npfs666/OPC_PCB/BOM + price.ods

Sheet: Carte acquisition
Reference | Qty | Value | Footprint | MF | MPN | px_x1 | px_x10 | ss tot
A1 | 1 | RaspberryPi_Pico | OPC:RaspberryPi_Pico_Common_THT_SIMPLE |  | SC1631 | 4,3 |  | 4,3
C1 | 1 | 220mF | Capacitor_THT:CP_Radial_D13,0mm_P5,00mm |  | 3-158-695 | 1,81 | 1,62 | 1,81
C2,C3,C4,C5,C6,C7,C8,C9,C11,C12 | 10 | 0,1µ 10V | Capacitor_SMD:C_0603_1608Metric_Pad1,08x0,95mm_HandSolder | Würth Elektronik | 885012206020 | 0,095 | 0,031 | 0,95
C10 | 1 | 0,1µ 10V | Capacitor_SMD:C_0603_1608Metric | Würth Elektronik | 885012206020 | 0,095 | 0,031 | 0,095
CCM1,CCM2,CCM3,CCM4 | 4 | 4,7n C0G | Capacitor_SMD:C_0805_2012Metric_Pad1,18x1,45mm_HandSolder | Murata | GCM1885C1H472JA16J | 0,129 | 0,051 | 0,516
CDi1,CDi2 | 2 | 47n C0G | Capacitor_SMD:C_1206_3216Metric_Pad1,33x1,80mm_HandSolder | Murata | GRM3195C1H473JA05D | 0,327 | 0,143 | 0,654
D1,D2 | 2 | D_Schottky | Diode_SMD:D_SMA | Vishay | B140-E3/61T | 0,318 | 0,195 | 0,636
J1,J2,J4 | 3 | 691382010004 | OPC:691382010004 | Würth Elektronik | 691382010004 | 4,6 | 0,98+3,07 | 13,8
R1,R4 | 2 | 1M | Resistor_SMD:R_0603_1608Metric_Pad0,98x0,95mm_HandSolder | Panasonic | ERJ-3EKF1004V | 0,086 | 0,021 | 0,172
R2 | 1 | 16k5 | Resistor_SMD:R_0603_1608Metric_Pad0,98x0,95mm_HandSolder | Panasonic | ERA-3ARB1652V | 0,619 | 0,446 | 0,619
R6,R7 | 2 | 3k3 | Resistor_SMD:R_0603_1608Metric_Pad0,98x0,95mm_HandSolder | Panasonic | ERA-3ARB332V | 0,344 | 0,25 | 0,688
R8,R10,R11,R12,R13 | 5 | 47 | Resistor_SMD:R_0603_1608Metric_Pad0,98x0,95mm_HandSolder | Panasonic | ERJ-3GEYJ470V | 0,086 | 0,02 | 0,43
R9 | 1 | 10k | Resistor_SMD:R_0603_1608Metric_Pad0,98x0,95mm_HandSolder | Panasonic | ERJ-3EKF1002V | 0,086 | 0,021 | 0,086
R14 | 1 | 220 | Resistor_SMD:R_0603_1608Metric_Pad0,98x0,95mm_HandSolder |  | ERJ-3GEYJ221V | 0,086 | 0,02 | 0,086
R15,R16 | 2 | 4k7 | Resistor_SMD:R_0603_1608Metric_Pad0,98x0,95mm_HandSolder | Panasonic | ERJ-3GEYJ472V | 0,086 | 0,02 | 0,172
RF1,RF2 | 2 | 6,04k | Resistor_SMD:R_0603_1608Metric_Pad0,98x0,95mm_HandSolder | Panasonic | ERA-3AED6041V | 0,086 | 0,052 | 0,172
RF3,RF4 | 2 | 5,23k | Resistor_SMD:R_0603_1608Metric_Pad0,98x0,95mm_HandSolder | Panasonic | ERA-3AEB5231V | 0,198 | 0,104 | 0,396
RN1,RN2,RN3 | 3 | 10k | Resistor_SMD:R_Array_Concave_4x0603 | Walsin | WA06X103JTL | 0,146 | 0,092 | 0,438
U1,U2,U4,U6,U9 | 5 | TS3A4751PWR | OPC:TSSOP-14_4,4x5mm_P0,65mm | Texas Instruments | TS3A4751PWR | 1,49 | 1,09 | 7,45
U3 | 1 | MCP23017x-x-ML | Package_DFN_QFN:QFN-28-1EP_6x6mm_P0,65mm_EP4,25x4,25mm | Microchip | MCP23017-E/ML | 1,58 | 1,57 | 1,58
U5 | 1 | ADS1120-PW | Package_SO:TSSOP-16_4,4x5mm_P0,65mm | Texas Instruments | ADS1120IPWR | 6,25 | 4,82 | 6,25
U7 | 1 | BMP581 | OPC:BMP581 | Bosch | BMP581 | 2,51 | 2,24 | 2,51
U8 | 1 | DS3231MZ | Package_SO:SOIC-8_3,9x4,9mm_P1,27mm |  | DS3231MZ+TRL | 10,9 | 8,57 | 10,9
 |  |  |  |  |  |  |  |  | sans options
 |  |  |  |  |  |  |  | 54,71 | 41,3

Sheet: ecran
Reference | Qty | Value | DNP | Exclude from BOM | Footprint | MF | MPN | px_1 | px_10 | ss tot
C1 | 1 | 1µ |  |  | Capacitor_SMD:C_0603_1608Metric_Pad1,08x0,95mm_HandSolder | Murata | GRM033R60G105MEA2D | 0,086 | 0,034 | 0,086
C2 | 1 | 4µ7 |  |  | Capacitor_SMD:C_0805_2012Metric_Pad1,18x1,45mm_HandSolder |  | GRM21BR71A475KE51K | 0,103 | 0,039 | 0,103
C3,C4,C5,C6 | 4 | 0,1µ |  |  | Capacitor_SMD:C_0603_1608Metric_Pad1,08x0,95mm_HandSolder | Würth Elektronik | 885012206020 | 0,095 | 0,031 | 0,38
J1,J2 | 2 | MEC1-110-02-F-D-A |  |  | OPC:SAMTEC_MEC1-110-02-F-D-A | Samtec | MEC1-110-02-F-D-A | 3,47 |  | 6,94
J3 | 1 | 1-2328724-5 |  |  | OPC:123287245 | TE Connectivity | 1-2328724-5 | 0,249 | 0,215 | 0,249
R1 | 1 | 10k |  |  | Resistor_SMD:R_0603_1608Metric_Pad0,98x0,95mm_HandSolder | Panasonic | ERJ-3EKF1002V | 0,086 | 0,021 | 0,086
R2 | 1 | 10 |  |  | PCM_Resistor_SMD_AKL:R_1206_3216Metric_Pad1,30x1,75mm | Panasonic | ERJ-U08J100V | 0,146 | 0,048 | 0,146
R3,R8,R9,R10,R11 | 5 | 6k8 |  |  | Resistor_SMD:R_0603_1608Metric_Pad0,98x0,95mm_HandSolder | Panasonic | ERJ-3EKF6801V | 0,086 | 0,021 | 0,43
R4,R5,R6,R7 | 4 | 47 |  |  | Resistor_SMD:R_0603_1608Metric_Pad0,98x0,95mm_HandSolder | Panasonic | ERJ-3GEYJ470V | 0,086 | 0,02 | 0,344
SW1 | 1 | PEC11L-4220K-S0015 |  |  | OPC:PEC11L4220KS0015 | Bourns | PEC11L-4220K-S0015 | 2,13 | 1,78 | 2,13
U1 | 1 | IPS 240*240 display |  |  |  | Mikroe | MIKROE-6588 | 12,04 | 12,04 | 12,04
 |  |  |  |  |  |  |  |  |  | 22,934

Sheet: puissance
Reference | Qty | Value | DNP | Footprint | MF | MPN | px_1 | px_10
C1,C2 | 2 | 4µ7 50V |  | Capacitor_SMD:C_1206_3216Metric |  | GRM319R61H475KA12D | 0,206 | 0,084 | 0,412
C3,C6 | 2 | 10n 100V |  | Capacitor_SMD:C_0603_1608Metric |  | GRM188R72A103MA01J | 0,086 | 0,02 | 0,172
C4 | 1 | 10µ 10V |  | Capacitor_SMD:C_0603_1608Metric_Pad1,08x0,95mm_HandSolder |  | GRM188R61A106ME69D | 0,103 | 0,04 | 0,103
C5 | 1 | 47µ 50V |  | PCM_Capacitor_SMD_AKL:CP_Elec_6,3x7,7 |  | 865080645012 | 0,292 | 0,287 | 0,292
C7,C9,C10 | 3 | 0,1µ 10V |  | Capacitor_SMD:C_0603_1608Metric_Pad1,08x0,95mm_HandSolder | Würth Elektronik | 885012206020 | 0,095 | 0,031 | 0,285
C8,C12 | 2 | 1µ 50V |  | Capacitor_SMD:C_0805_2012Metric_Pad1,18x1,45mm_HandSolder | Murata | GRM219R61H105MA73D | 0,129 | 0,052 | 0,258
C11 | 1 | 0,1µ 50V |  | Capacitor_SMD:C_0603_1608Metric_Pad1,08x0,95mm_HandSolder |  | GCM188L81H104MA57D | 0,095 | 0,035 | 0,095
C13 | 1 | 1n 2kV |  | Capacitor_SMD:C_1206_3216Metric |  | 885342208024 | 0,198 | 0,116 | 0,198
C14,C15 | 2 | 10n 100V |  | Capacitor_SMD:C_0603_1608Metric_Pad1,08x0,95mm_HandSolder |  | GRM188R72A103MA01J | 0,086 | 0,02 | 0,172
D1,D4,D5 | 3 | FR1G |  | Diode_SMD:D_SMA |  | FR1G | 0,095 | 0,066 | 0,285
D2,D3 | 2 | SMAJ33CA |  | PCM_Diode_SMD_AKL:D_SMA_TVS |  | 824501331 | 0,318 | 0,297 | 0,636
F1 | 1 | 100mA |  | Fuse:Fuse_1210_3225Metric |  | 0ZCH0010FF2E | 0,155 | 0,114 | 0,155
J4 | 1 | 1705566 |  | 1705566 | Phoenix | 1705566 | 3,2 | 3,2 | 3,2
J5,J6 | 2 | 1725672 |  | 1725672 | Phoenix | 1725672 | 2,47 | 2,47 | 4,94
K1,K2 | 2 | G6DN-1A-L DC24 |  | OPC:G6DN |  | G6DN-1A-L DC24 | 2,42 | 2,22 | 4,84
L1 | 1 | 1µ 2A |  | Inductor_SMD:L_1008_2520Metric | Taiyo yuden | MAMK2520T1R0M | 0,138 | 0,112 | 0,138
OC1 | 1 | MOCD217M |  | PCM_Package_SO_AKL:SO-8_3,9x6,2mm_P1,27mm |  | MOCD217M | 0,869 | 0,573 | 0,869
Q1,Q2 | 2 | 2N7002 |  | PCM_Package_TO_SOT_SMD_AKL:SOT-23 | Toshiba | T2N7002BK,LM |  |  | 0
R2,R5 | 2 | 560 |  | Resistor_SMD:R_0603_1608Metric |  | ERJ-3GEYJ560V | 0,086 | 0,02 | 0,172
R3,R6 | 2 | 2k4 |  | Resistor_SMD:R_0805_2012Metric_Pad1,20x1,40mm_HandSolder |  | ERJ-6GEYJ242V | 0,086 | 0,025 | 0,172
R7 | 1 | 33k |  | Resistor_SMD:R_0603_1608Metric_Pad0,98x0,95mm_HandSolder |  | ERJ-3GEYJ333V | 0,086 | 0,02 | 0,086
R8,R12 | 2 | 47k |  | Resistor_SMD:R_0603_1608Metric_Pad0,98x0,95mm_HandSolder |  | ERJ-3GEYJ473V | 0,086 | 0,02 | 0,172
R9,R13 | 2 | 470 |  | Resistor_SMD:R_0603_1608Metric_Pad0,98x0,95mm_HandSolder |  | ERJ-3GEYJ470V | 0,086 | 0,02 | 0,172
R10,R11 | 2 | 1k5 |  | Resistor_SMD:R_0603_1608Metric_Pad0,98x0,95mm_HandSolder |  | ERJ-3GEYJ152V | 0,086 | 0,02 | 0,172
RV1,RV2 | 2 | MOV-07D391KKTR |  | Varistor:RV_Disc_D9mm_W3,9mm_P5mm | Bourns | MOV-07D391KKTR | 0,129 | 0,078 | 0,258
TP1,TP2 | 2 | TestPoint |  | TestPoint:TestPoint_Pad_2,0x2,0mm |  |  |  |  | 0
U1 | 1 | SIP-4_1779205311 |  | PCM_MagIC_THT_Wurth:U_Wurth_WPME-FISM-SIP-4_1779405311 |  | 1779205311 | 2,73 | 2,51 | 2,73
U2 | 1 | ISO1212 |  | Package_SO:SSOP-16_3,9x4,9mm_P0,635mm |  | ISO1212DBQR | 1,14 | 0,828 | 1,14
U3 | 1 | DRV81545PWPR |  | OPC:U_TSSOP_PWP0020AC_TEX |  | DRV81545PWPR | 2,43 | 1,81 | 2,43
U4 | 1 | ISO6420FDR |  | Package_SO:SOIC-8_3,9x4,9mm_P1,27mm |  | ISO6420FDR | 1,26 | 0,92 | 1,26
U5 | 1 | TLV709A50DBVR |  | Package_TO_SOT_SMD:SOT-23-5 |  | TLV709A50DBVR | 0,499 | 0,352 | 0,499
 |  |  |  |  |  |  |  |  | 26,313
