npfs666/OPC_PCB/3D/Assemblage.FCStd

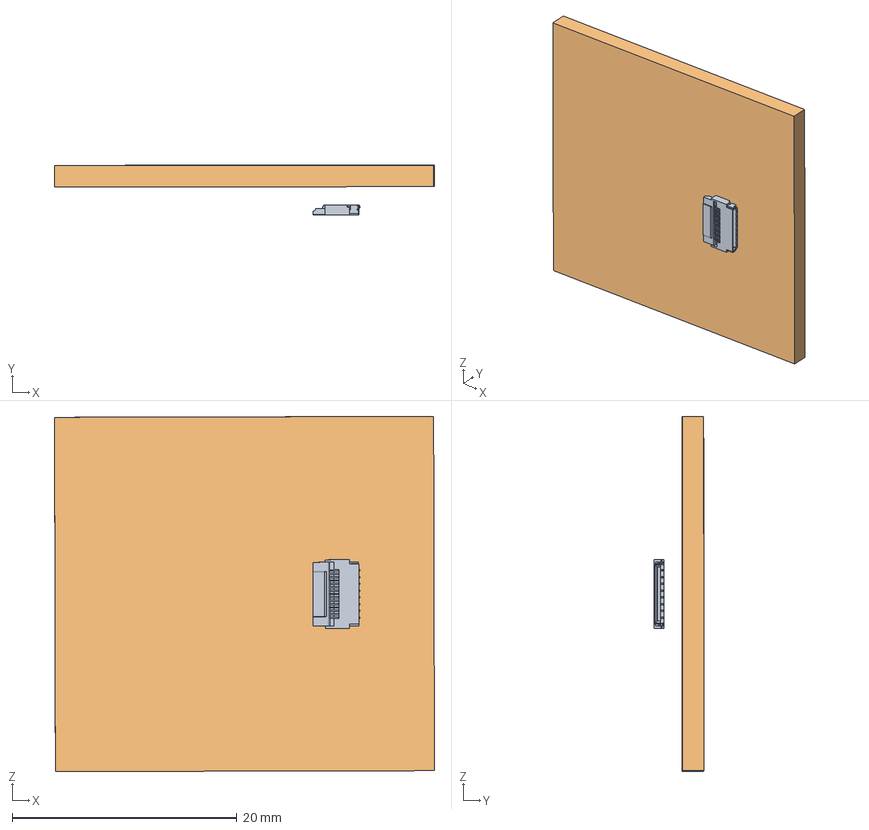
[picture p1: CAD file, 2026-10-04]
3D/Assemblage.FCStd
33.8 x 4.44 x 31.6 mm
FH35-15S-0.3SHW
Extruded
Extruded001
