npfs666/OPC_PCB/3D/6mm knob.FCStd

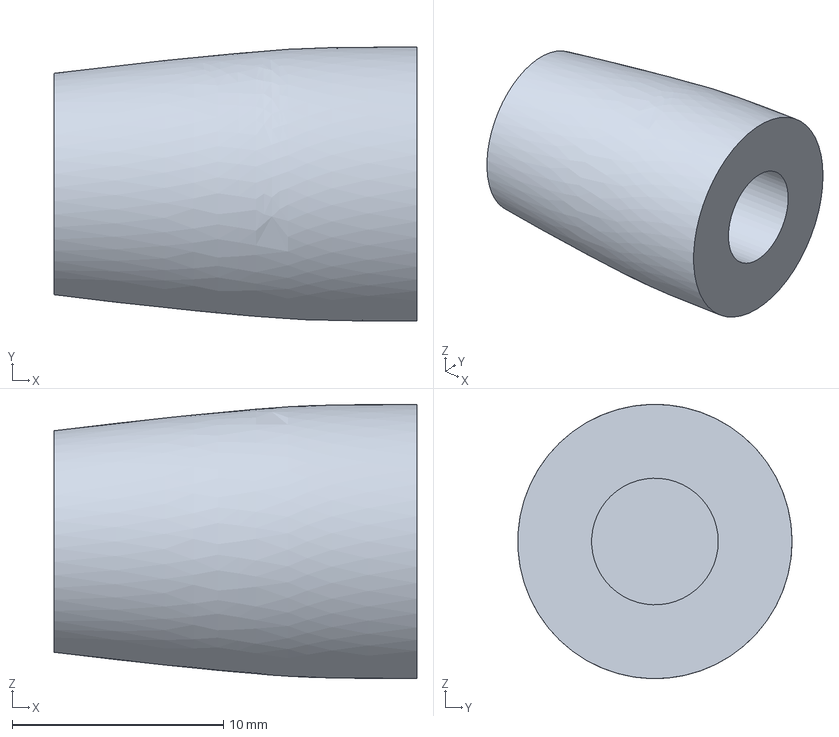
[picture p2: CAD file, 2026-10-04]
3D/6mm knob.FCStd
17.2 x 13.0 x 13.0 mm
