npfs666/OPC_PCB/3D/STL prints/Boite Mesure-Body.step

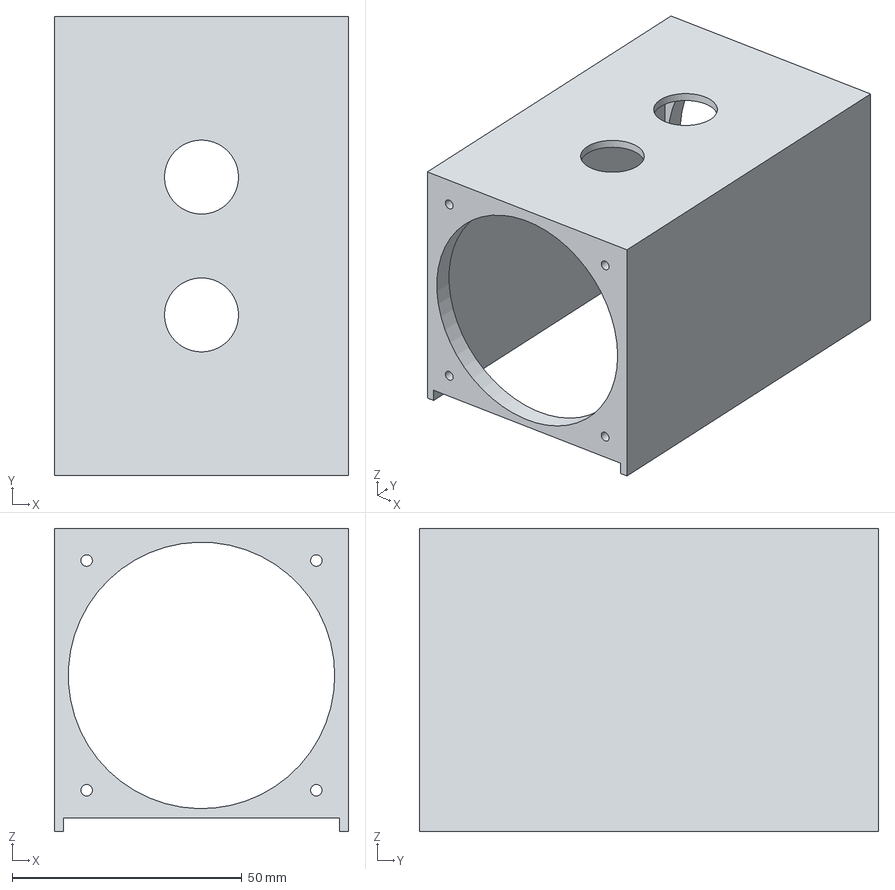
[picture p3: CAD file, 2026-10-04]
3D/STL prints/Boite Mesure-Body.step
64.0 x 100.0 x 66.0 mm
