npfs666/OPC_PCB/3D/Boitier_OPC.FCStd

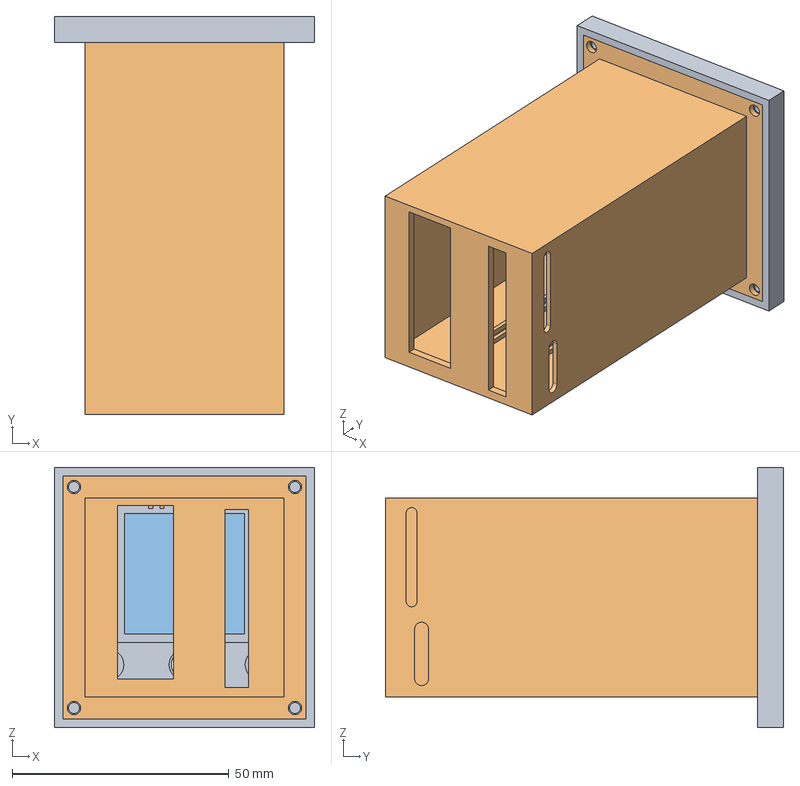
[picture p5: CAD file, 2026-10-04]
3D/Boitier_OPC.FCStd
60.0 x 91.9 x 60.0 mm
Facade
Arriere
Vitre
