npfs666/OPC_PCB/3D/STL prints/Boitier_OPC-Facade45.step

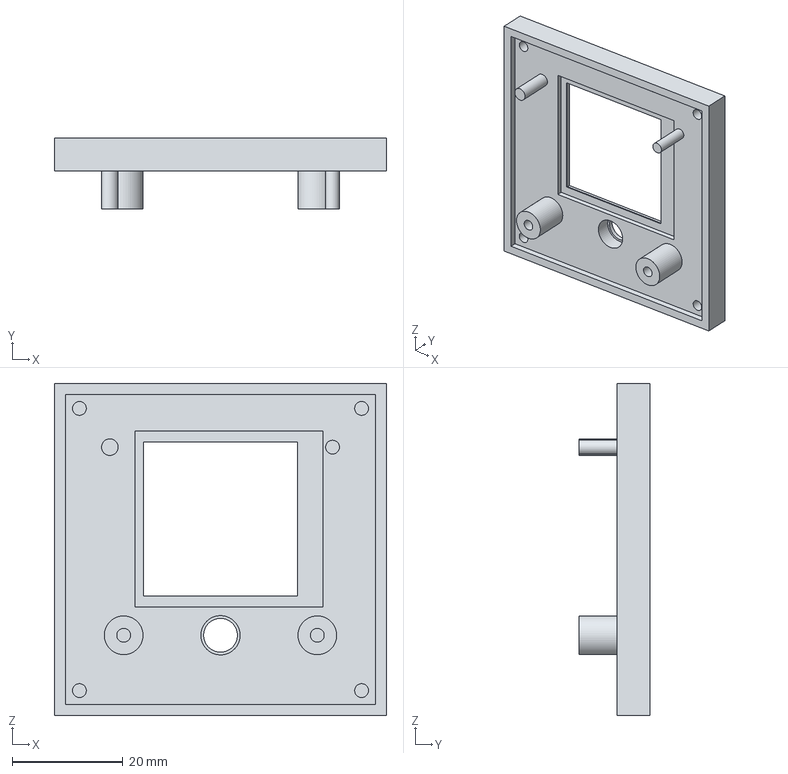
[picture p6: CAD file, 2026-08-16]
3D/STL prints/Boitier_OPC-Facade45.step
60.0 x 12.9 x 60.0 mm
