npfs666/OPC_PCB/3D/PCB_ecran.FCStd

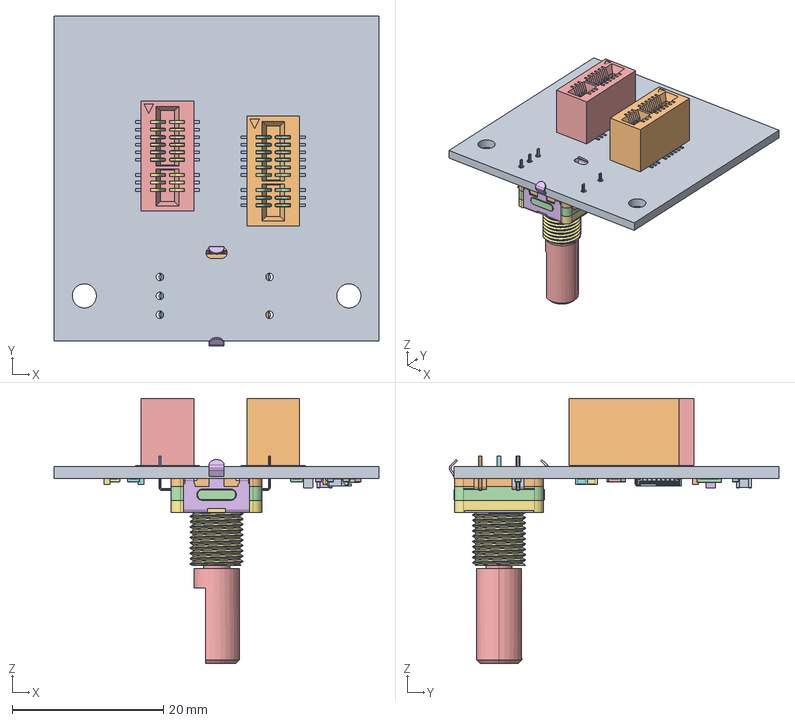
[picture p7: CAD file, 2026-08-16]
3D/PCB_ecran.FCStd
43.0 x 43.6 x 35.1 mm
Pcb_9aaa
MEC1-110-02-F-D-A_terminal
MEC1-C-113-02-F-10_pin
MEC1-C-113-02-F-102_pin
MEC1-110-02-F-D-A_terminal001
MEC1-C-113-02-F-10_pin001
MEC1-C-113-02-F-102_pin001
C6_C_0603_1608Metric_2552904a9884
J3_C-1-2328724-5_19a50cf26e37
R5_R_0603_1608Metric_0a1e323faf72
R6_R_0603_1608Metric_497e6d2832c1
R2_R_1206_3216Metric_877dde5deaf9
R4_R_0603_1608Metric_065002c58806
C2_C_0805_2012Metric_6c8c6bc15dad
C5_C_0603_1608Metric_723fca460faf
R1_R_0603_1608Metric_dbec9712c61c
PEC11L-4220F-S0015
PEC11L-4220F-S0016
PEC11L-4220F-S0017
PEC11L-4220F-S0018
PEC11L-4220F-S0019
PEC11L-4220F-S0020
PEC11L-4220F-S0021
PEC11L-4220F-S0022
PEC11L-4220F-S0023
PEC11L-4220F-S0024
R3_R_0603_1608Metric_c50a7346d287
R9_R_0603_1608Metric_962ce42e6f63
R10_R_0603_1608Metric_915b5a0c96dd
R7_R_0603_1608Metric_e5aef8b9e686
R8_R_0603_1608Metric_b2a26d5552b2
R11_R_0603_1608Metric_a8d6c201e3ff
C1_C_0805_2012Metric_96cc4482445c
C3_C_0603_1608Metric_796de0005f35
C4_C_0603_1608Metric_e30e64fcb925
