npfs666/OPC_PCB/3D/STL prints/Boitier_OPC-Vitre.step

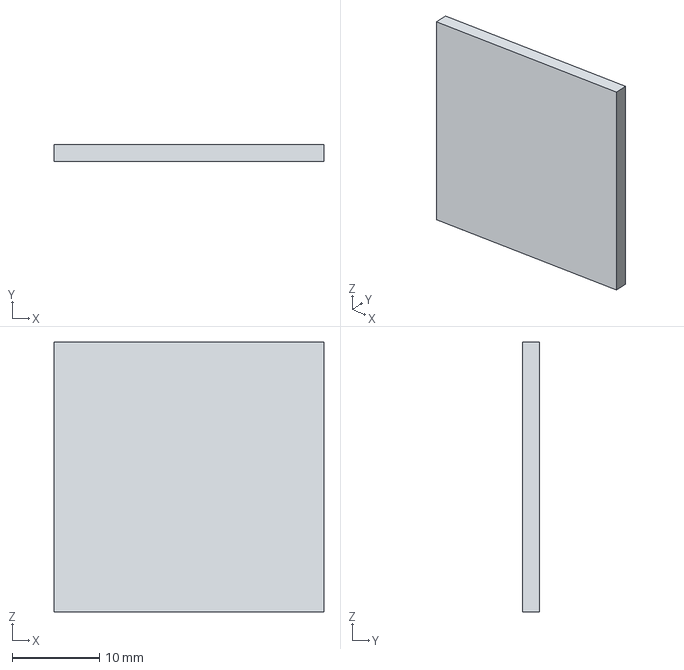
[picture p8: CAD file, 2026-08-16]
3D/STL prints/Boitier_OPC-Vitre.step
31.0 x 2.00 x 31.0 mm
