npfs666/OPC_PCB/3D/PCB_Sensor.FCStd

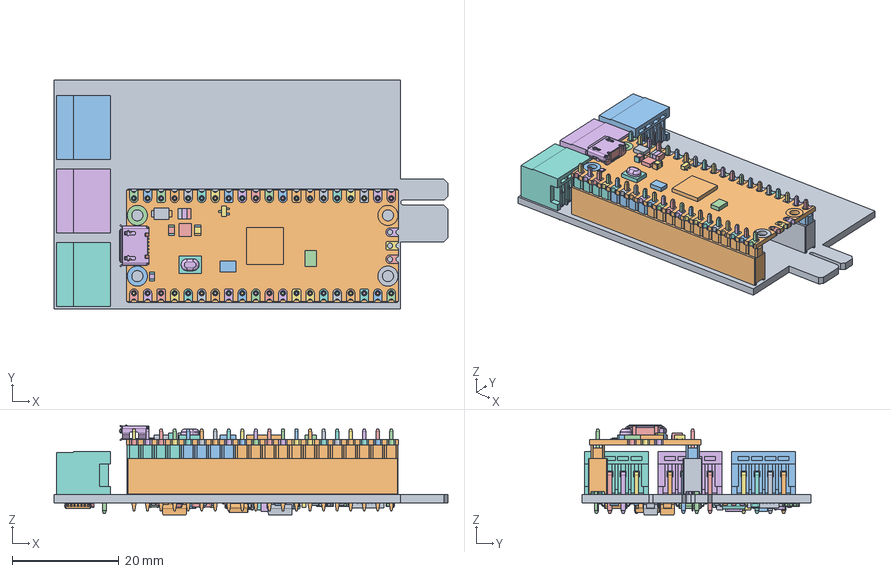
[picture p9: CAD file, 2026-08-16]
3D/PCB_Sensor.FCStd
73.9 x 43.0 x 16.9 mm
Pcb_7baf
6913820100xx_PIN
6913820100xx_PIN001
6913820100xx_PIN002
6913820100xx_PIN003
6913820100xx_PIN004
6913820100xx_PIN005
6913820100xx_PIN006
6913820100xx_PIN007
6913820100xx_PIN008
6913820100xx_PIN009
6913820100xx_PIN010
6913820100xx_PIN011
20 pin female header
20 pin female header001
BASE, 2
BASE, 001
PIN, 2
PIN, 001
PIN, 002
PIN, 003
PIN, 004
PIN, 005
PIN, 006
PIN, 007
PIN, 008
PIN, 009
PIN, 010
PIN, 011
PIN, 012
PIN, 013
PIN, 014
PIN, 015
BASE, 003
BASE, 004
PIN, 016
PIN, 017
PIN, 018
PIN, 019
PIN, 020
PIN, 021
PIN, 022
PIN, 023
PIN, 024
PIN, 025
PIN, 026
PIN, 027
PIN, 028
PIN, 029
PIN, 030
PIN, 031
CCM3_C_0805_2012Metric_d980f71a589e
C8_C_0603_1608Metric_d53725665cb9
R11_R_0603_1608Metric_c4df503dc09c
U9_TSSOP_14_44x5mm_P065mm_3e52fa5831e7
R12_R_0603_1608Metric_dfbaef41468b
C3_C_0603_1608Metric_79f205ab488b
C7_C_0603_1608Metric_75332eca0edc
C10_C_0603_1608Metric_9cd8411a2588
C2_C_0603_1608Metric_f4a086c790f2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
