npfs666/OPC_PCB/3D/STL prints/Boitier_OPC-Slice_2.step

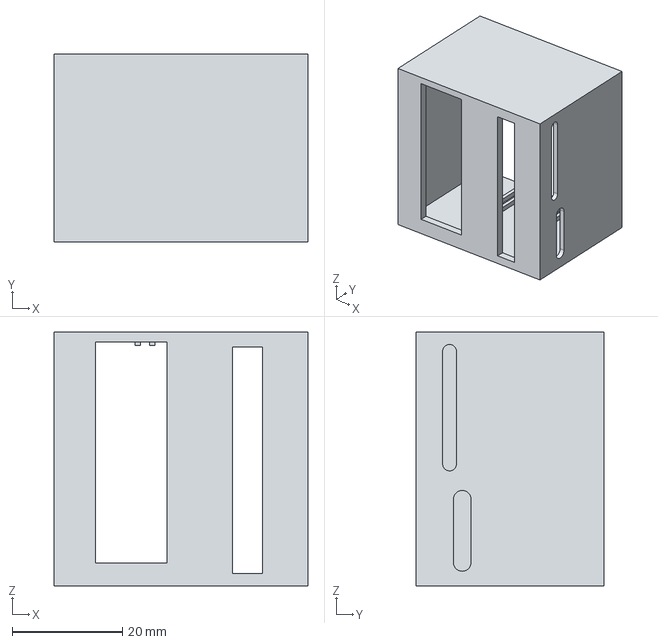
[picture p10: CAD file, 2026-08-16]
3D/STL prints/Boitier_OPC-Slice_2.step
46.0 x 34.0 x 46.0 mm
