npfs666/OPC_PCB/3D/PCB_puissance.FCStd

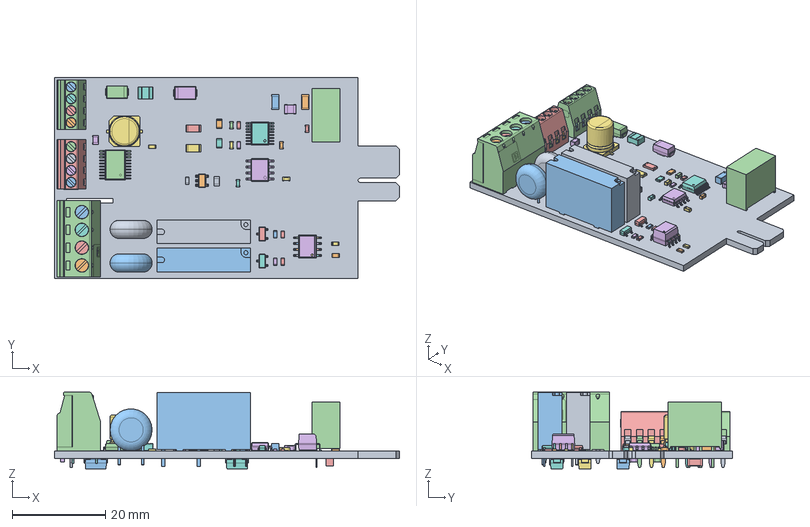
[picture p11: CAD file, 2026-08-16]
3D/PCB_puissance.FCStd
73.9 x 43.0 x 16.4 mm
Pcb_7ee1
U5_SOT_23_5_db93839da8bd
K2_G6DN_1A_1eaa12ef6025
D1_D_SMA_ead7eee86b1e
R2_R_0603_1608Metric_72819c8fc875
U4_SOIC_8_39x49mm_P127mm_66c8ce6ac40a
R6_R_1206_3216Metric_ccbe725341a1
Q1_SOT_23_8c6504fbc0d0
L1_L_1008_2520Metric_82d9ebbb4115
R7_R_0603_1608Metric_d6ba43f05b82
Q2_SOT_23_b353400c8843
C12_C_0805_2012Metric_e3668163eefe
C2_C_1206_3216Metric_8e86de64821f
C1_C_1206_3216Metric_89a4e08c66be
U1_1779205211_transformed_cba61204e552
R9_R_0603_1608Metric_76b49f282753
C8_C_0805_2012Metric_ccc1b0032e88
C5_CP_Elec_63x77_e46e0a750ea6
F1_Fuse_1210_3225Metric_23aa0c04b2ee
K1_G6DN_1A_cf8bbd98a6a8
R11_R_0603_1608Metric_baf0d1365cc7
R8_R_0603_1608Metric_1685e2c74f9a
U3_HTSSOP_20_1EP_44x65mm_P065mm_EP34x65mm_Mask275x343mm_5fb93dbf0cd6
C4_C_0603_1608Metric_a2565f49aee5
R12_R_0603_1608Metric_c193ec158065
C9_C_0603_1608Metric_ea4e39f511a3
C10_C_0603_1608Metric_e35af573af21
R5_R_0603_1608Metric_72aadfdc2f61
R10_R_0603_1608Metric_472293205d83
R13_R_0603_1608Metric_e67fa9fbaa23
FOD8012A
FOD8012A001
FOD8012A002
FOD8012A003
FOD8012A004
FOD8012A005
FOD8012A006
FOD8012A007
FOD8012A008
FOD8012A009
U2_SSOP_16_39x49mm_P0635mm_dab7feac6744
RV1_RV_Disc_D9mm_W39mm_P5mm_5f8b049132af
R1_R_0805_2012Metric_082767cc33e7
RV2_RV_Disc_D9mm_W39mm_P5mm_5016e79d4bc0
C3_C_0603_1608Metric_83b09f9fbce3
R3_R_1206_3216Metric_9395171baa16
D2_D_SMA_172067eb3ad8
C6_C_0603_1608Metric_04c9d46bab36
R4_R_0805_2012Metric_cb24a76329c7
C11_C_0603_1608Metric_73f2376235a9
C7_C_0603_1608Metric_e459c9bc8b46
D3_D_SMA_5956bfb86b07
C14_C_0603_1608Metric_9c92008615f6
C13_C_1206_3216Metric_ac10733bc9e7
C15_C_0603_1608Metric_935e547a122e
D4_D_SMA_7b4a95e975e1
D5_D_SMA_3df182d4667d
