npfs666/OPC_PCB/3D/STL prints/Boitier_OPC-Slice.55.step

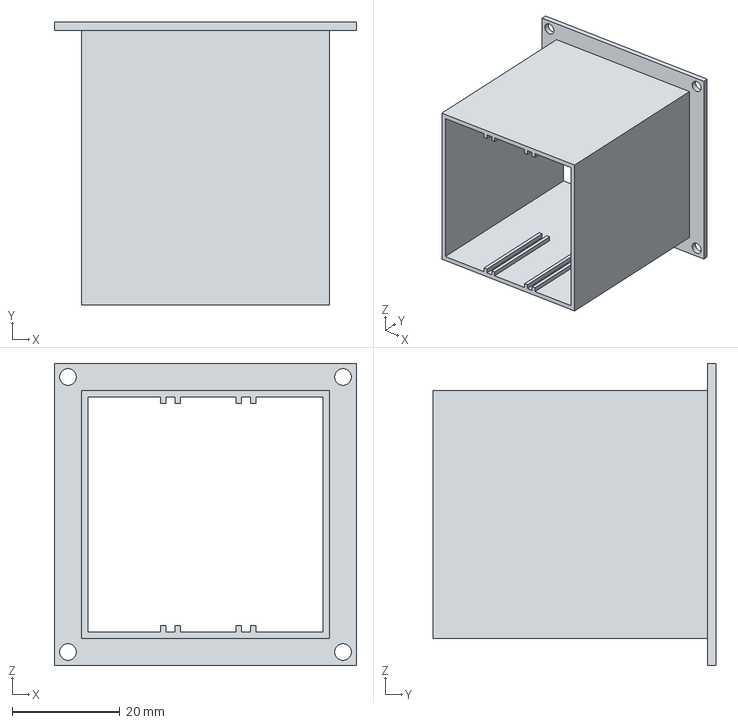
[picture p12: CAD file, 2026-08-16]
3D/STL prints/Boitier_OPC-Slice.55.step
56.0 x 52.4 x 56.0 mm
