npfs666/OPC_PCB/3D/STL prints/Boitier_OPC-Slice.45.step

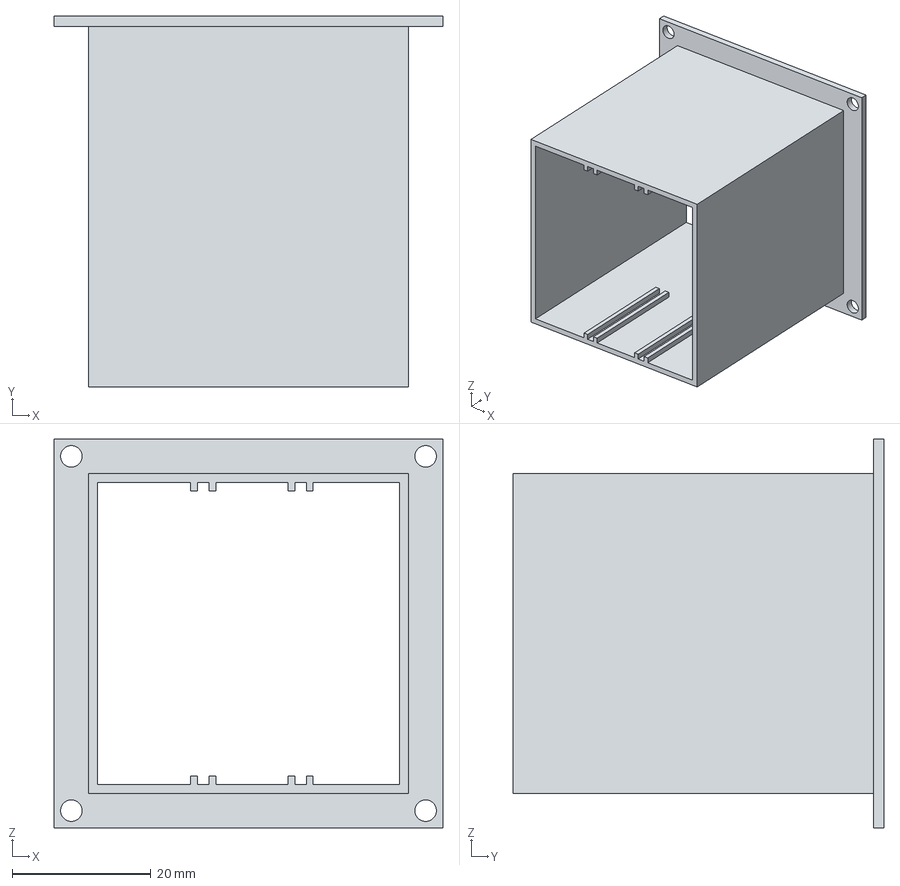
[picture p13: CAD file, 2026-08-16]
3D/STL prints/Boitier_OPC-Slice.45.step
56.0 x 53.4 x 56.0 mm
