npfs666/OPC_PCB/3D/Boitier 3D.FCStd

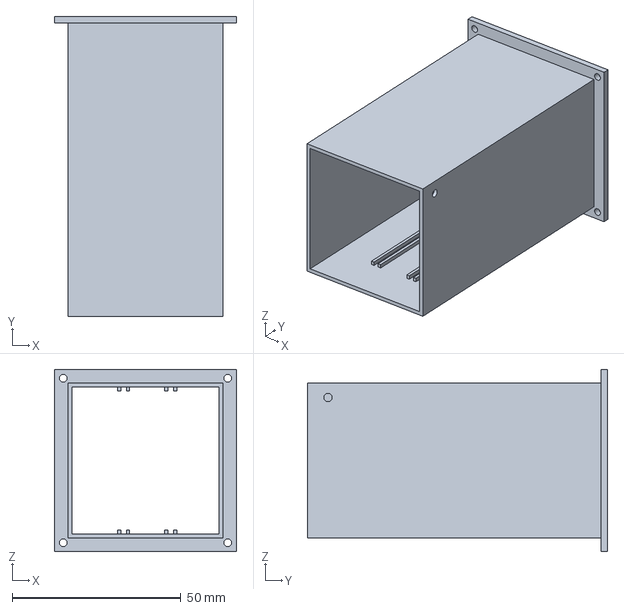
[picture p14: CAD file, 2026-08-11]
3D/Boitier 3D.FCStd
54.0 x 89.0 x 54.0 mm
