npfs666/OPC_PCB/3D/STL prints/OPC_facade_0.1.step

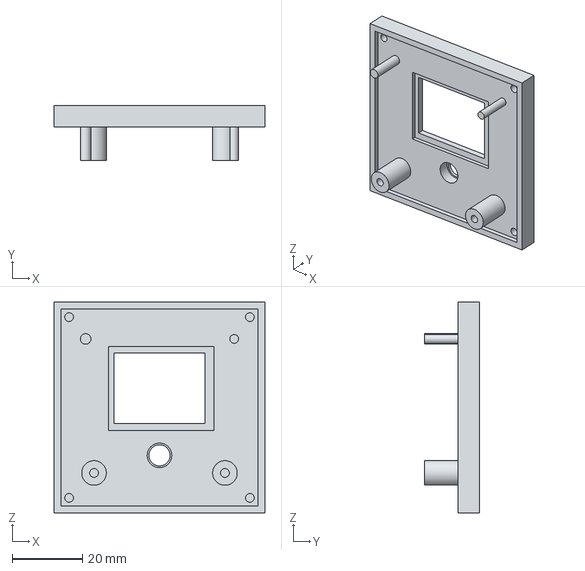
[picture p15: CAD file, 2026-08-14]
3D/STL prints/OPC_facade_0.1.step
60.0 x 15.5 x 60.0 mm
