npfs666/OPC_PCB/3D/ecran.FCStd

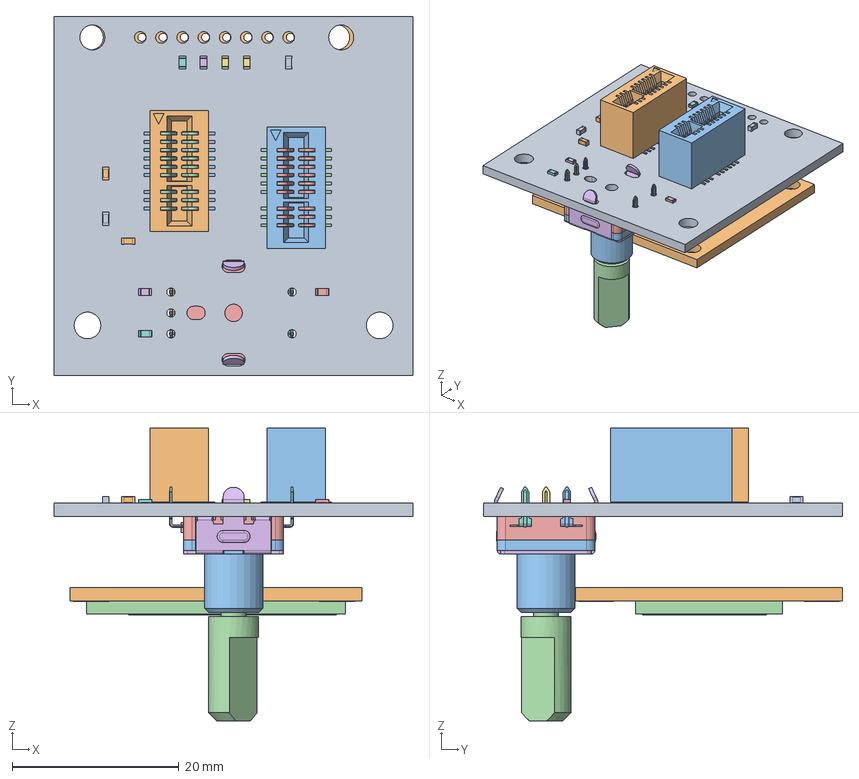
[picture p16: CAD file, 2026-08-07]
3D/ecran.FCStd
43.0 x 43.0 x 35.1 mm
Pcb_fb9e
C13_C_0603_1608Metric_2552904a9884
MEC1-110-02-F-D-A_terminal
MEC1-C-113-02-F-10_pin
MEC1-C-113-02-F-102_pin
R12_R_0603_1608Metric_0a1e323faf72
R14_R_0603_1608Metric_497e6d2832c1
R11_R_0603_1608Metric_0ae304a62e9f
C14_C_0603_1608Metric_723fca460faf
MEC1-110-02-F-D-A_terminal001
MEC1-C-113-02-F-10_pin001
MEC1-C-113-02-F-102_pin001
R16_R_0603_1608Metric_962ce42e6f63
R17_R_0603_1608Metric_915b5a0c96dd
R13_R_0603_1608Metric_e5aef8b9e686
R18_R_0603_1608Metric_a8d6c201e3ff
C12_C_0603_1608Metric_796de0005f35
C15_C_0603_1608Metric_e30e64fcb925
EC11-Base
EC11-Shaft-F
EC11-Housing-THT
EC11-Housing-THT001
EC11-Housing-THT002
EC11-Housing-THT003
EC11-Housing-THT004
EC11-Housing-THT005
EC11-Housing-THT006
Dalle LCD approx. 31 x 17.6 mm
Zone active 24.912 x 14.864 mm
Pastille connecteur 8
Pastille connecteur 7
Pastille connecteur 6
Pastille connecteur 5
Pastille connecteur 4
Pastille connecteur 3
Pastille connecteur 2
Pastille connecteur 1
Pastille fixation 4
Pastille fixation 3
Pastille fixation 2
Pastille fixation 1
PCB 35 x 32 x 1.6 mm
