npfs666/OPC_PCB/3D/STL prints/Barofnet-back.stl

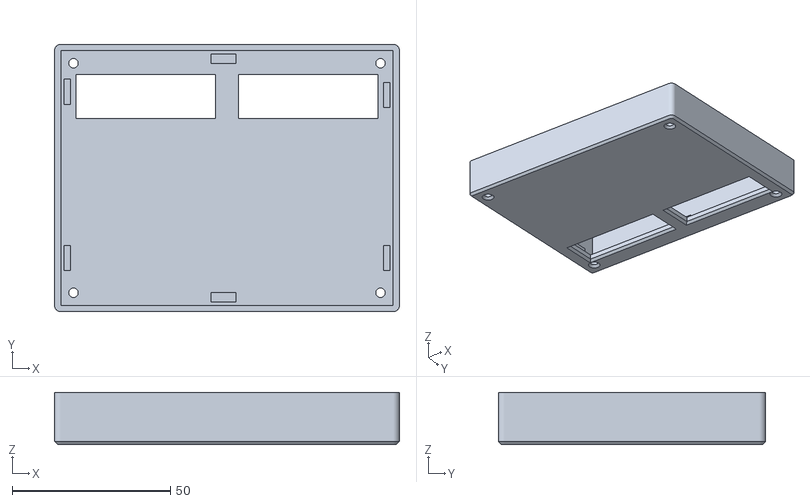
[picture p17: CAD file, 2026-08-14]
3D/STL prints/Barofnet-back.stl
109.0 x 84.5 x 16.5
