npfs666/OPC_PCB/3D/STL prints/Barofnet-front.stl

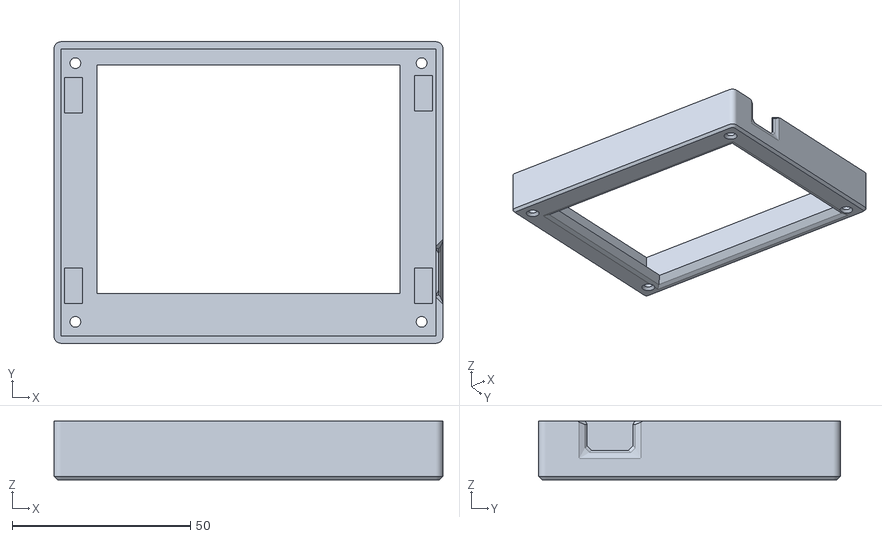
[picture p18: CAD file, 2026-08-14]
3D/STL prints/Barofnet-front.stl
109.0 x 84.5 x 16.5
