npfs666/OPC_PCB/(list of files, cad)

Other CAD files:
3D/Boite Mesure.FCStd
3D/STL prints/Boite Mesure-haut.stl
3D/Old opc/OPC.FCStd
3D/Old opc/OPC_test_save.FCStd
3D/Old opc/assembly.FCStd
