npfs666/OPC_PCB/Pdf/Carte entrée.pdf

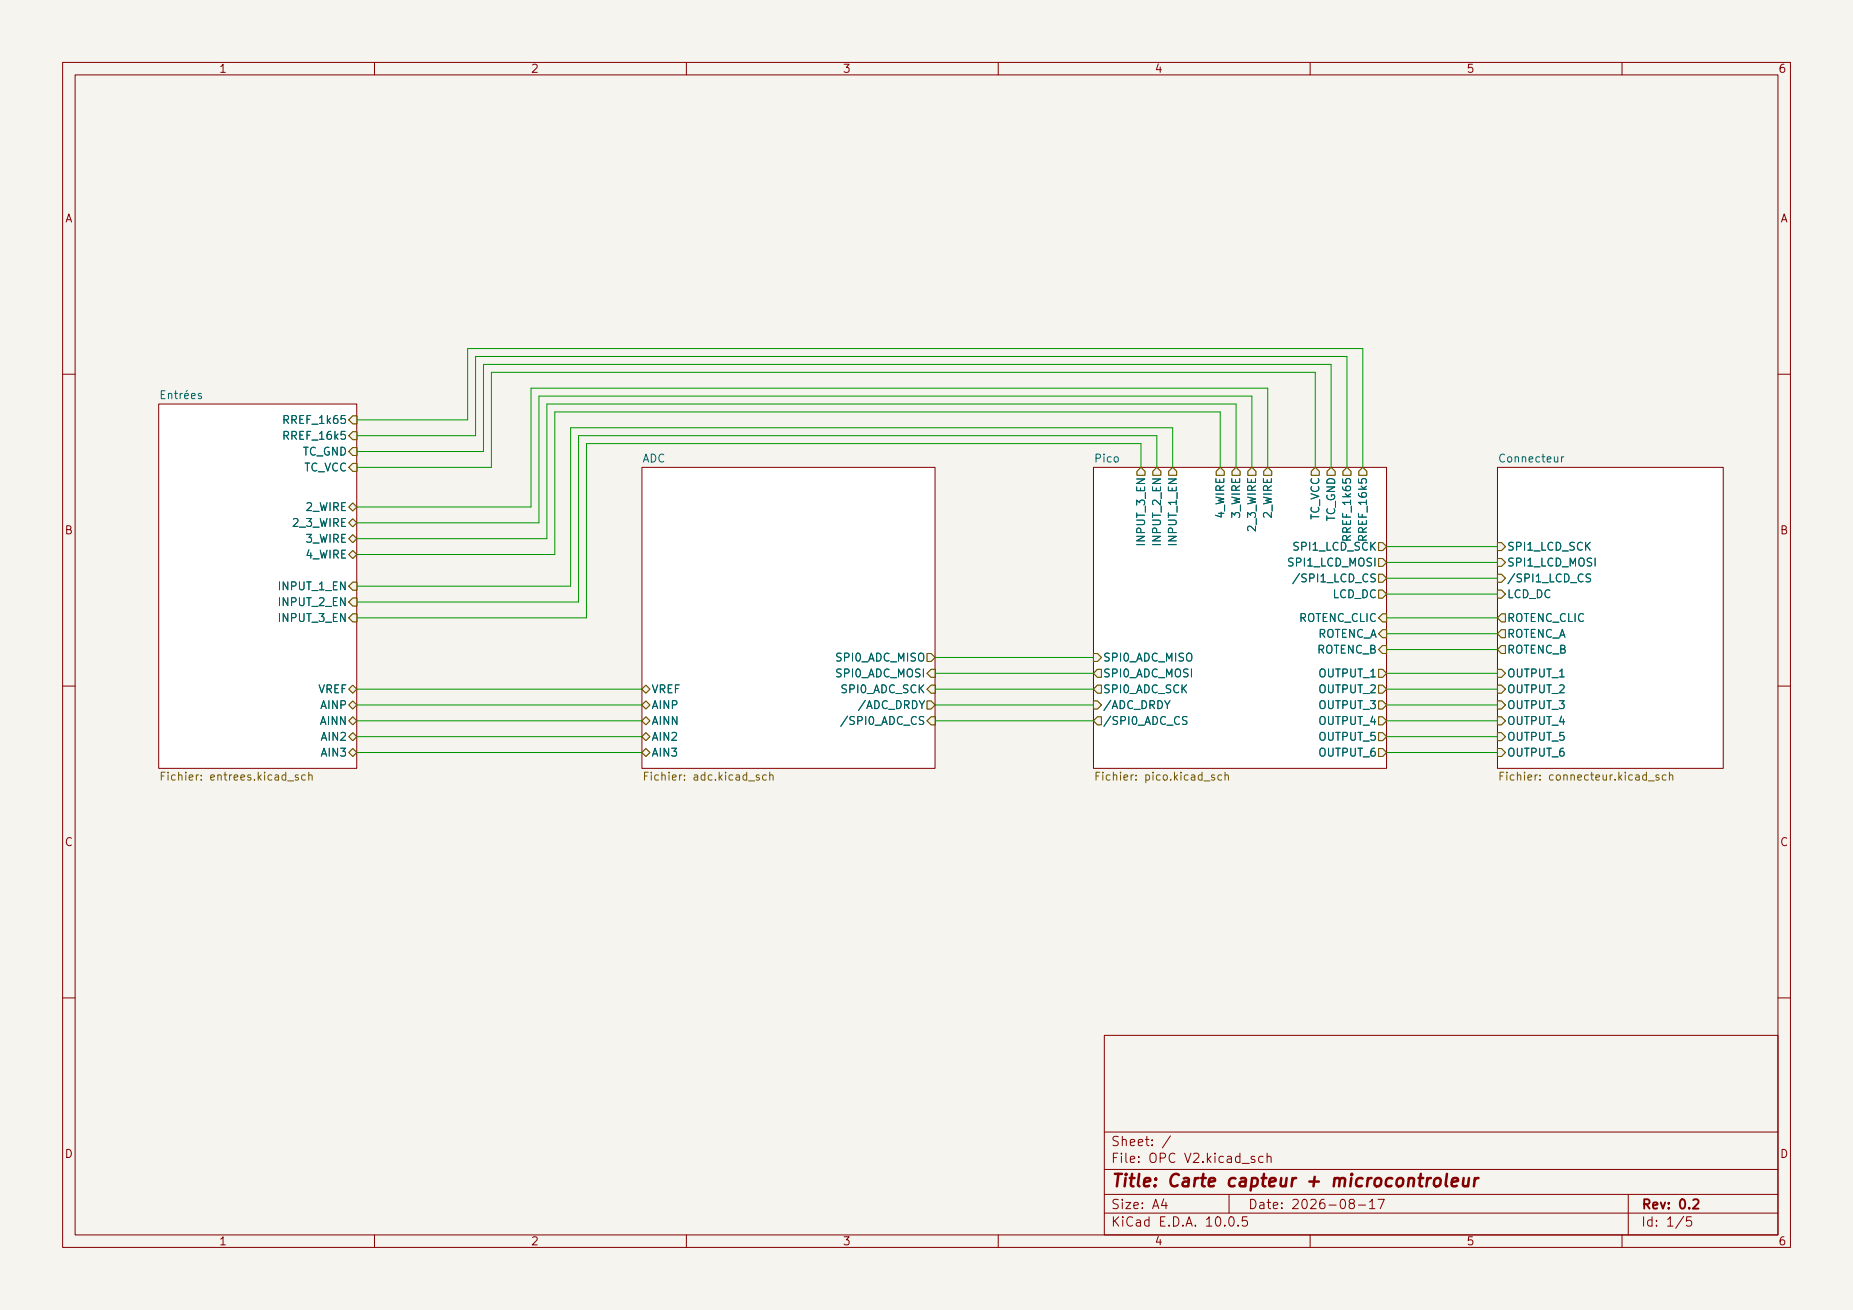
[picture p19: page 1]

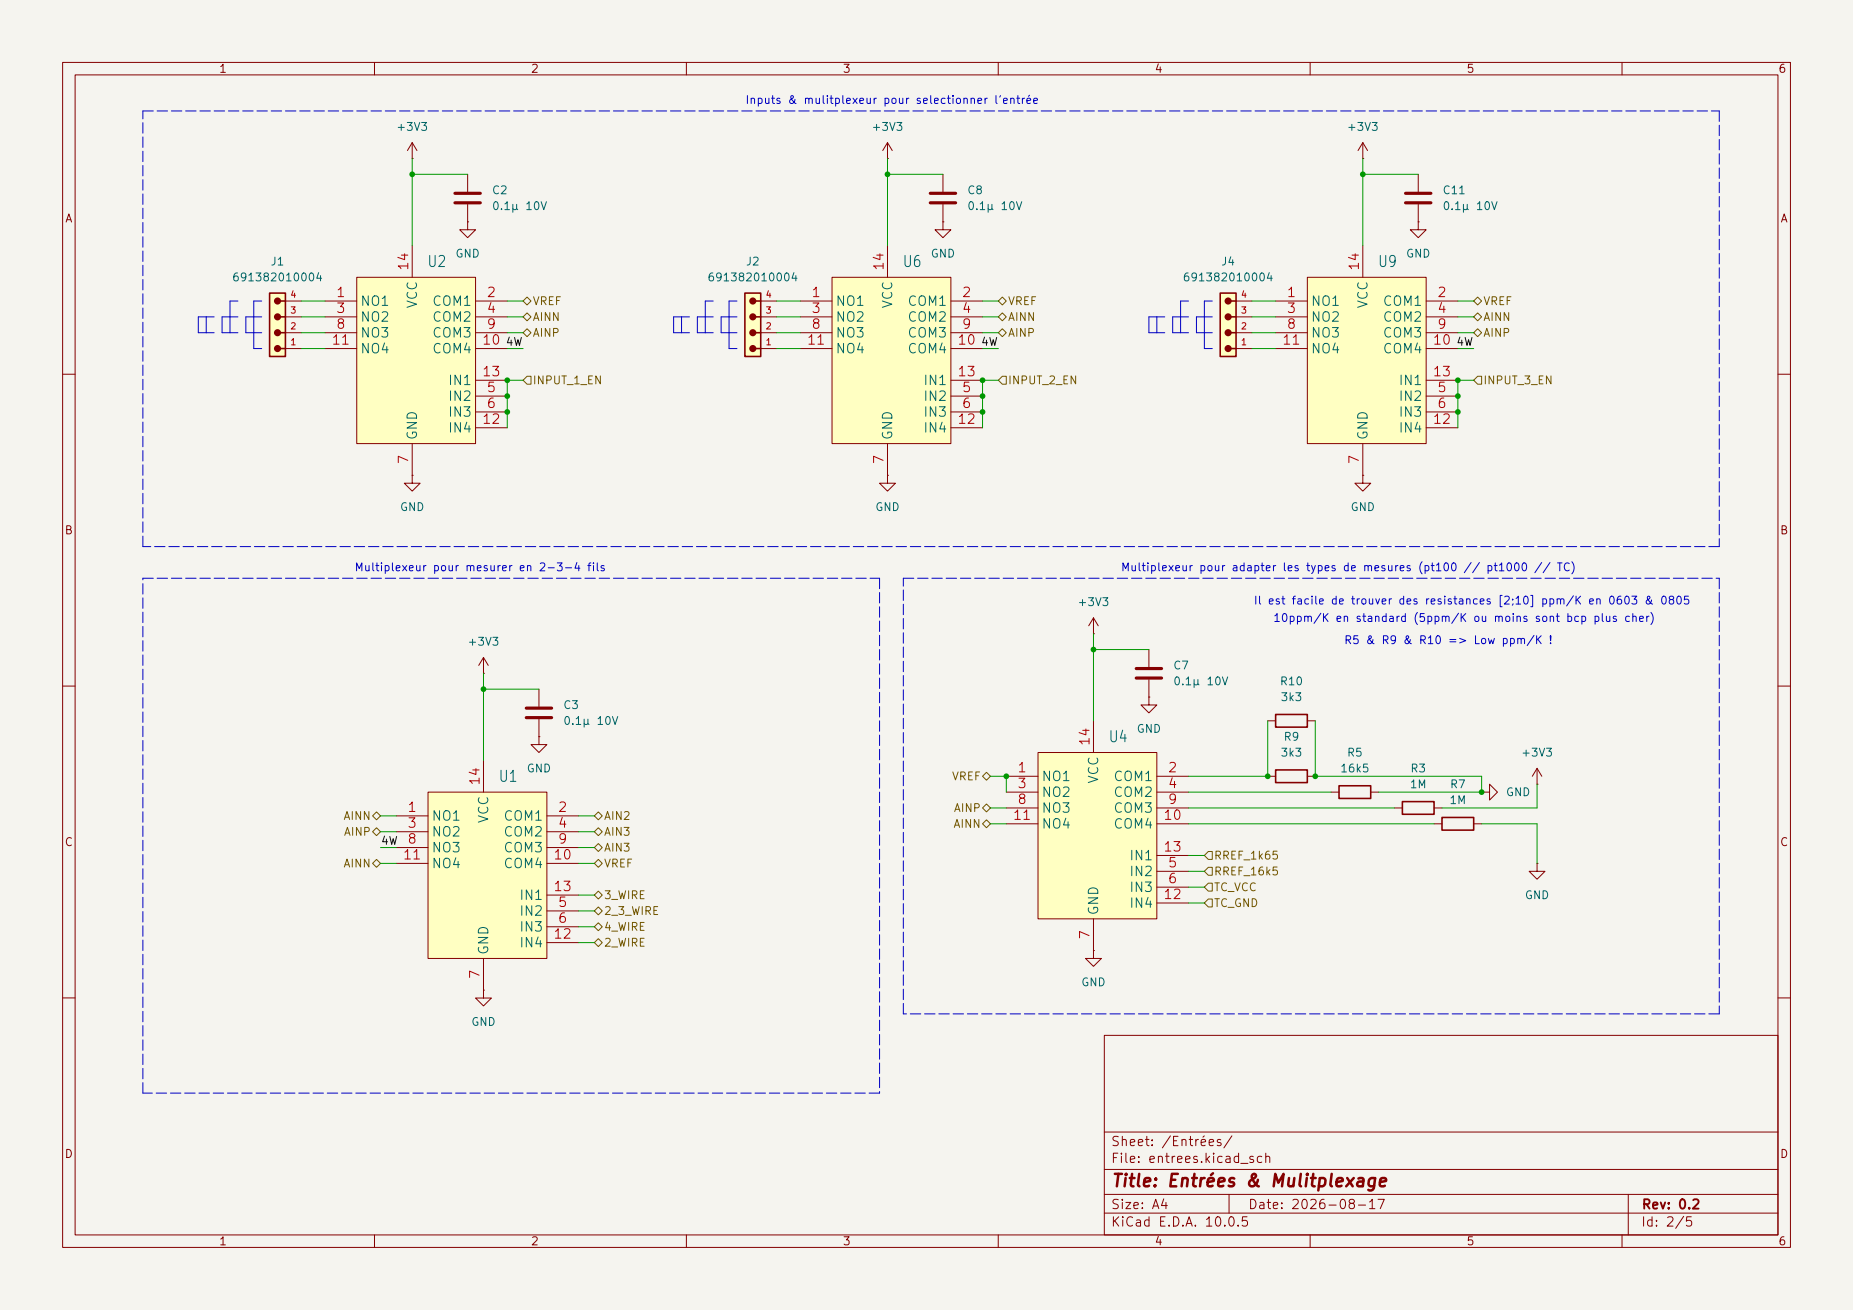
[picture p20: page 2]

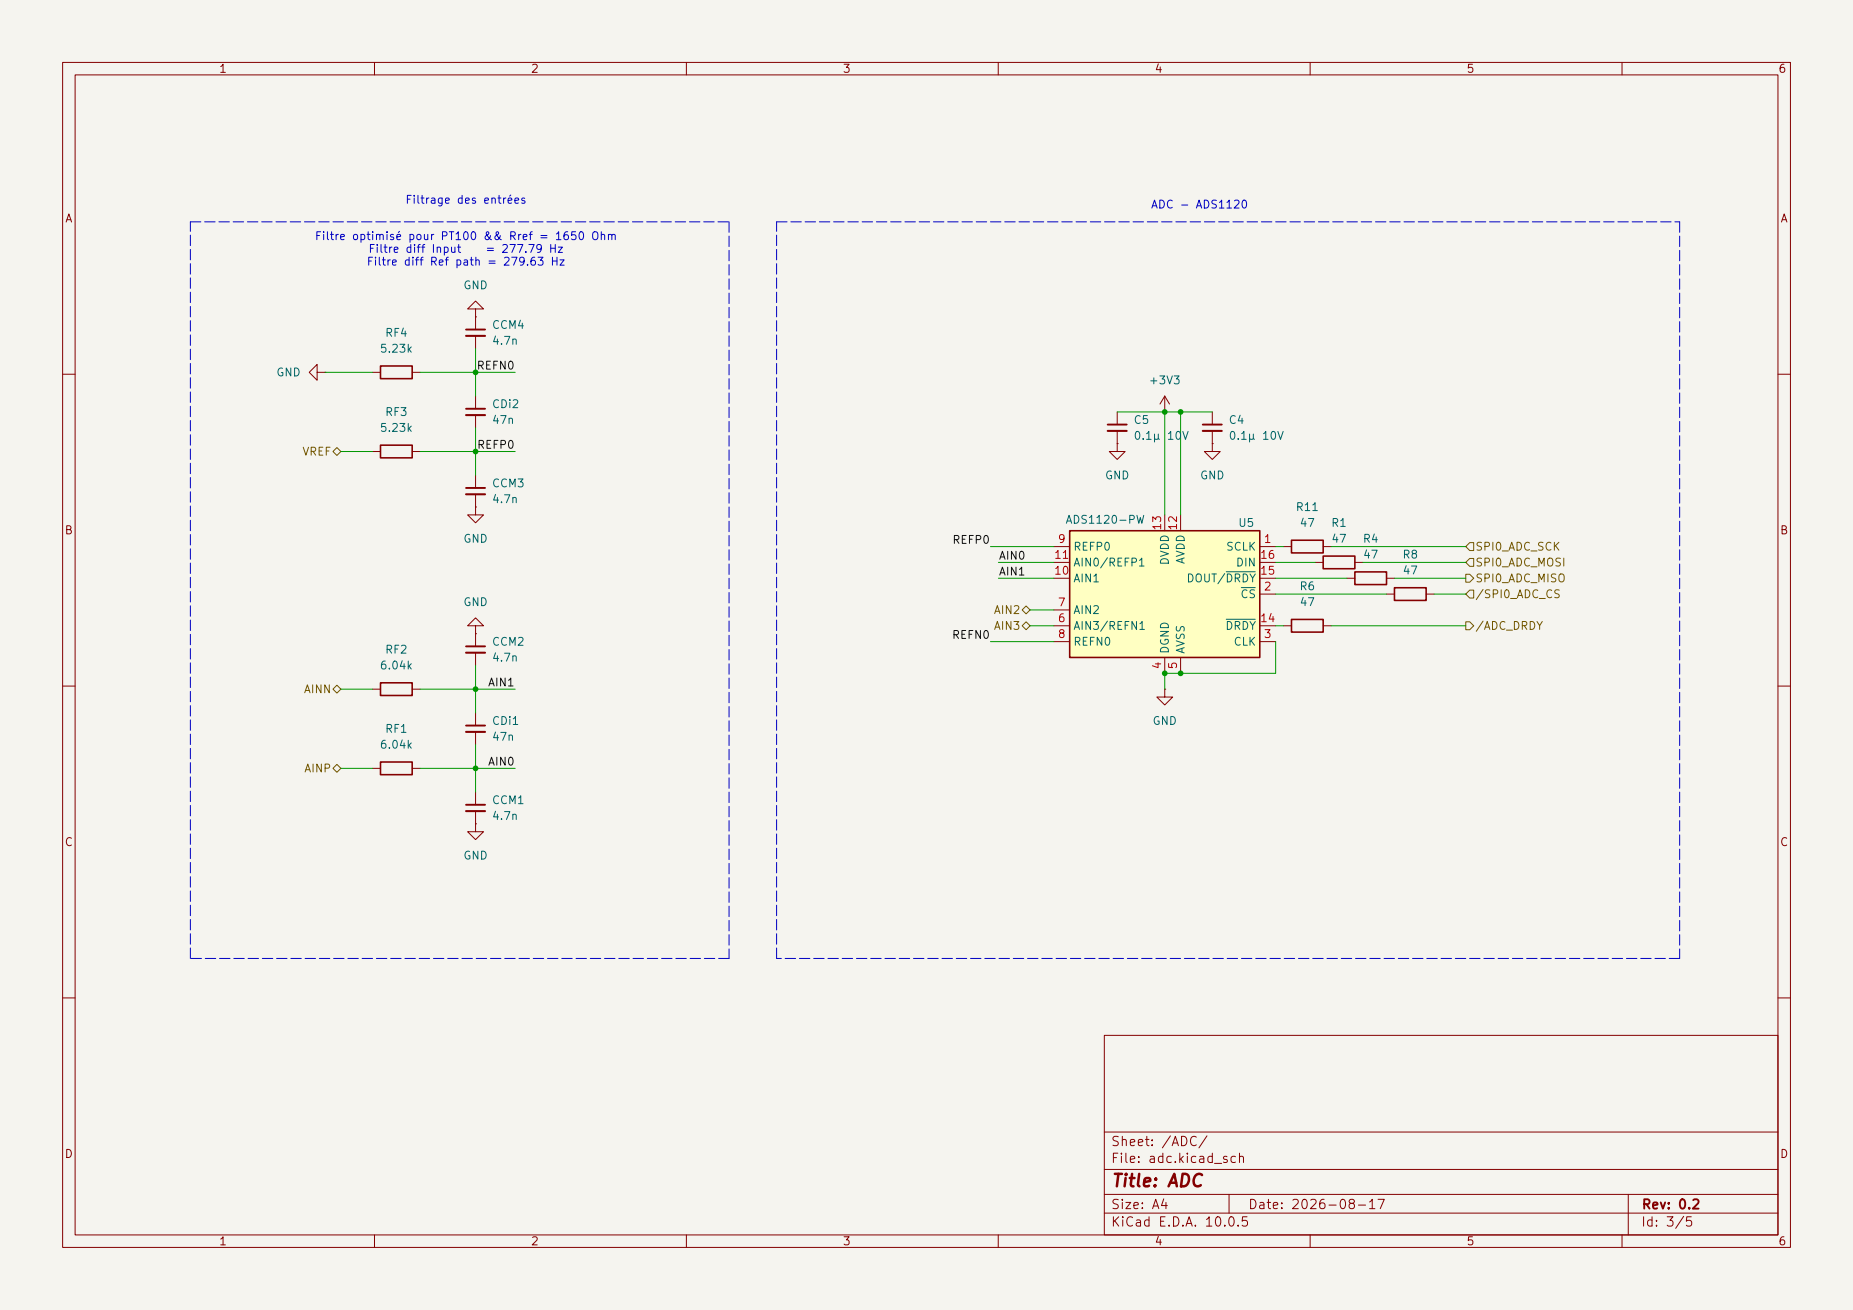
[picture p21: page 3]

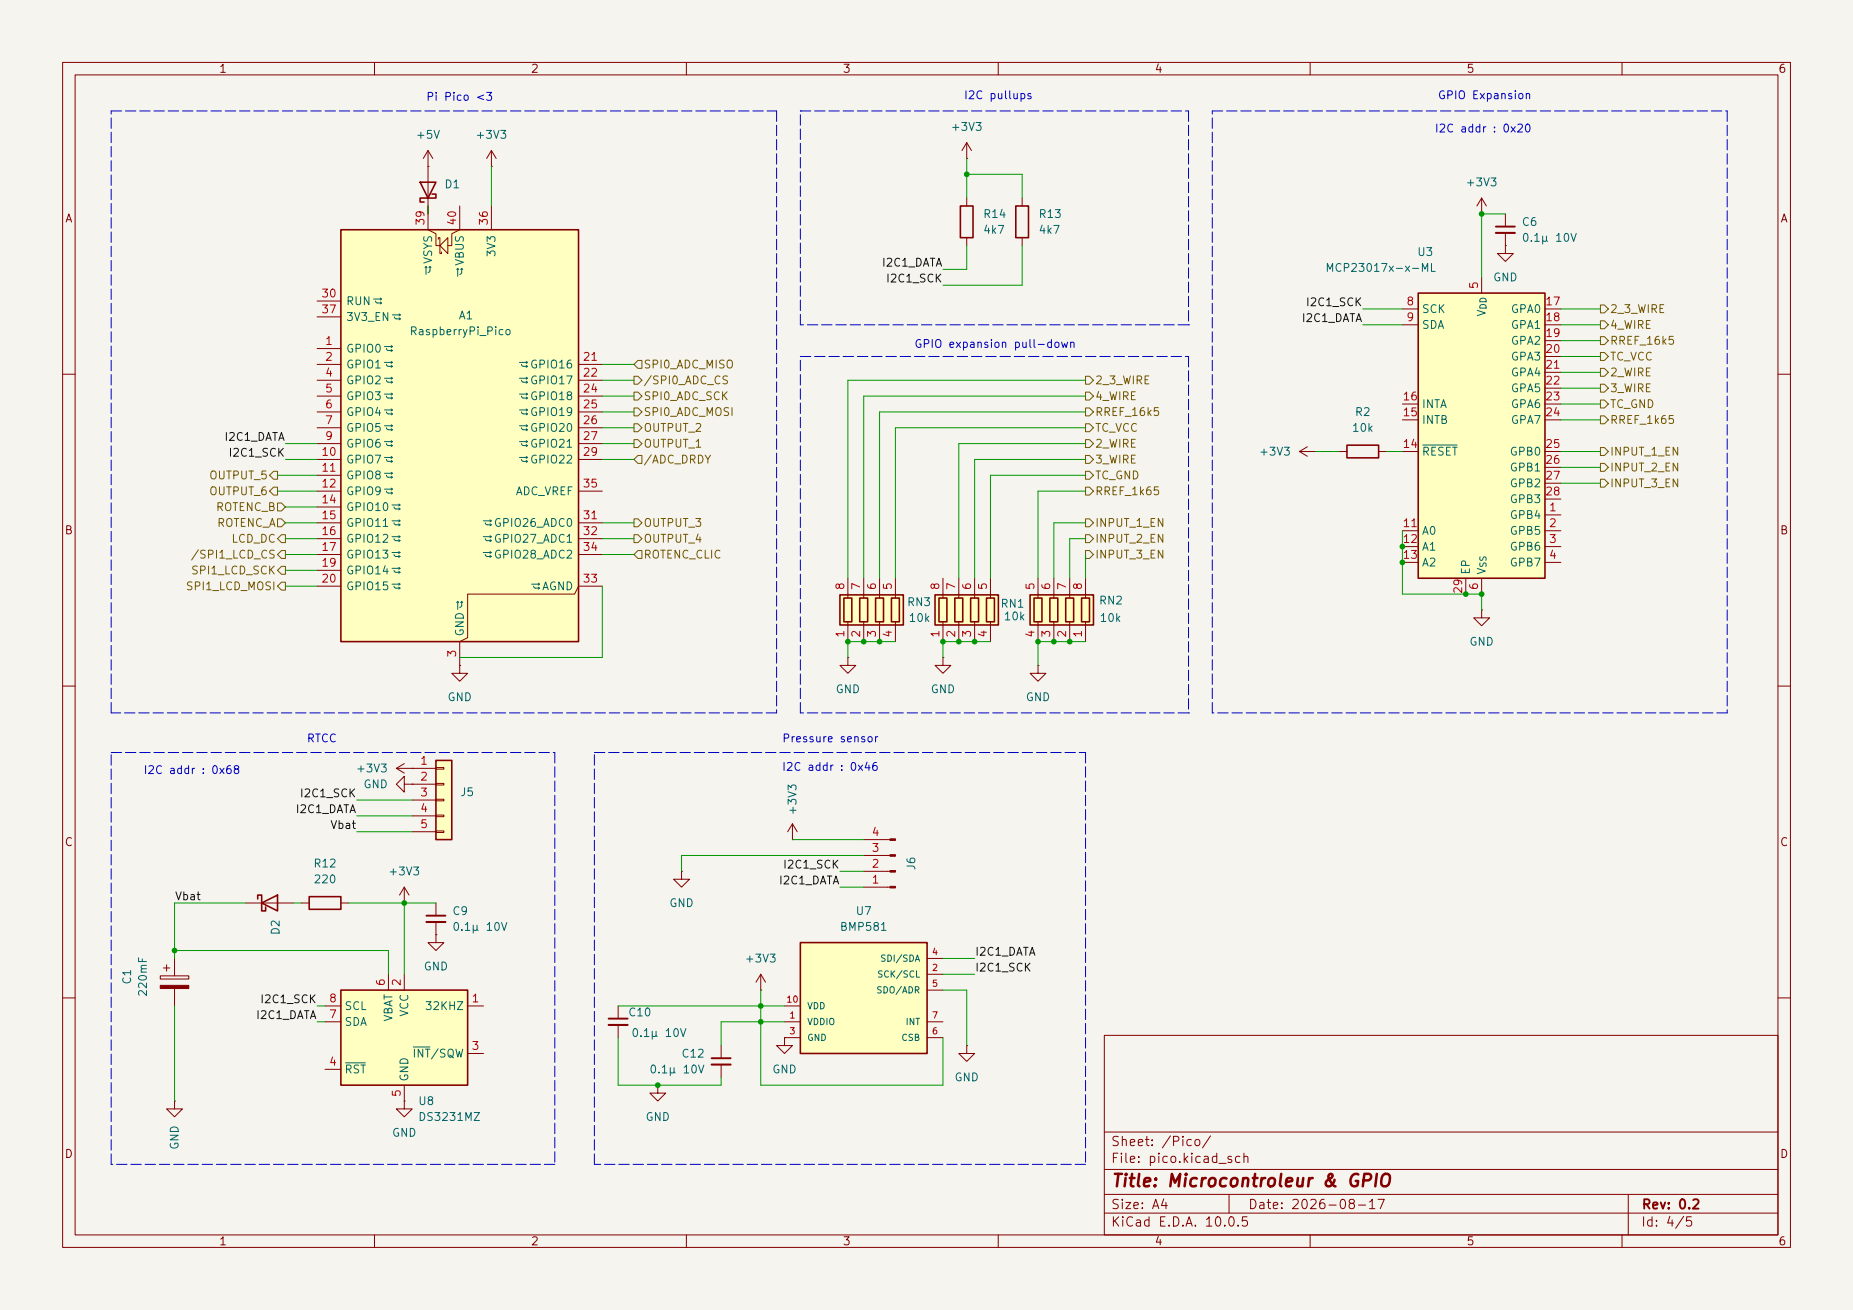
[picture p22: page 4]

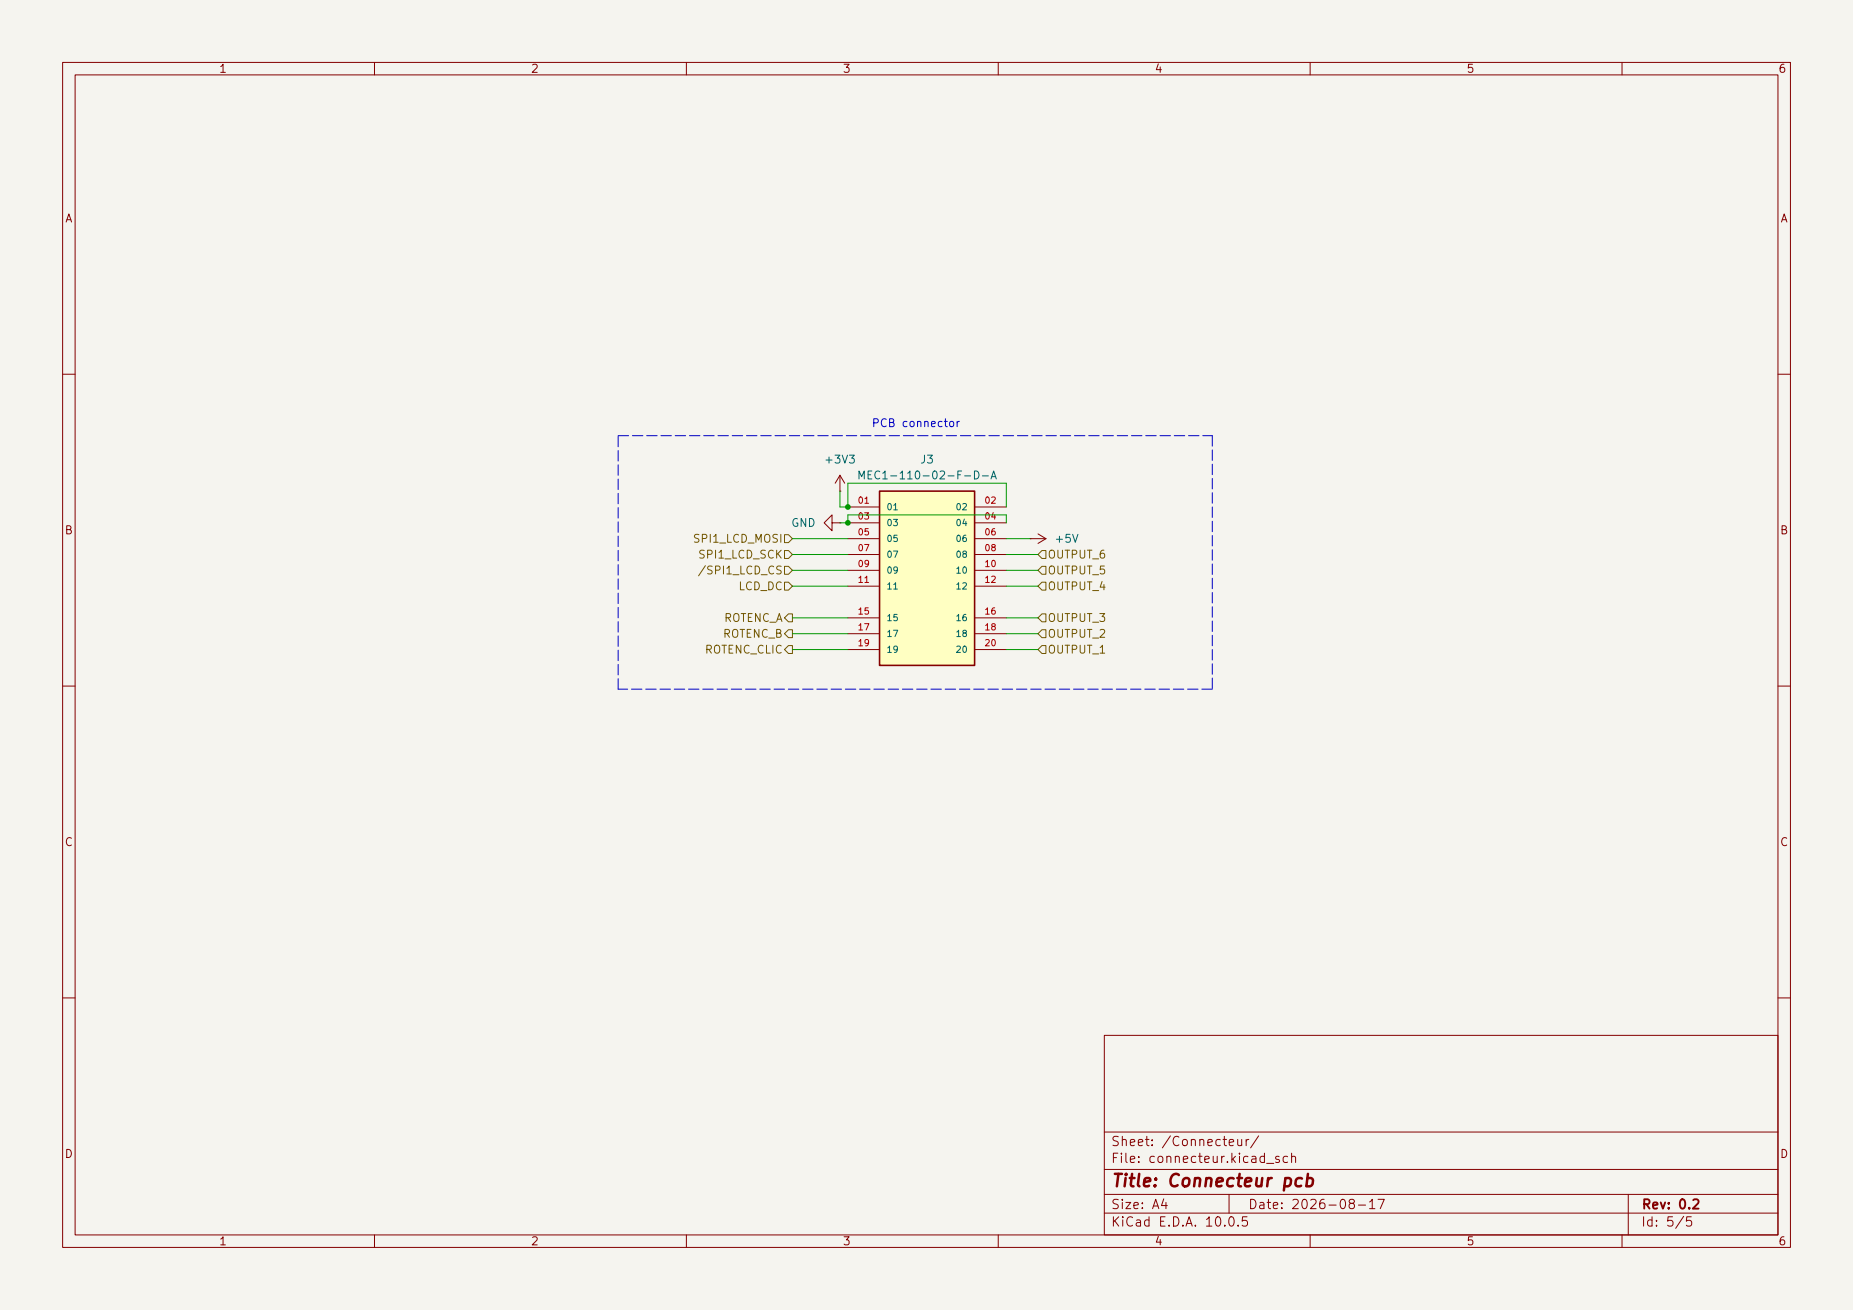
[picture p23: page 5]
