npfs666/OPC_PCB/Pdf/Carte puissance.pdf

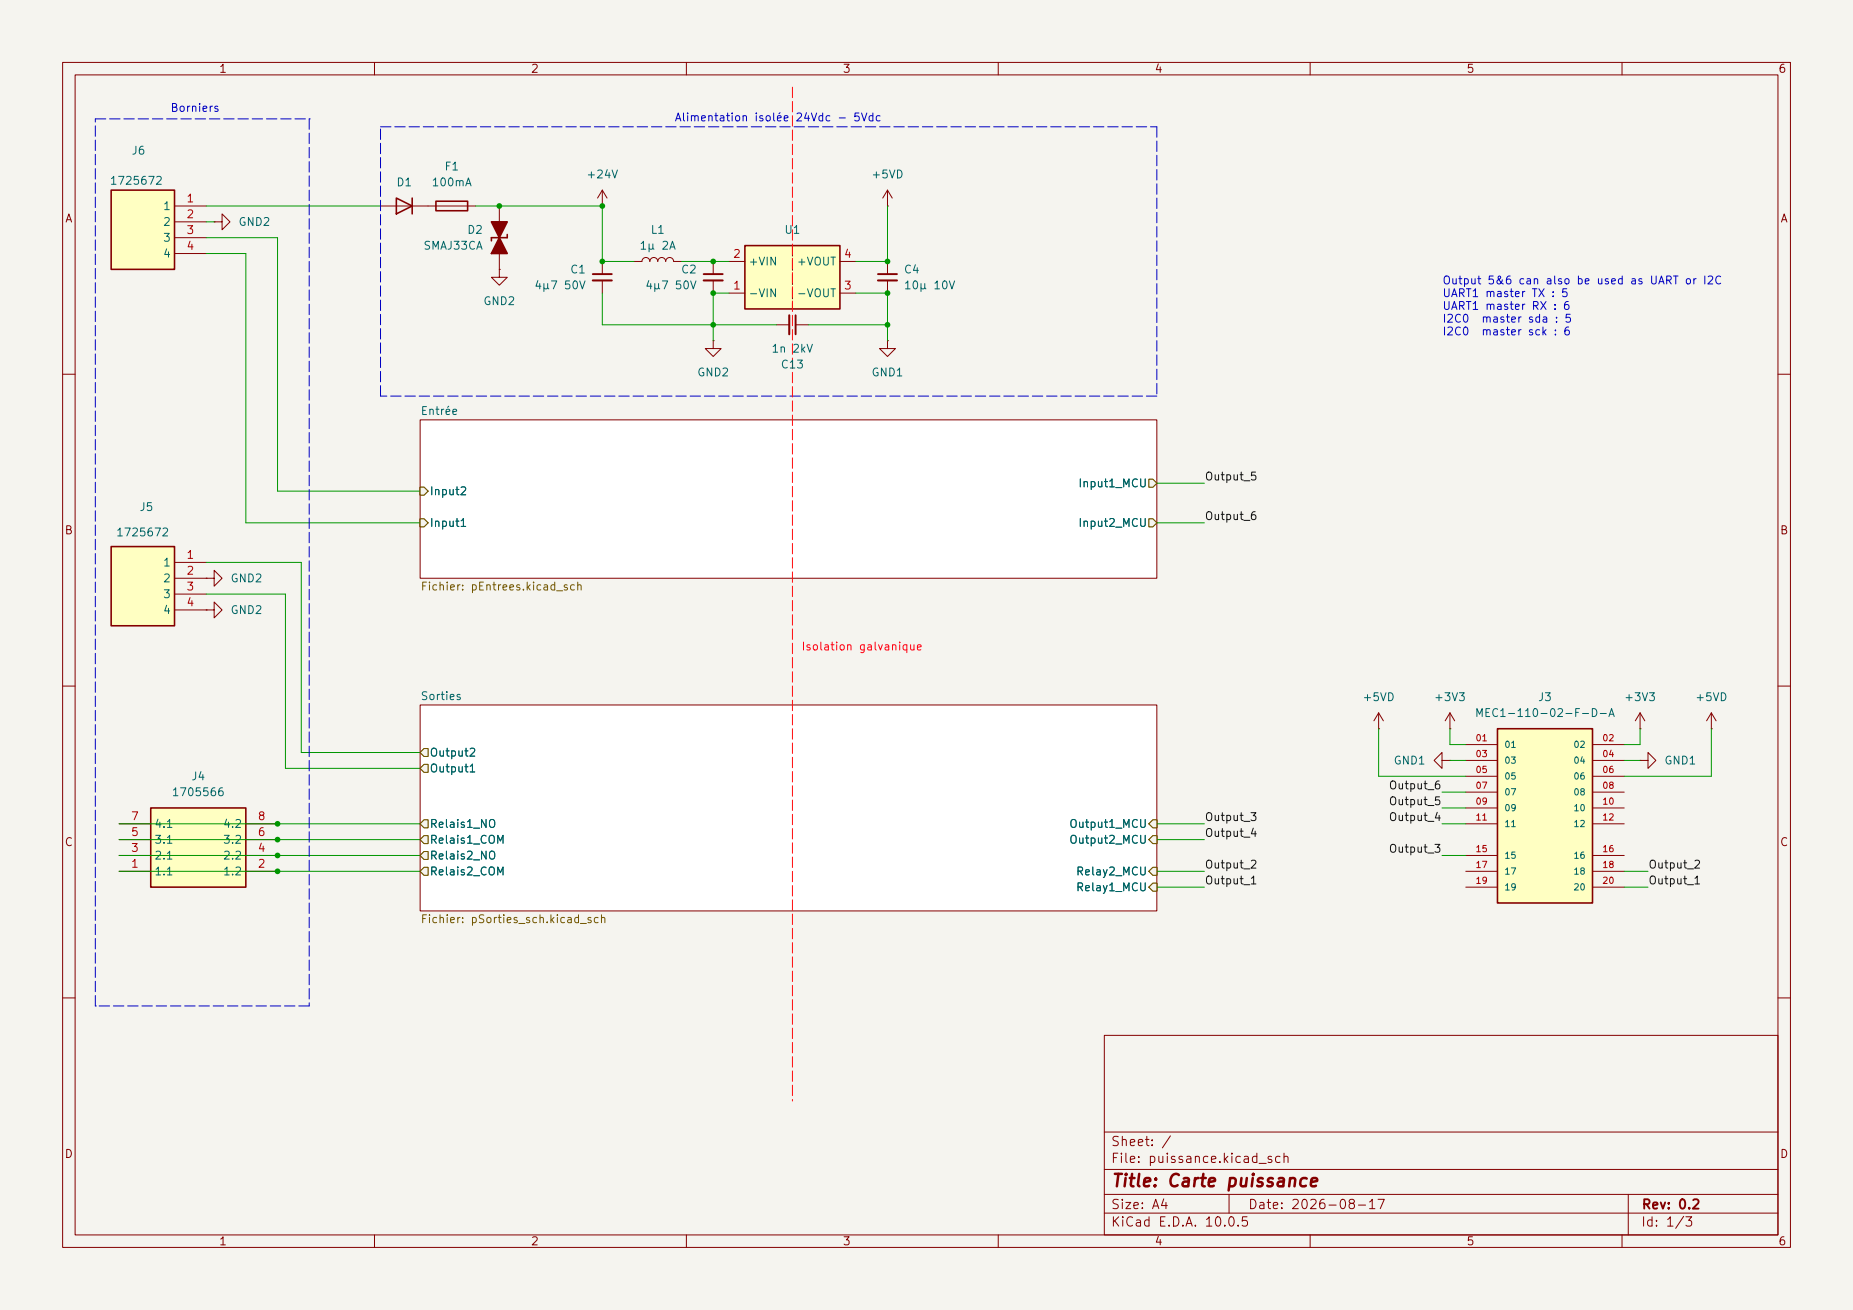
[picture p24: page 1]

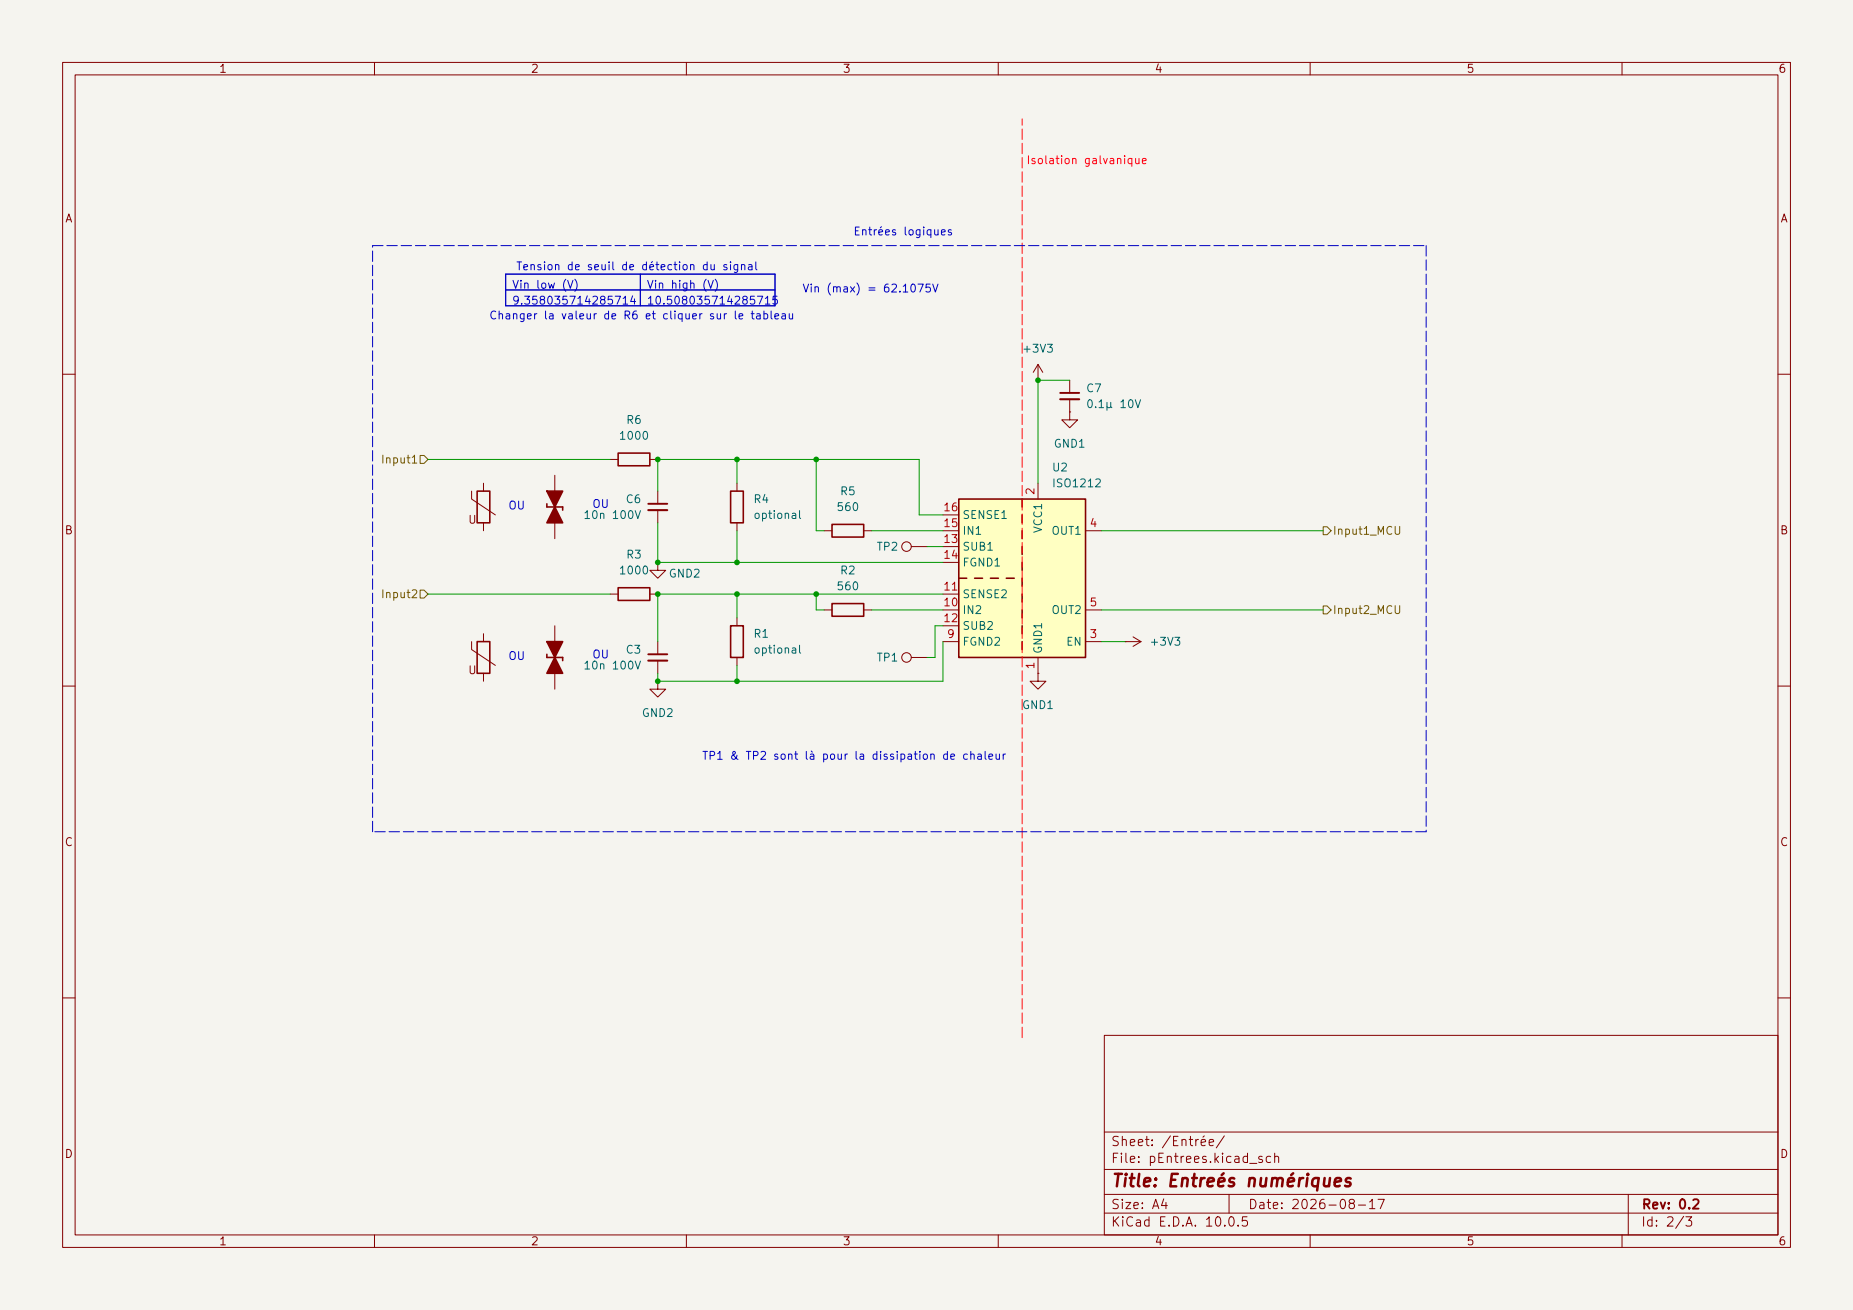
[picture p25: page 2]

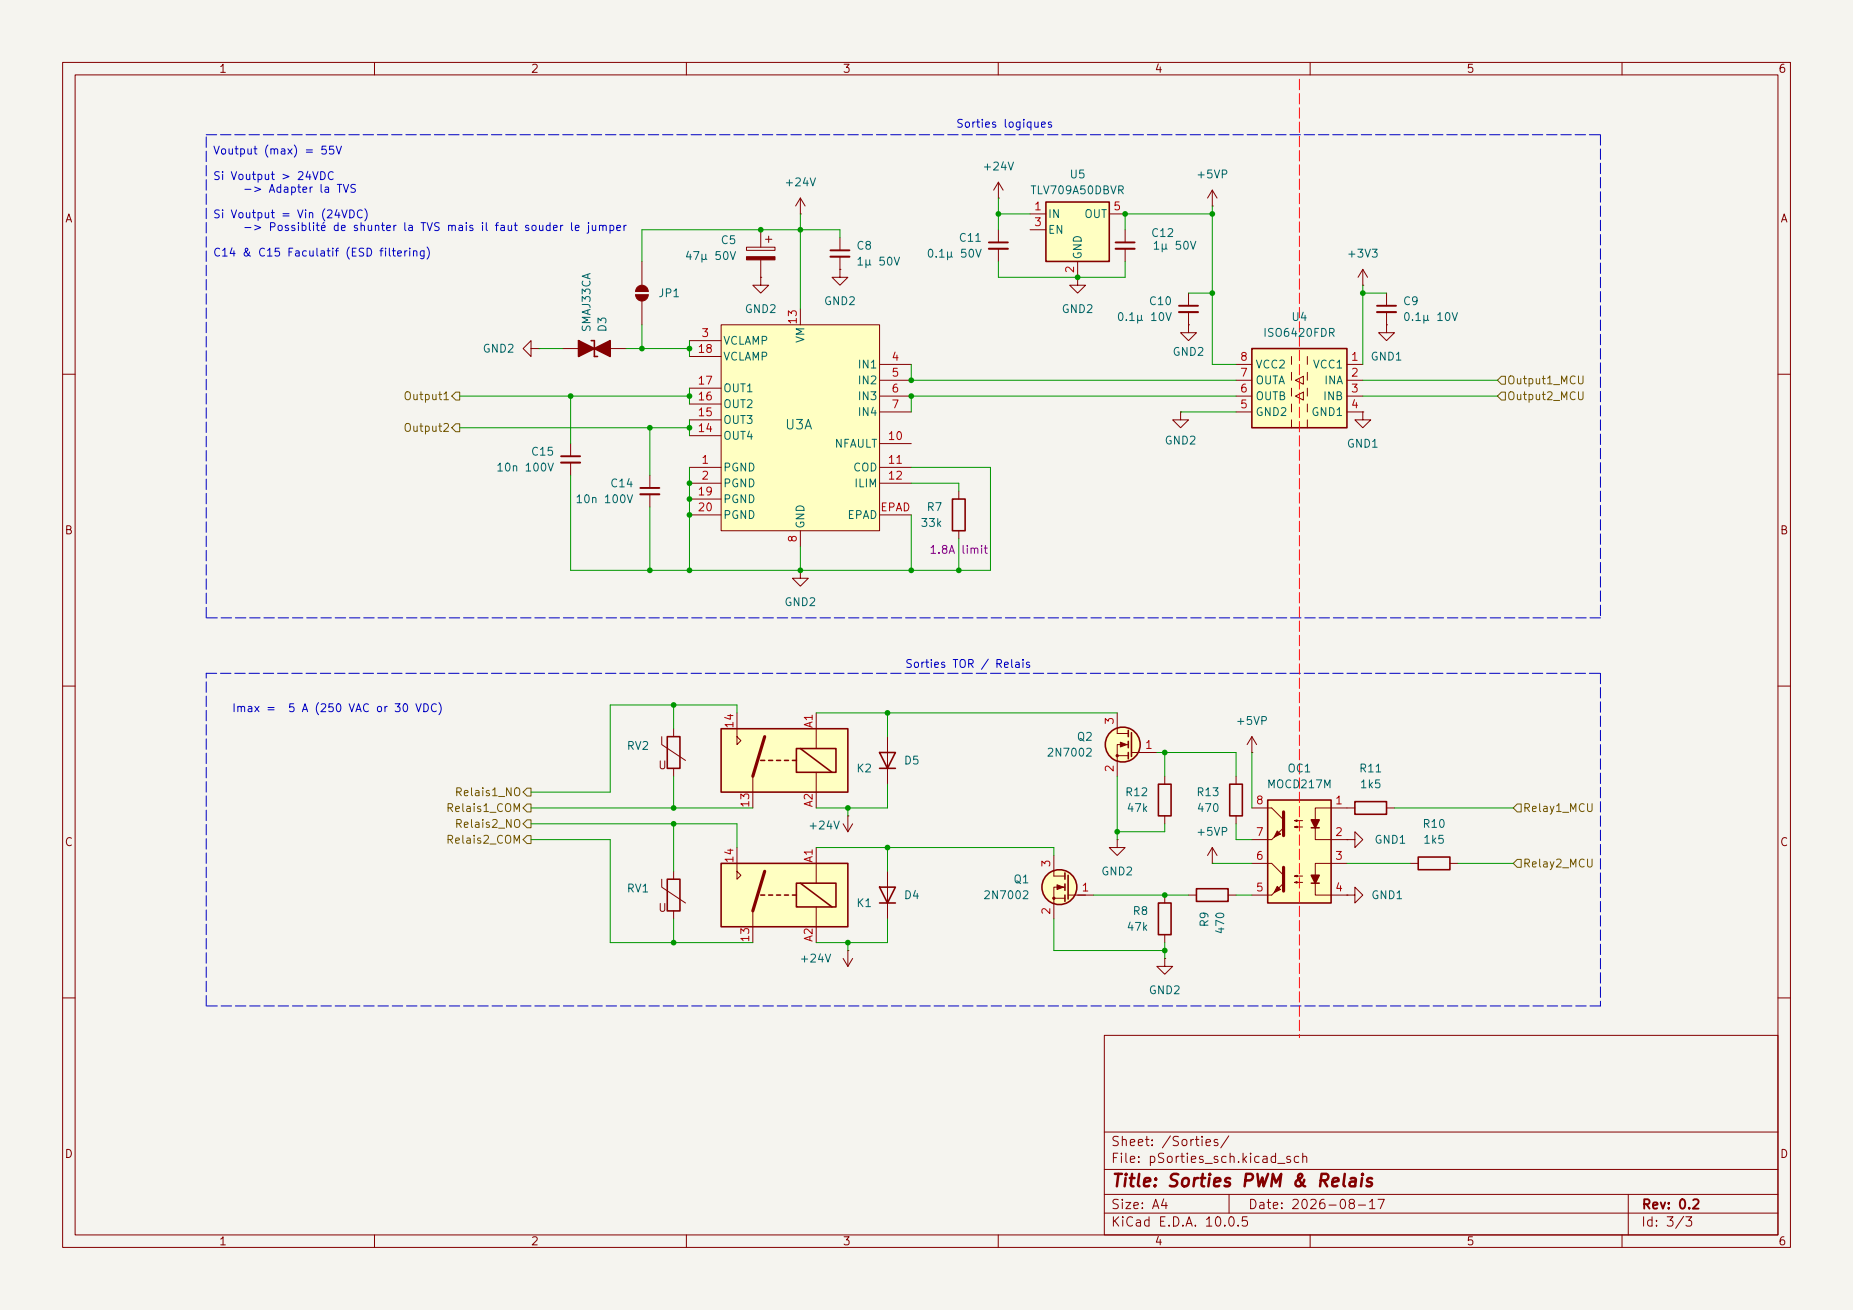
[picture p26: page 3]
