npfs666/OPC_PCB/Pdf/Ecran.pdf

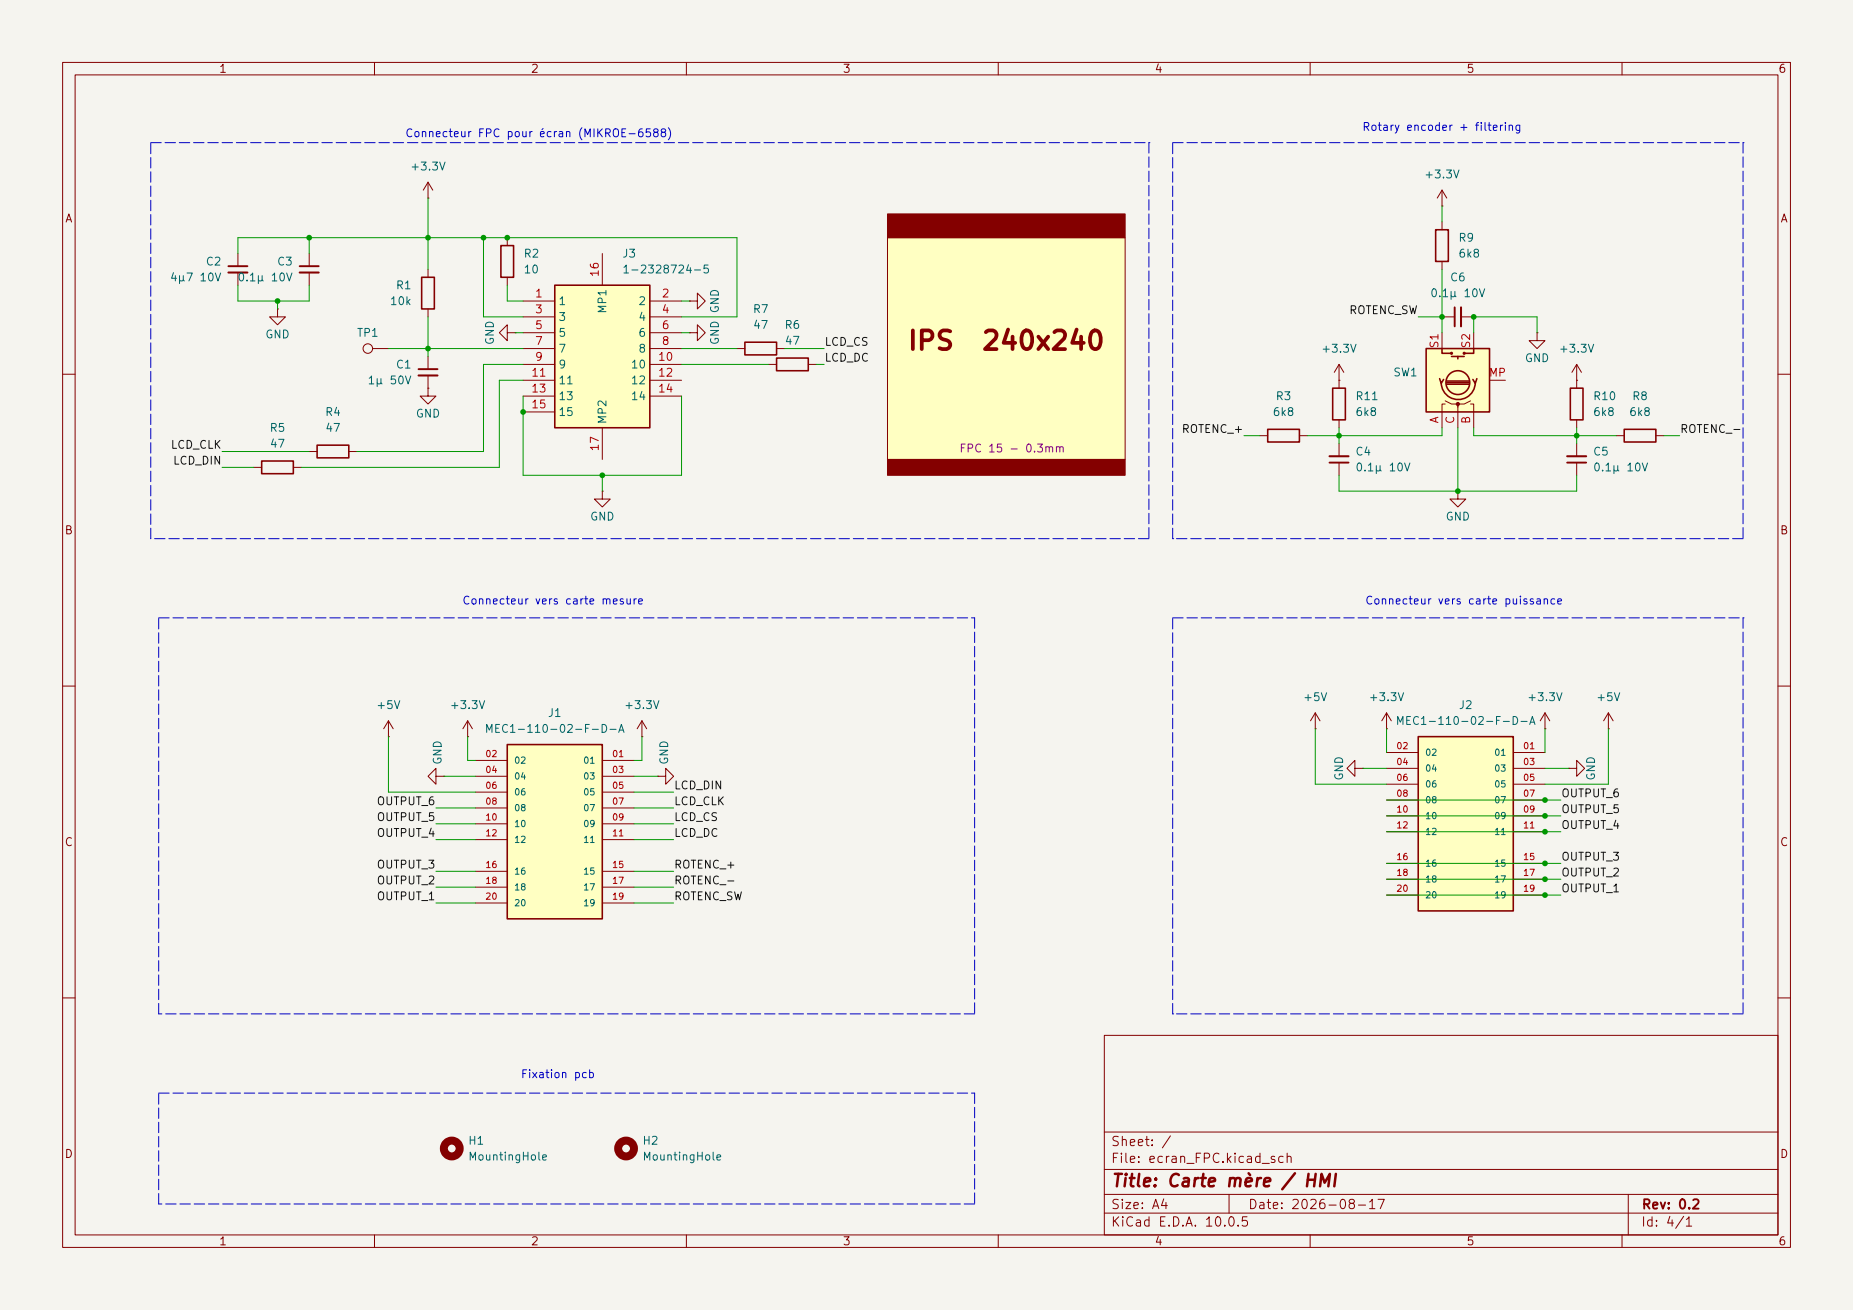
[picture p27: page 1]
