npfs666/OPC_PCB/OPC V3.kicad_pcb

## KiCad design OPC V3.kicad_pcb (2026-10-04)

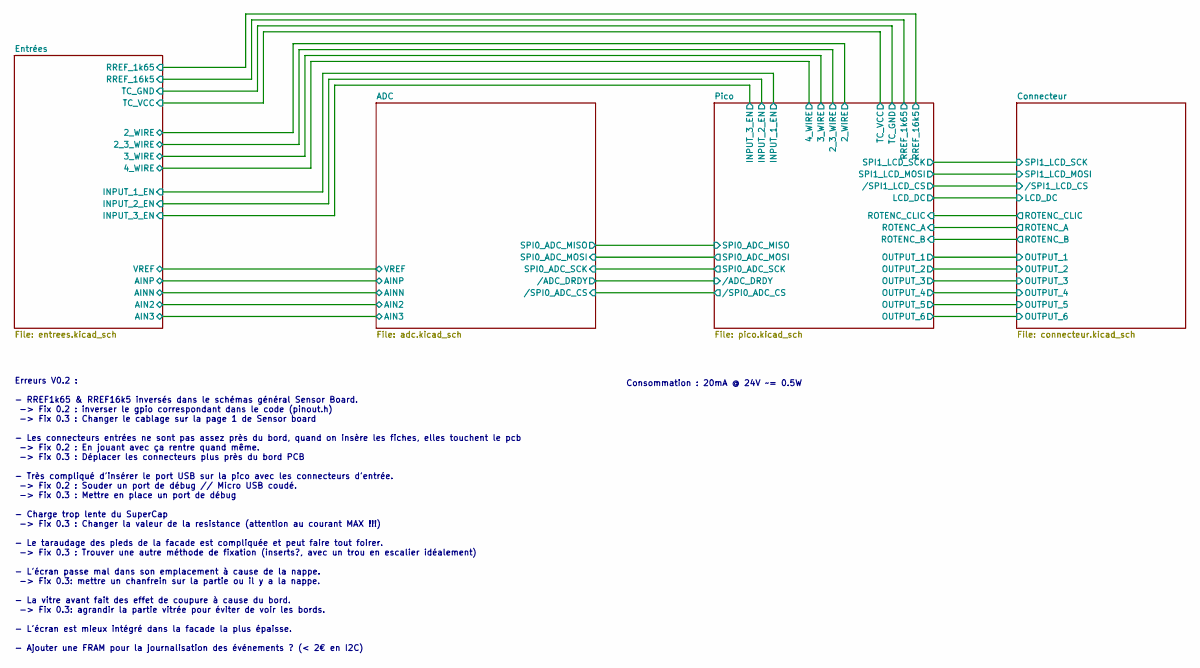
[picture p28: schematic OPC V3.kicad_sch, Carte capteur + microcontroleur]

Notes on the sheet:
Erreurs V0.2 : - RREF1k65 & RREF16k5 inversés dans le schémas général Sensor Board. -> Fix 0.2 : inverser le gpio correspondant dans le code (pinout.h) -> Fix 0.3 : Changer le cablage sur la page 1 de Sensor board - Les connecteurs entrées ne sont pas assez près du bord, quand on insère les fiches,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
Consommation : 20mA @ 24V ~= 0.5W

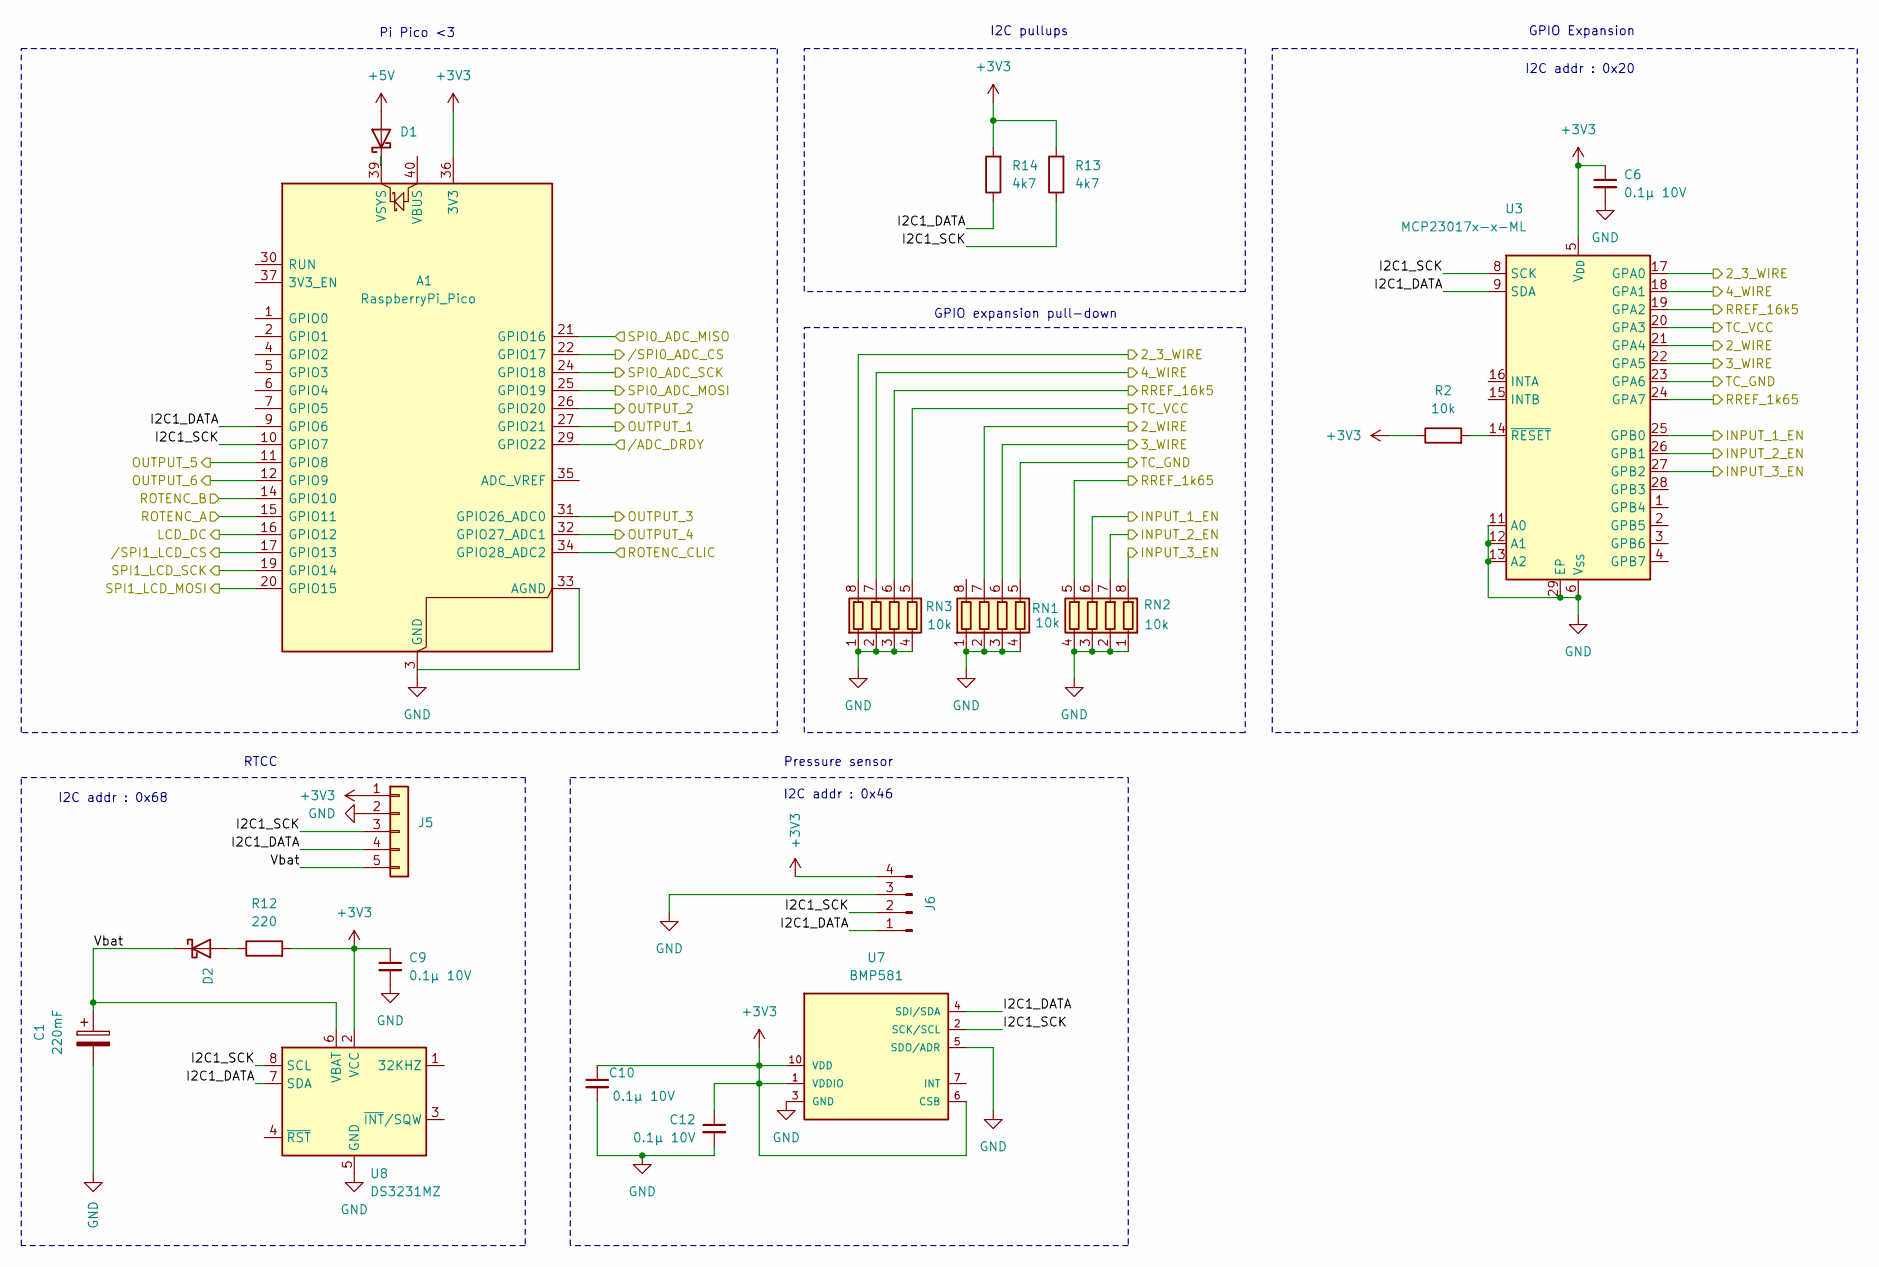
[picture p29: schematic pico.kicad_sch, Microcontroleur & GPIO]

Parts:
A1: RaspberryPi_Pico; RaspberryPi_Pico_Common_THT_SIMPLE; MPN SC1631
C1: 220mF; CP_Radial_D13.0mm_P5.00mm; MPN 3-158-695
C6, C9, C12: 0.1µ 10V; C_0603_1608Metric_Pad1.08x0.95mm_HandSolder; MPN 885012206020; LCSC Part # C14663
C10: 0.1µ 10V; C_0603_1608Metric; MPN 885012206020; LCSC Part # C14663
D1, D2: D_Schottky; D_SMA; MPN B140-E3/61T; LCSC Part # C14996
J5: Conn_01x05; PinHeader_1x05_P2.54mm_Vertical
J6: Conn_01x04_Pin; PinHeader_1x04_P2.54mm_Vertical
R2: 10k; R_0603_1608Metric_Pad0.98x0.95mm_HandSolder; MPN ERJ-3EKF1002V; LCSC Part # C25804
R12: 220; R_0603_1608Metric_Pad0.98x0.95mm_HandSolder; MPN ERJ-3GEYJ221V; LCSC Part # C22962
R13, R14: 4k7; R_0603_1608Metric_Pad0.98x0.95mm_HandSolder; MPN ERJ-3GEYJ472V; LCSC Part # C23162
RN1, RN2, RN3: 10k; R_Array_Concave_4x0603; MPN WA06X103JTL; LCSC Part # C29718
U3: MCP23017x-x-ML; QFN-28-1EP_6x6mm_P0.65mm_EP4.25x4.25mm; MPN MCP23017-E/ML; LCSC Part # C629439
U7: BMP581; MPN BMP581
U8: DS3231MZ; SOIC-8_3.9x4.9mm_P1.27mm; MPN DS3231MZ+TRL; LCSC Part # C107410

Connections:
+3V3: A1.36 (3V3), C6.1, C9.1, C10.1, C12.1, J5.1, J6.4, R2.1, R12.2, R13.2, R14.2, U3.5 (V_{DD}), U7.1 (VDDIO), U7.6 (CSB), U7.10 (VDD), U8.2 (VCC); also elsewhere on the board
+5V: D1.2 (A); also elsewhere on the board
/ADC/SPI0_ADC_MISO: A1.21 (GPIO16); also elsewhere on the board
/ADC/SPI0_ADC_MOSI: A1.25 (GPIO19); also elsewhere on the board
/ADC/SPI0_ADC_SCK: A1.24 (GPIO18); also elsewhere on the board
/ADC//ADC_DRDY: A1.29 (GPIO22); also elsewhere on the board
/ADC//SPI0_ADC_CS: A1.22 (GPIO17); also elsewhere on the board
/Connecteur/LCD_DC: A1.16 (GPIO12); also elsewhere on the board
/Connecteur/OUTPUT_1: A1.27 (GPIO21); also elsewhere on the board
/Connecteur/OUTPUT_2: A1.26 (GPIO20); also elsewhere on the board
/Connecteur/OUTPUT_3: A1.31 (GPIO26_ADC0); also elsewhere on the board
/Connecteur/OUTPUT_4: A1.32 (GPIO27_ADC1); also elsewhere on the board
/Connecteur/OUTPUT_5: A1.11 (GPIO8); also elsewhere on the board
/Connecteur/OUTPUT_6: A1.12 (GPIO9); also elsewhere on the board
/Connecteur/ROTENC_A: A1.15 (GPIO11); also elsewhere on the board
/Connecteur/ROTENC_B: A1.14 (GPIO10); also elsewhere on the board
/Connecteur/ROTENC_CLIC: A1.34 (GPIO28_ADC2); also elsewhere on the board
/Connecteur/SPI1_LCD_MOSI: A1.20 (GPIO15); also elsewhere on the board
/Connecteur/SPI1_LCD_SCK: A1.19 (GPIO14); also elsewhere on the board
/Connecteur//SPI1_LCD_CS: A1.17 (GPIO13); also elsewhere on the board
/Entrées/2_3_WIRE: RN3.8 (R1.2), U3.17 (GPA0); also elsewhere on the board
/Entrées/2_WIRE: RN1.7 (R2.2), U3.21 (GPA4); also elsewhere on the board
/Entrées/3_WIRE: RN1.6 (R3.2), U3.22 (GPA5); also elsewhere on the board
/Entrées/4_WIRE: RN3.7 (R2.2), U3.18 (GPA1); also elsewhere on the board
/Entrées/INPUT_1_EN: RN2.6 (R3.2), U3.25 (GPB0); also elsewhere on the board
/Entrées/INPUT_2_EN: RN2.7 (R2.2), U3.26 (GPB1); also elsewhere on the board
/Entrées/INPUT_3_EN: RN2.8 (R1.2), U3.27 (GPB2); also elsewhere on the board
/Entrées/RREF_1k65: RN3.6 (R3.2), U3.19 (GPA2); also elsewhere on the board
/Entrées/RREF_16k5: RN2.5 (R4.2), U3.24 (GPA7); also elsewhere on the board
/Entrées/TC_GND: RN1.5 (R4.2), U3.23 (GPA6); also elsewhere on the board
/Entrées/TC_VCC: RN3.5 (R4.2), U3.20 (GPA3); also elsewhere on the board
/Pico/I2C1_DATA: A1.9 (GPIO6), J5.4, J6.1, R14.1, U3.9 (SDA), U7.4 (SDI/SDA), U8.7 (SDA)
/Pico/I2C1_SCK: A1.10 (GPIO7), J5.3, J6.2, R13.1, U3.8 (SCK), U7.2 (SCK/SCL), U8.8 (SCL)
/Pico/Vbat: C1.1, D2.1 (K), J5.5, U8.6 (VBAT)
GND: A1.3 (GND), A1.8 (GND), A1.13 (GND), A1.18 (GND), A1.23 (GND), A1.28 (GND), A1.38 (GND), C1.2, C6.2, C9.2, C10.2, C12.2, J5.2, J6.3, RN1.1 (R1.1), RN1.2 (R2.1), RN1.3 (R3.1), RN1.4 (R4.1), RN2.1 (R1.1), RN2.2 (R2.1), RN2.3 (R3.1), RN2.4 (R4.1), RN3.1 (R1.1), RN3.2 (R2.1), RN3.3 (R3.1), RN3.4 (R4.1), U3.6 (V_{SS}), U3.11 (A0), U3.12 (A1), U3.13 (A2), U3.29 (EP), U7.3 (GND), U7.5 (SDO/ADR), U7.8 (GND), U7.9 (GND), U8.5 (GND); also elsewhere on the board
unnamed: A1.39 (VSYS), D1.1 (K)
unnamed: D2.2 (A), R12.1
unnamed: R2.2, U3.14 (~RESET)

Notes on the sheet:
I2C pullups
Pressure sensor
I2C addr : 0x46
I2C addr : 0x68
I2C addr : 0x20
GPIO Expansion
GPIO expansion pull-down
Pi Pico <3
RTCC

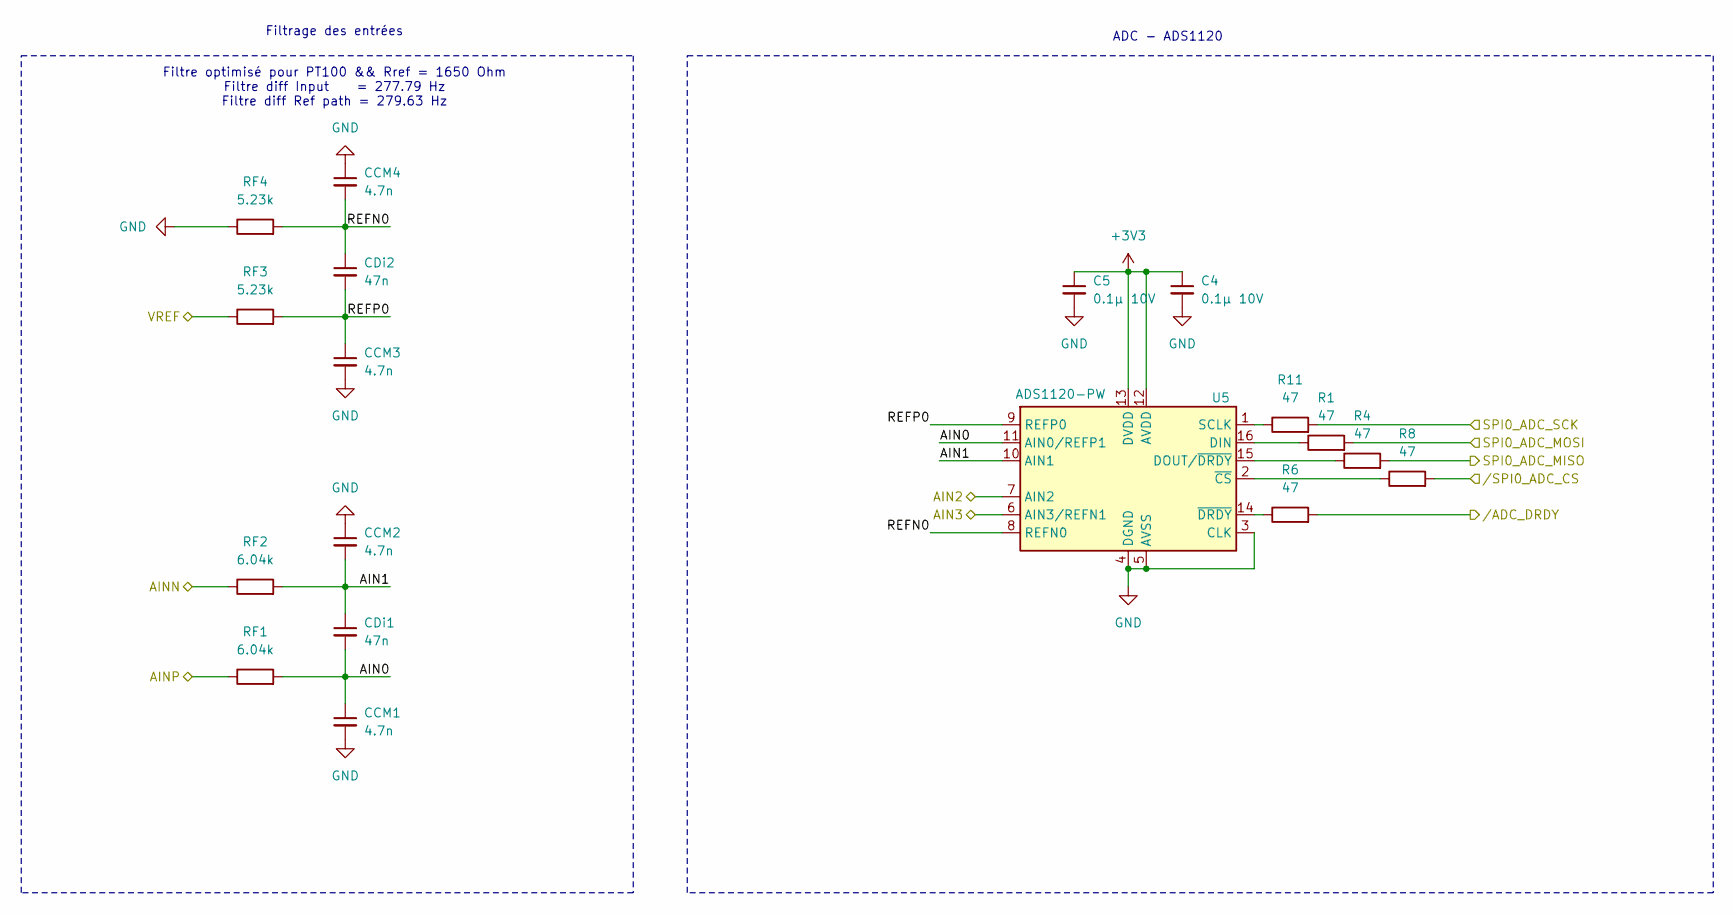
[picture p30: schematic adc.kicad_sch]

Parts:
C4, C5: 0.1µ 10V; C_0603_1608Metric_Pad1.08x0.95mm_HandSolder; MPN 885012206020; LCSC Part # C14663
CCM1, CCM2, CCM3, CCM4: 4.7n; C_0805_2012Metric_Pad1.18x1.45mm_HandSolder; MPN GCM1885C1H472JA16J; LCSC Part # C77063
CDi1, CDi2: 47n; C_1206_3216Metric_Pad1.33x1.80mm_HandSolder; MPN GRM3195C1H473JA05D; LCSC Part # C21812
R1, R4, R6, R8, R11: 47; R_0603_1608Metric_Pad0.98x0.95mm_HandSolder; MPN ERJ-3GEYJ470V; LCSC Part # C23182
RF1, RF2: 6.04k; R_0603_1608Metric_Pad0.98x0.95mm_HandSolder; MPN ERA-3AED6041V; LCSC Part # C403295
RF3, RF4: 5.23k; R_0603_1608Metric_Pad0.98x0.95mm_HandSolder; MPN ERA-3AEB5231V; LCSC Part # C4165570
U5: ADS1120-PW; TSSOP-16_4.4x5mm_P0.65mm; MPN ADS1120IPWR; LCSC Part # C84284

Connections:
+3V3: C4.1, C5.1, U5.12 (AVDD), U5.13 (DVDD); also elsewhere on the board
/ADC/AIN0: CCM1.1, CDi1.2, RF1.2, U5.11 (AIN0/REFP1)
/ADC/AIN1: CCM2.2, CDi1.1, RF2.2, U5.10 (AIN1)
/ADC/AIN2: U5.7 (AIN2); also elsewhere on the board
/ADC/AIN3: U5.6 (AIN3/REFN1); also elsewhere on the board
/ADC/AINN: RF2.1; also elsewhere on the board
/ADC/AINP: RF1.1; also elsewhere on the board
/ADC/REFN0: CCM4.2, CDi2.1, RF4.2, U5.8 (REFN0)
/ADC/REFP0: CCM3.1, CDi2.2, RF3.2, U5.9 (REFP0)
/ADC/SPI0_ADC_MISO: R4.2; also elsewhere on the board
/ADC/SPI0_ADC_MOSI: R1.2; also elsewhere on the board
/ADC/SPI0_ADC_SCK: R11.2; also elsewhere on the board
/ADC/VREF: RF3.1; also elsewhere on the board
/ADC//ADC_DRDY: R6.2; also elsewhere on the board
/ADC//SPI0_ADC_CS: R8.2; also elsewhere on the board
GND: C4.2, C5.2, CCM1.2, CCM2.1, CCM3.2, CCM4.1, RF4.1, U5.3 (CLK), U5.4 (DGND), U5.5 (AVSS); also elsewhere on the board
unnamed: R1.1, U5.16 (DIN)
unnamed: R4.1, U5.15 (DOUT/~DRDY)
unnamed: R11.1, U5.1 (SCLK)
unnamed: R8.1, U5.2 (~CS)
unnamed: R6.1, U5.14 (~DRDY)

Notes on the sheet:
Filtrage des entrées
Filtre optimisé pour PT100 && Rref = 1650 Ohm Filtre diff Input = 277.79 Hz Filtre diff Ref path = 279.63 Hz
ADC - ADS1120

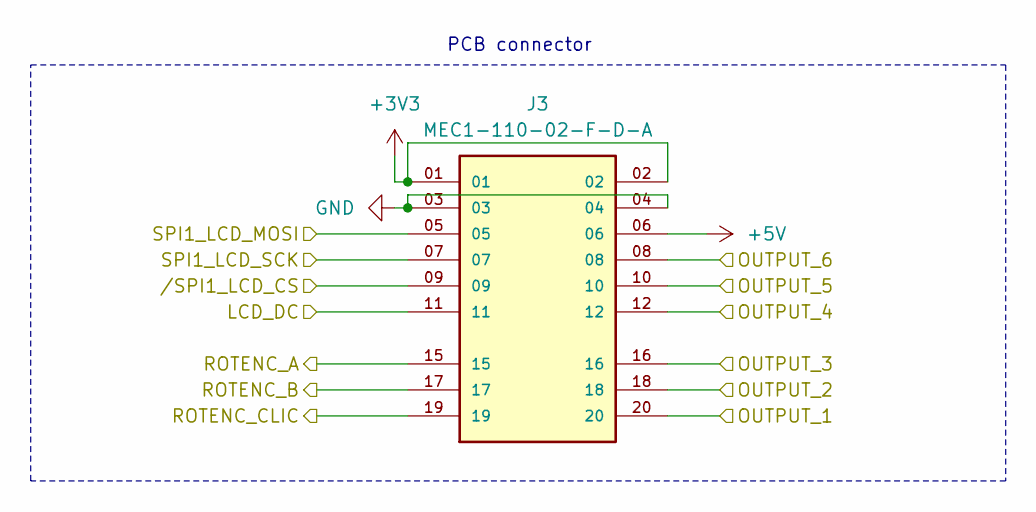
[picture p31: schematic connecteur.kicad_sch, Connecteur pcb]

Parts:
J3: MEC1-110-02-F-D-A; MEC1-110-02-F-D-A-MALE

Connections:
+3V3: J3.01, J3.02; also elsewhere on the board
+5V: J3.06; also elsewhere on the board
/Connecteur/LCD_DC: J3.11; also elsewhere on the board
/Connecteur/OUTPUT_1: J3.20; also elsewhere on the board
/Connecteur/OUTPUT_2: J3.18; also elsewhere on the board
/Connecteur/OUTPUT_3: J3.16; also elsewhere on the board
/Connecteur/OUTPUT_4: J3.12; also elsewhere on the board
/Connecteur/OUTPUT_5: J3.10; also elsewhere on the board
/Connecteur/OUTPUT_6: J3.08; also elsewhere on the board
/Connecteur/ROTENC_A: J3.15; also elsewhere on the board
/Connecteur/ROTENC_B: J3.17; also elsewhere on the board
/Connecteur/ROTENC_CLIC: J3.19; also elsewhere on the board
/Connecteur/SPI1_LCD_MOSI: J3.05; also elsewhere on the board
/Connecteur/SPI1_LCD_SCK: J3.07; also elsewhere on the board
/Connecteur//SPI1_LCD_CS: J3.09; also elsewhere on the board
GND: J3.03, J3.04; also elsewhere on the board

Notes on the sheet:
PCB connector

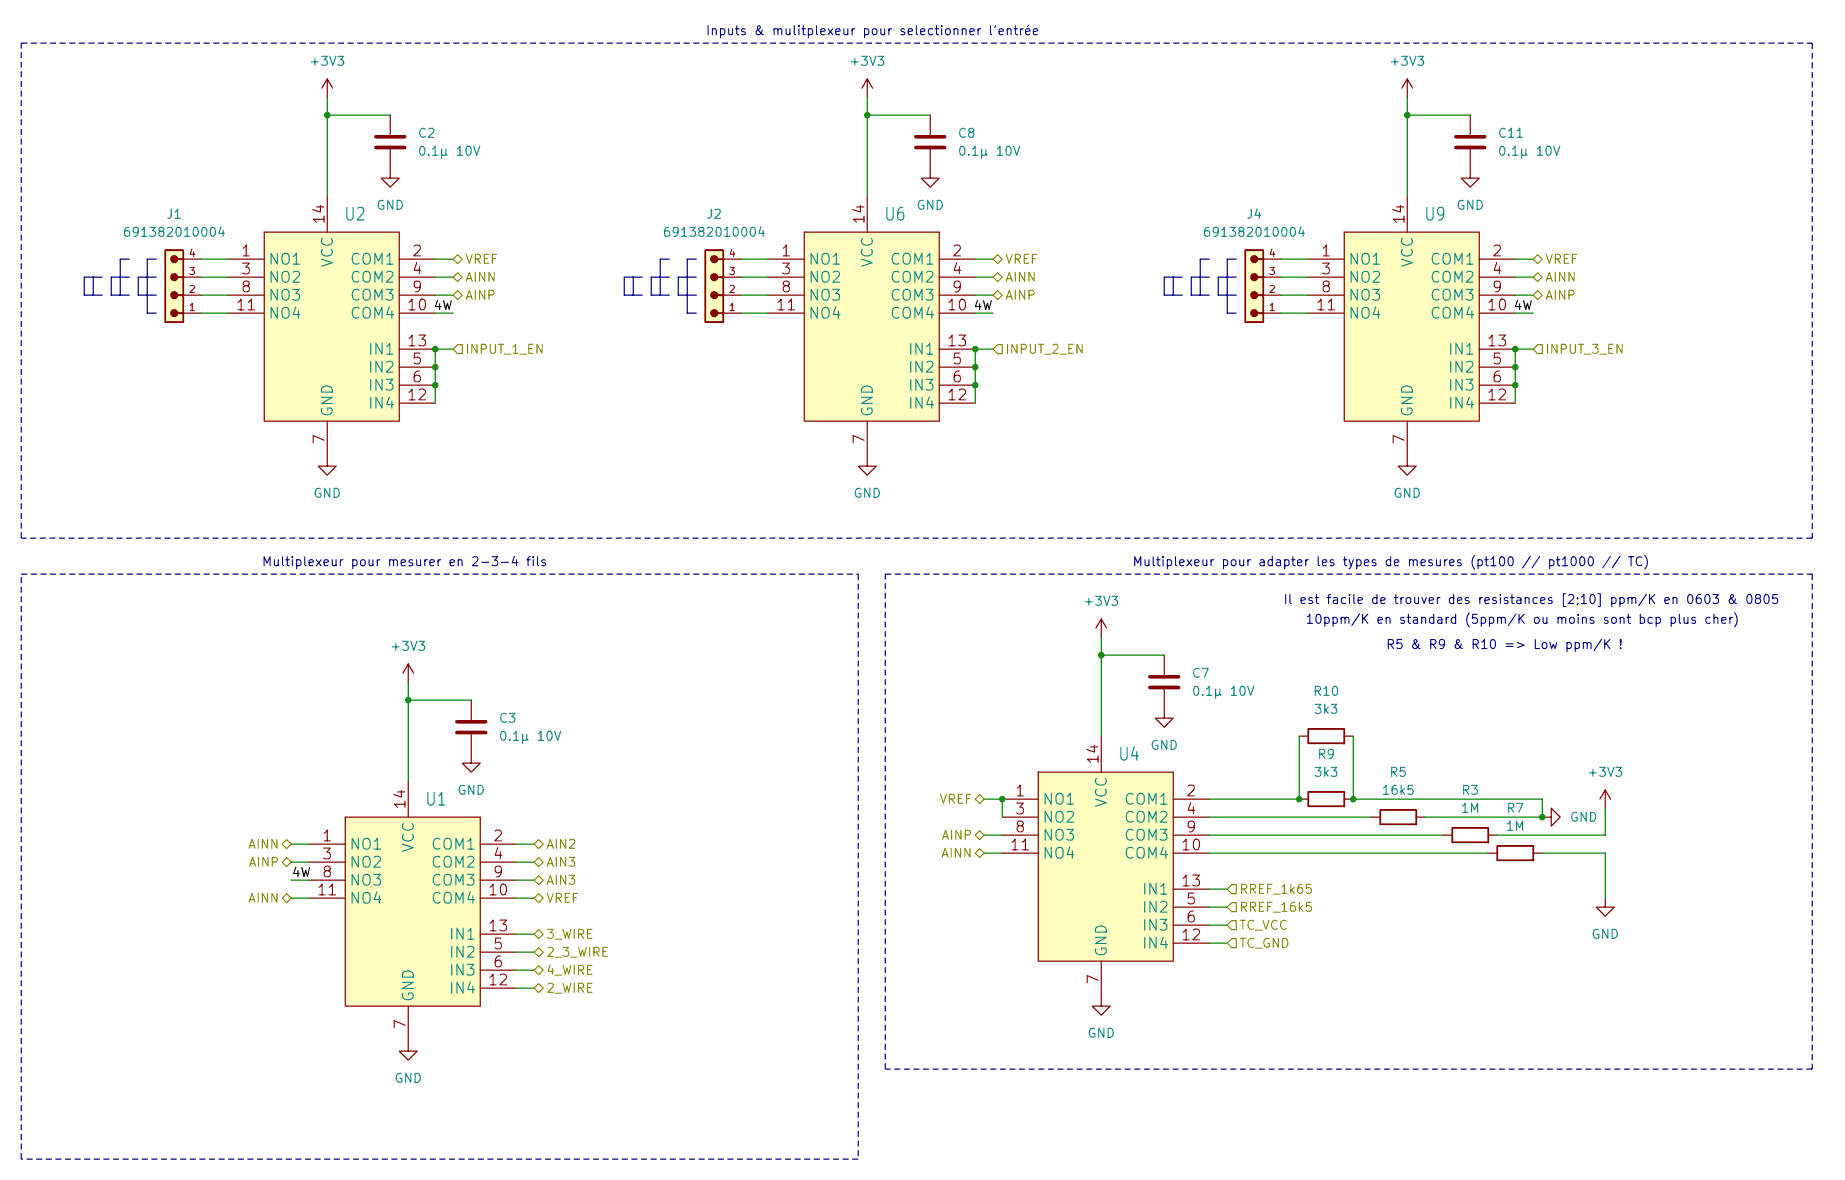
[picture p32: schematic entrees.kicad_sch, Entrées & Mulitplexage]

Parts:
C2, C3, C7, C8, C11: 0.1µ 10V; C_0603_1608Metric_Pad1.08x0.95mm_HandSolder; MPN 885012206020; LCSC Part # C14663
J1, J2, J4: 691382010004; MPN 691382010004
R3, R7: 1M; R_0805_2012Metric; MPN ERJ-3EKF1004V; LCSC Part # C17514
R5: 16k5; R_0805_2012Metric; MPN ERA-6ARB1652V; LCSC Part # C47115532
R9, R10: 3k3; R_0805_2012Metric; MPN ERA-6ARB332V; LCSC Part # C19679588
U1, U2, U4, U6, U9: TS3A4751PWR; TSSOP-14_4.4x5mm_P0.65mm; MPN TS3A4751PWR; LCSC Part # TS3A4751PWR

Connections:
+3V3: C2.1, C3.1, C7.1, C8.1, C11.1, R3.2, U1.14 (VCC), U2.14 (VCC), U4.14 (VCC), U6.14 (VCC), U9.14 (VCC); also elsewhere on the board
/ADC/AIN2: U1.2 (COM1); also elsewhere on the board
/ADC/AIN3: U1.4 (COM2), U1.9 (COM3); also elsewhere on the board
/ADC/AINN: U1.1 (NO1), U1.11 (NO4), U2.4 (COM2), U4.11 (NO4), U6.4 (COM2), U9.4 (COM2); also elsewhere on the board
/ADC/AINP: U1.3 (NO2), U2.9 (COM3), U4.8 (NO3), U6.9 (COM3), U9.9 (COM3); also elsewhere on the board
/ADC/VREF: U1.10 (COM4), U2.2 (COM1), U4.1 (NO1), U4.3 (NO2), U6.2 (COM1), U9.2 (COM1); also elsewhere on the board
/Entrées/2_3_WIRE: U1.5 (IN2); also elsewhere on the board
/Entrées/2_WIRE: U1.12 (IN4); also elsewhere on the board
/Entrées/3_WIRE: U1.13 (IN1); also elsewhere on the board
/Entrées/4W: U1.8 (NO3), U2.10 (COM4), U6.10 (COM4), U9.10 (COM4)
/Entrées/4_WIRE: U1.6 (IN3); also elsewhere on the board
/Entrées/INPUT_1_EN: U2.5 (IN2), U2.6 (IN3), U2.12 (IN4), U2.13 (IN1); also elsewhere on the board
/Entrées/INPUT_2_EN: U6.5 (IN2), U6.6 (IN3), U6.12 (IN4), U6.13 (IN1); also elsewhere on the board
/Entrées/INPUT_3_EN: U9.5 (IN2), U9.6 (IN3), U9.12 (IN4), U9.13 (IN1); also elsewhere on the board
/Entrées/RREF_1k65: U4.13 (IN1); also elsewhere on the board
/Entrées/RREF_16k5: U4.5 (IN2); also elsewhere on the board
/Entrées/TC_GND: U4.12 (IN4); also elsewhere on the board
/Entrées/TC_VCC: U4.6 (IN3); also elsewhere on the board
GND: C2.2, C3.2, C7.2, C8.2, C11.2, R5.2, R7.2, R9.2, R10.2, U1.7 (GND), U2.7 (GND), U4.7 (GND), U6.7 (GND), U9.7 (GND); also elsewhere on the board
unnamed: J1.4, U2.1 (NO1)
unnamed: J1.3, U2.3 (NO2)
unnamed: J1.2, U2.8 (NO3)
unnamed: J1.1, U2.11 (NO4)
unnamed: R9.1, R10.1, U4.2 (COM1)
unnamed: R5.1, U4.4 (COM2)
unnamed: R3.1, U4.9 (COM3)
unnamed: R7.1, U4.10 (COM4)
unnamed: J2.4, U6.1 (NO1)
unnamed: J2.3, U6.3 (NO2)
unnamed: J2.2, U6.8 (NO3)
unnamed: J2.1, U6.11 (NO4)
unnamed: J4.4, U9.1 (NO1)
unnamed: J4.3, U9.3 (NO2)
unnamed: J4.2, U9.8 (NO3)
unnamed: J4.1, U9.11 (NO4)

Notes on the sheet:
R5 & R9 & R10 => Low ppm/K !
Multiplexeur pour adapter les types de mesures (pt100 // pt1000 // TC)
10ppm/K en standard (5ppm/K ou moins sont bcp plus cher)
Il est facile de trouver des resistances [2;10] ppm/K en 0603 & 0805
Multiplexeur pour mesurer en 2-3-4 fils
Inputs & mulitplexeur pour selectionner l'entrée

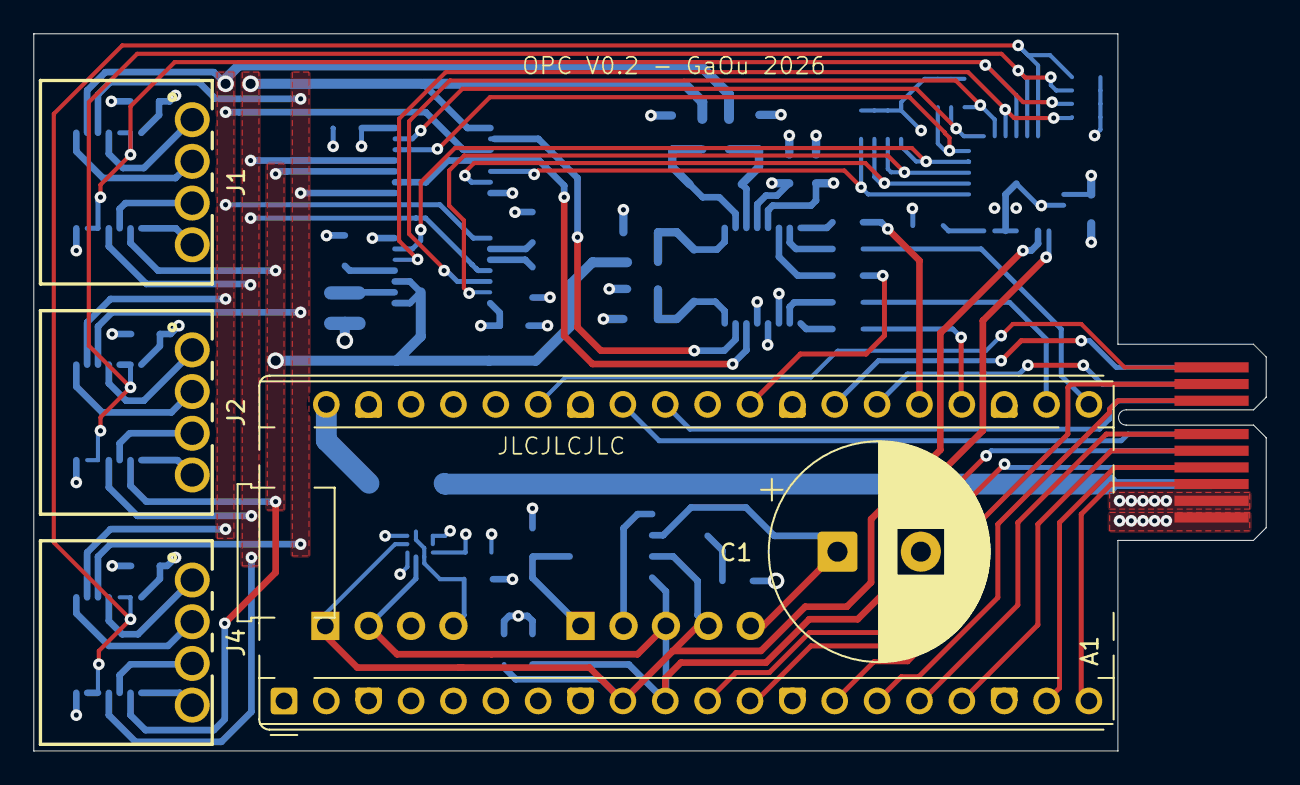
[picture p33: board OPC V3.kicad_pcb from above]

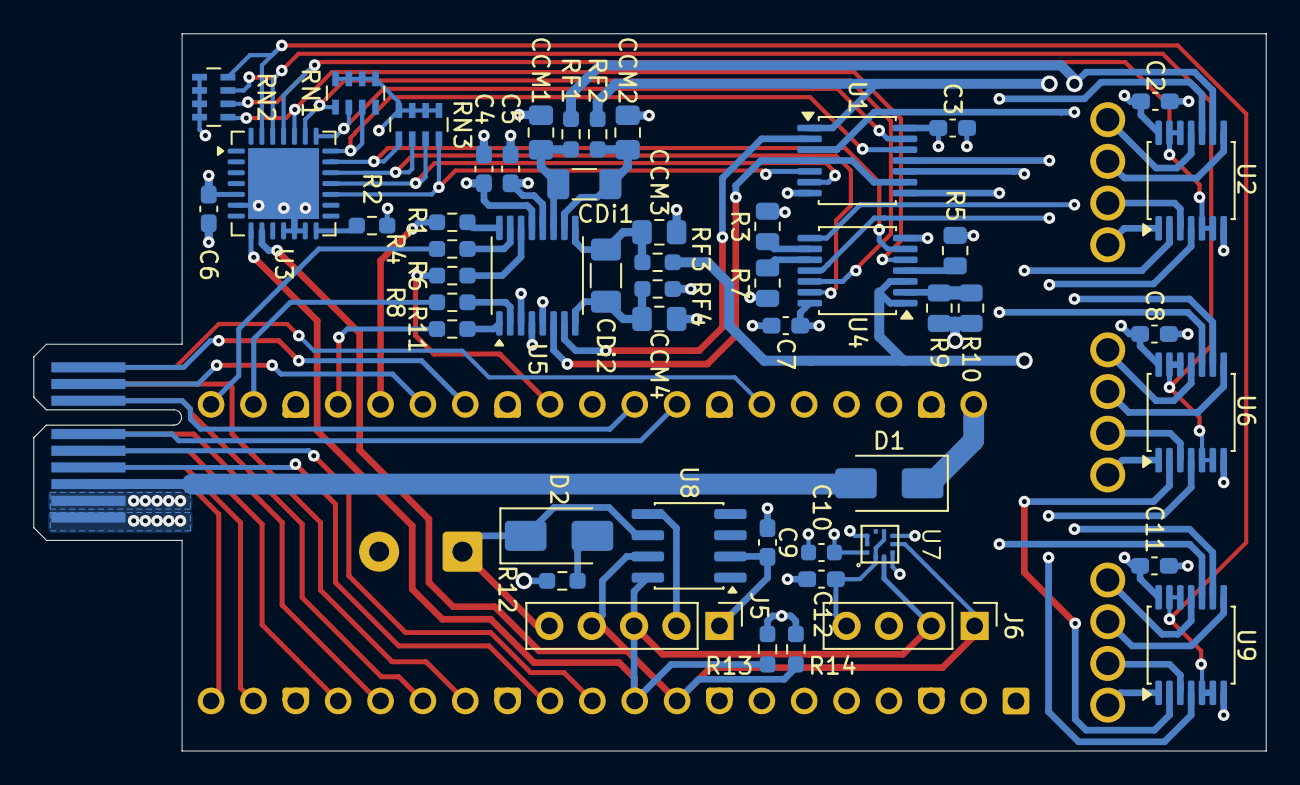
[picture p34: board OPC V3.kicad_pcb from below]

Board: 4 copper layers, 73.9 x 43.0 mm, 57 parts (51 on the bottom side), 69 nets.
