npfs666/OPC_PCB/ecran_FPC.kicad_pcb

## KiCad design ecran_FPC.kicad_pcb (2026-08-16)

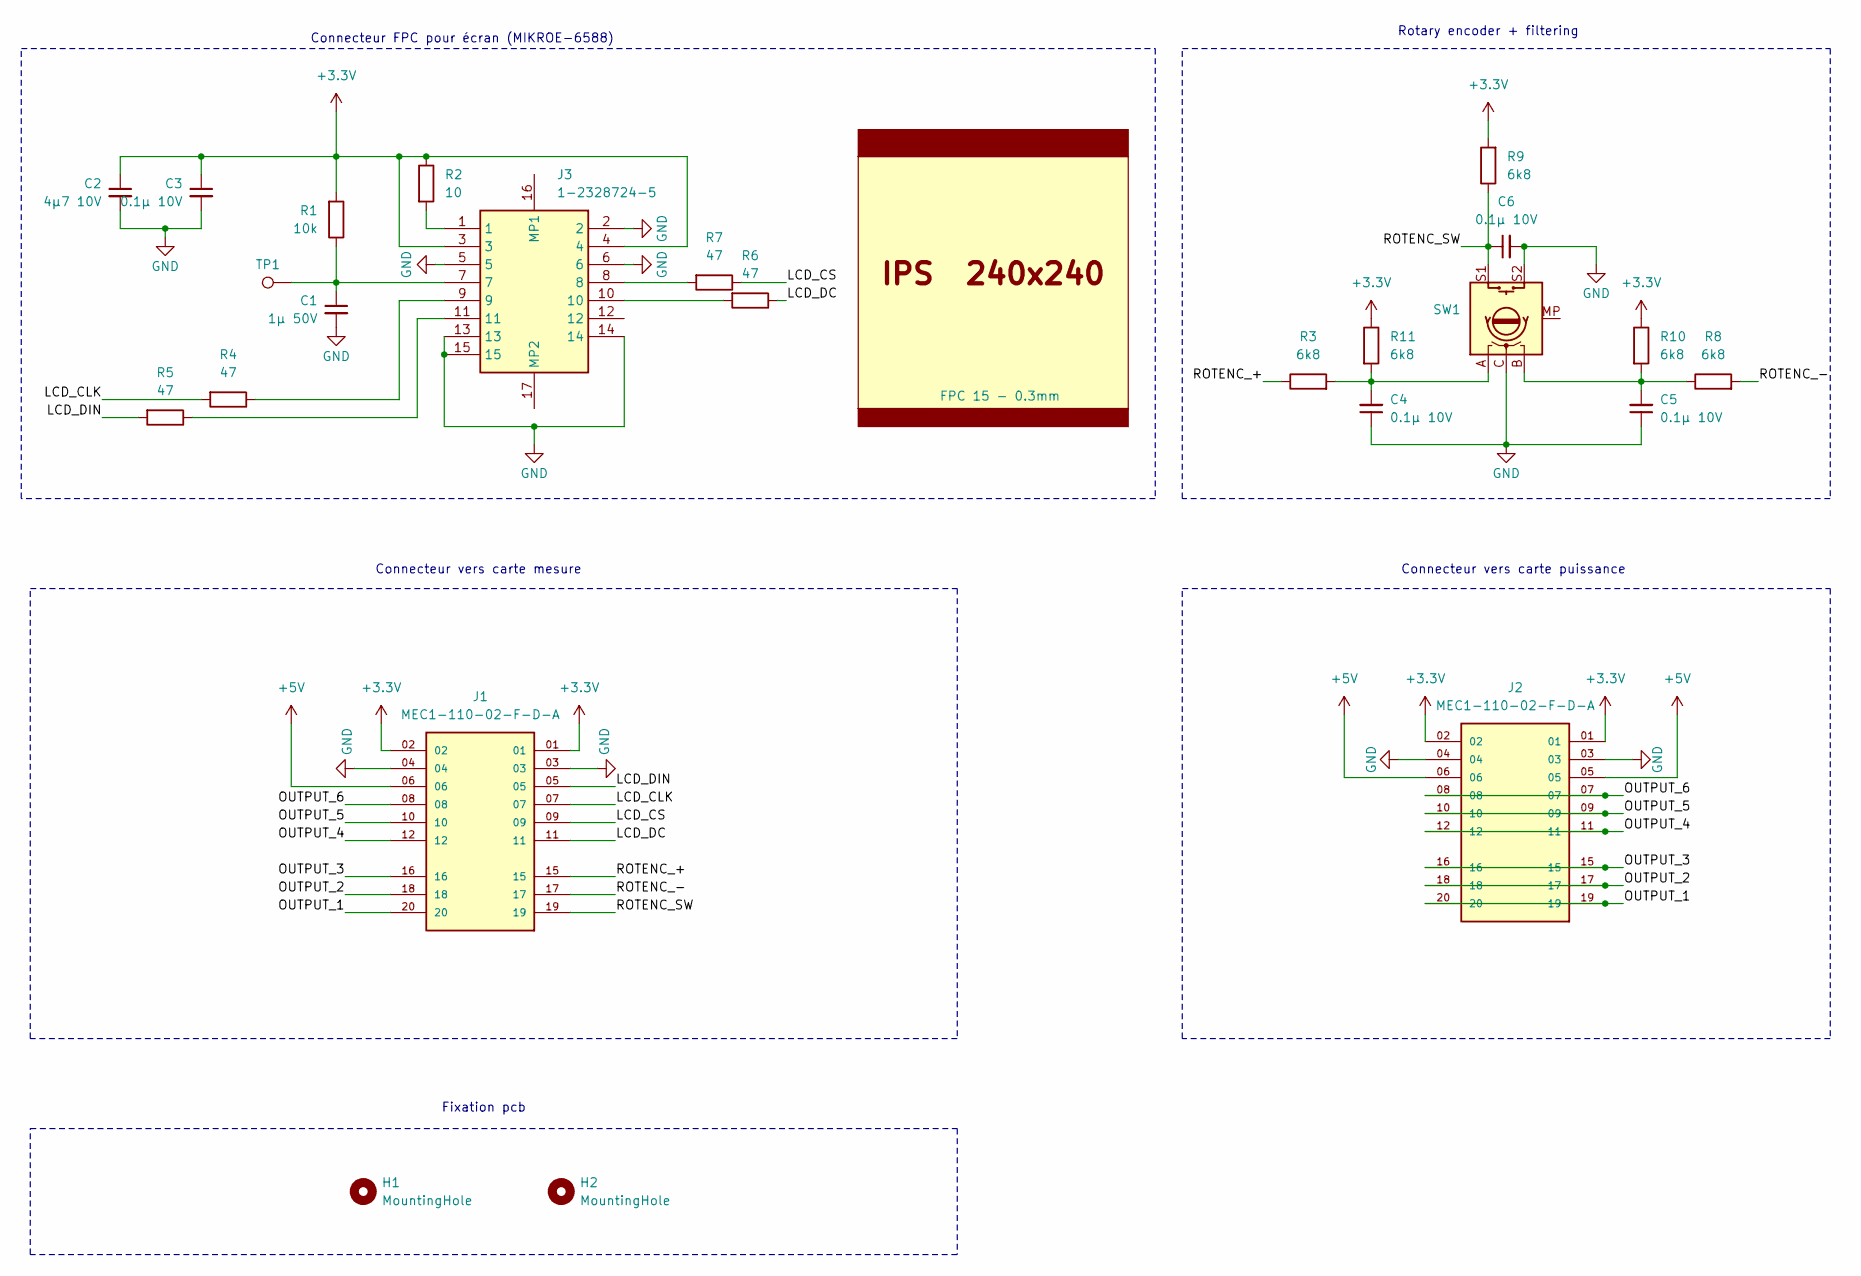
[picture p35: schematic ecran_FPC.kicad_sch]

Parts:
C1: 1µ 50V; C_0805_2012Metric_Pad1.18x1.45mm_HandSolder; MPN GRM219R61H105MA73D; LCSC Part # C28323
C2: 4µ7 10V; C_0805_2012Metric_Pad1.18x1.45mm_HandSolder; MPN GRM21BR71A475KE51K; LCSC Part # C1779
C3, C4, C5, C6: 0.1µ 10V; C_0603_1608Metric_Pad1.08x0.95mm_HandSolder; MPN 885012206020; LCSC Part # C14663
H1, H2: MountingHole; MountingHole_3.2mm_M3_DIN965
J1, J2: MEC1-110-02-F-D-A; SAMTEC_MEC1-110-02-F-D-A; MPN MEC1-110-02-F-D-A
J3: 1-2328724-5; 123287245; Mouser Part Number 571-1-2328724-5
R1: 10k; R_0603_1608Metric_Pad0.98x0.95mm_HandSolder; MPN ERJ-3EKF1002V; LCSC Part # C25804
R2: 10; R_1206_3216Metric_Pad1.30x1.75mm; MPN ERJ-U08J100V; LCSC Part # C17903
R3, R8, R9, R10, R11: 6k8; R_0603_1608Metric_Pad0.98x0.95mm_HandSolder; MPN ERJ-3EKF6801V; LCSC Part # C23212
R4, R5, R6, R7: 47; R_0603_1608Metric_Pad0.98x0.95mm_HandSolder; MPN ERJ-3GEYJ470V; LCSC Part # C23182
SW1: PEC11L-4220F-S0015; PEC11L4220KS0015; MPN PEC11L-4220F-S0015
TP1: TestPoint; TestPoint_Pad_1.5x1.5mm
U2: IPS_240x240; FPC 15 - 0.3mm; MPN MIKROE-6588

Connections:
+3.3V: C2.1, C3.1, J1.01, J1.02, J2.01, J2.02, J3.3, J3.4, R1.2, R2.1, R9.2, R10.1, R11.1
+5V: J1.06, J2.05, J2.06
/LCD_CLK: J1.07, R4.2
/LCD_CS: J1.09, R7.1
/LCD_DC: J1.11, R6.1
/LCD_DIN: J1.05, R5.2
/OUTPUT_1: J1.20, J2.19, J2.20
/OUTPUT_2: J1.18, J2.17, J2.18
/OUTPUT_3: J1.16, J2.15, J2.16
/OUTPUT_4: J1.12, J2.11, J2.12
/OUTPUT_5: J1.10, J2.09, J2.10
/OUTPUT_6: J1.08, J2.07, J2.08
/ROTENC_+: J1.15, R3.1
/ROTENC_-: J1.17, R8.2
/ROTENC_SW: C6.1, J1.19, R9.1, SW1.S1
GND: C1.2, C2.2, C3.2, C4.1, C5.1, C6.2, J1.03, J1.04, J2.03, J2.04, J3.2, J3.5, J3.6, J3.13, J3.14, J3.15, SW1.C, SW1.S2
unnamed: C1.1, J3.7, R1.1, TP1.1 (1_1)
unnamed: C4.2, R3.2, R11.2, SW1.A
unnamed: C5.2, R8.1, R10.2, SW1.B
unnamed: J3.1, R2.2
unnamed: J3.8, R7.2
unnamed: J3.9, R4.1
unnamed: J3.10, R6.2
unnamed: J3.11, R5.1

Notes on the sheet:
Connecteur FPC pour écran (MIKROE-6588)
Connecteur vers carte mesure
Connecteur vers carte puissance
Rotary encoder + filtering
Fixation pcb

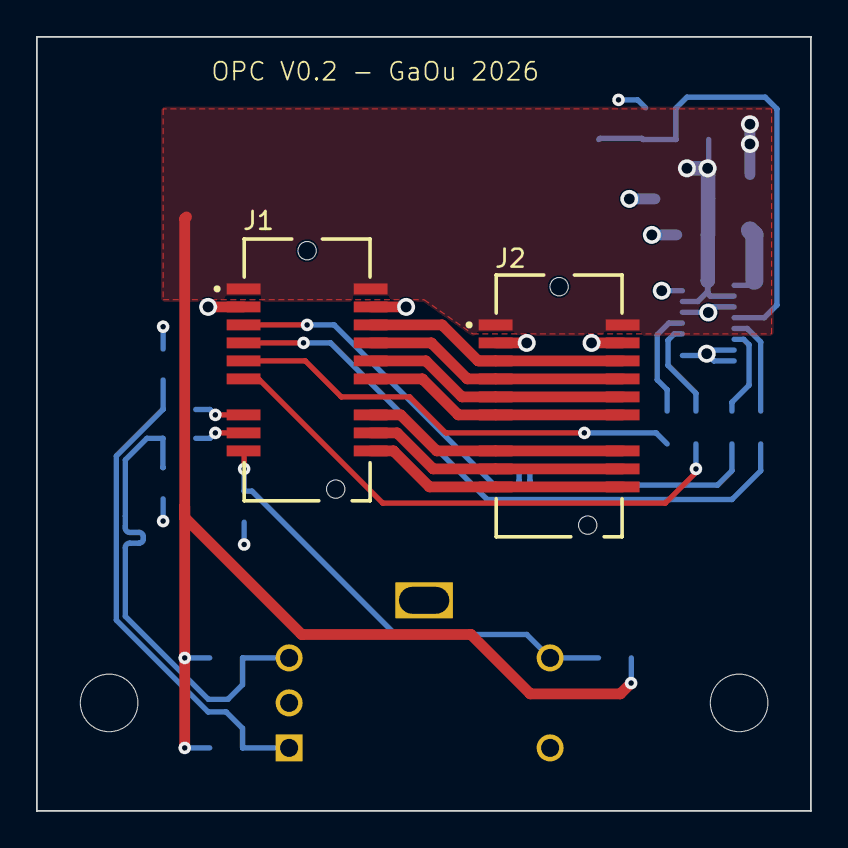
[picture p36: board ecran_FPC.kicad_pcb from above]

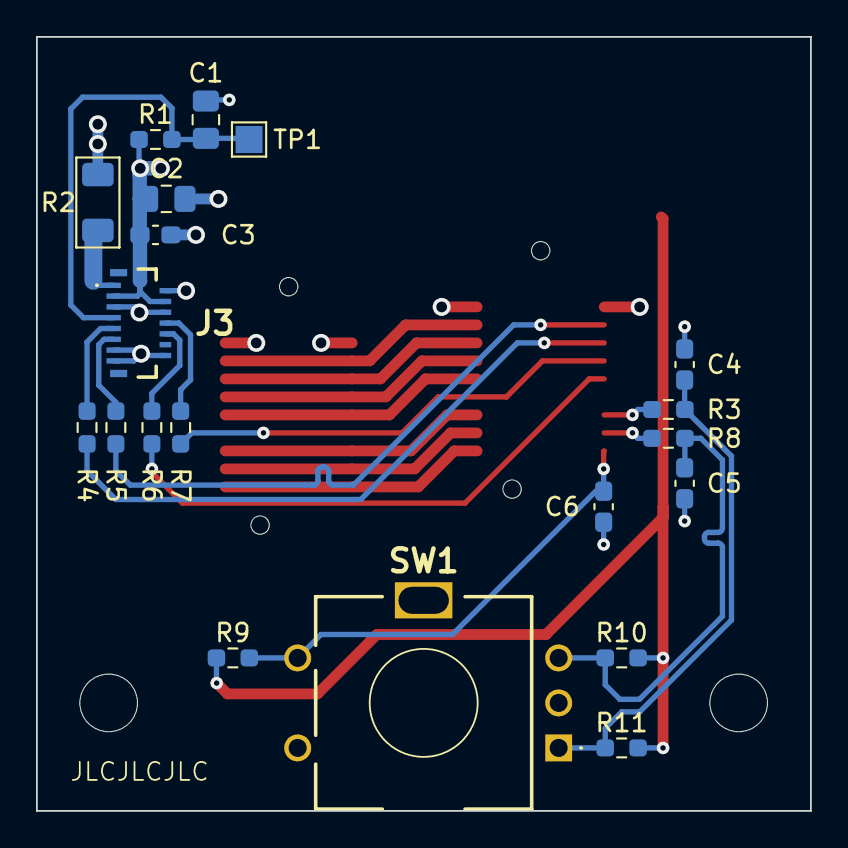
[picture p37: board ecran_FPC.kicad_pcb from below]

Board: 4 copper layers, 43.0 x 43.0 mm, 24 parts (20 on the bottom side), 24 nets.
