npfs666/OPC_PCB/puissance.kicad_pcb

## KiCad design puissance.kicad_pcb (2026-08-16)

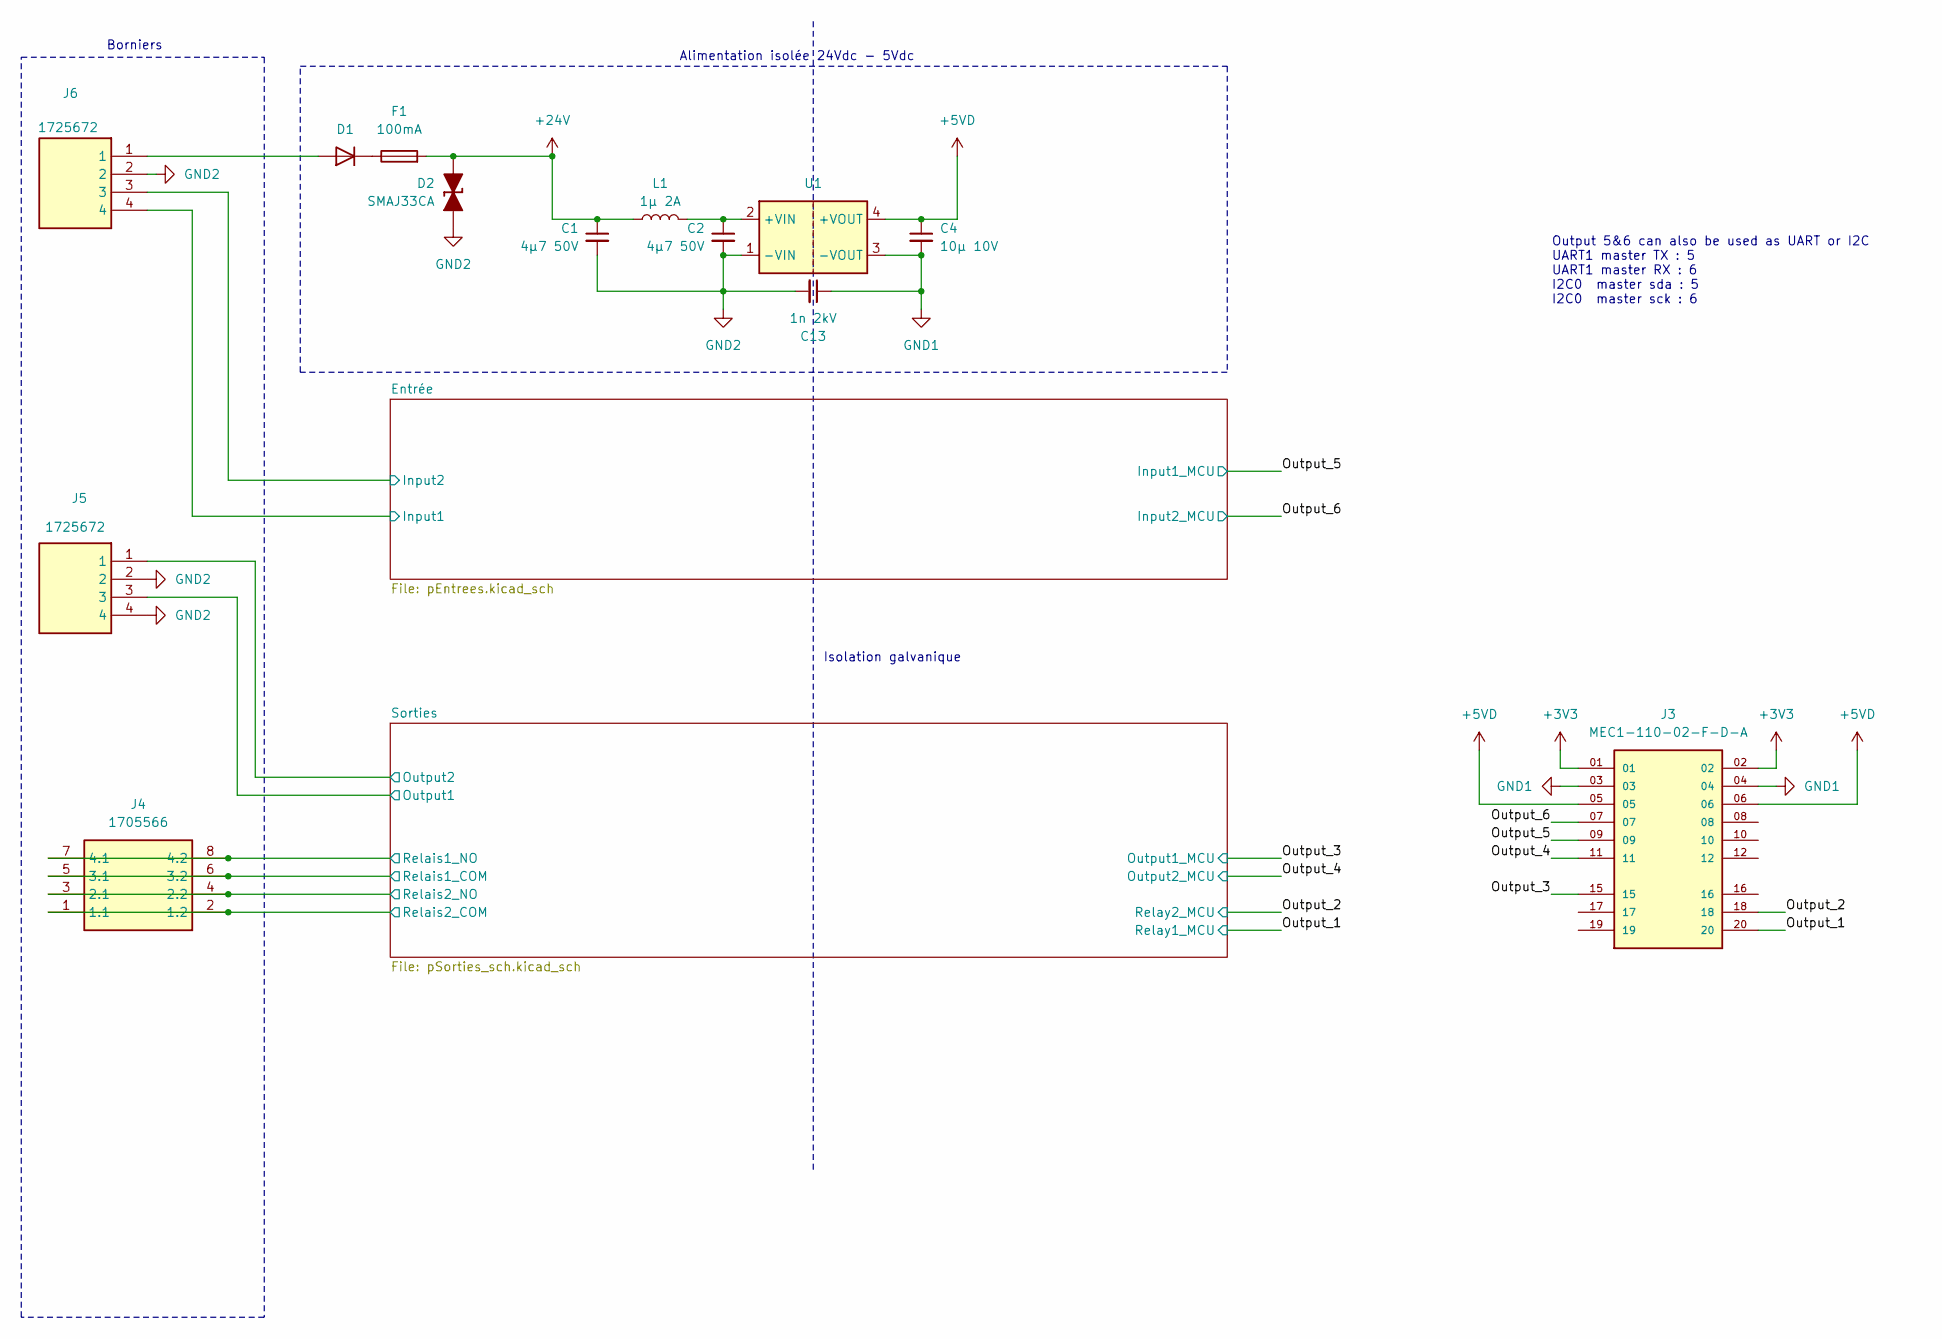
[picture p38: schematic puissance.kicad_sch]

Parts:
C1, C2: 4µ7 50V; C_1206_3216Metric; MPN GRM319R61H475KA12D; LCSC Part # C29823
C4: 10µ 10V; C_0603_1608Metric_Pad1.08x0.95mm_HandSolder; MPN GRM188R61A106ME69D; LCSC Part # C19702
C13: 1n 2kV; C_1206_3216Metric; MPN 885342208024; LCSC Part # C9196
D1: FR1G; D_SMA; MPN FR1G; LCSC Part # C412437
D2: SMAJ33CA; D_SMA_TVS; MPN 824501331
F1: 100mA; Fuse_1210_3225Metric; MPN 0ZCH0010FF2E
J3: MEC1-110-02-F-D-A; MEC1-110-02-F-D-A-MALE
J4: 1705566; Manufacturer_Part_Number 1705566; Mouser Part Number 651-1705566
J5, J6: 1725672; Manufacturer_Part_Number 1725672; Mouser Part Number 651-1725672
L1: 1µ 2A; L_1008_2520Metric; MPN MAMK2520T1R0M; LCSC Part # C162587
U1: 1779205311; U_Wurth_WPME-FISM-SIP-4_1779205311; Part Number 1779205311; LCSC Part # C6652237

Connections:
+3V3: J3.01, J3.02; also elsewhere on the board
+5VD: C4.1, J3.05, J3.06, U1.4 (+VOUT)
+24V: C1.1, D2.1 (K), F1.2, L1.1; also elsewhere on the board
/Entrée/Input1: J6.4; also elsewhere on the board
/Entrée/Input2: J6.3; also elsewhere on the board
/Output_1: J3.20; also elsewhere on the board
/Output_2: J3.18; also elsewhere on the board
/Output_3: J3.15; also elsewhere on the board
/Output_4: J3.11; also elsewhere on the board
/Output_5: J3.09; also elsewhere on the board
/Output_6: J3.07; also elsewhere on the board
/Sorties/Output1: J5.3; also elsewhere on the board
/Sorties/Output2: J5.1; also elsewhere on the board
/Sorties/Relais1_COM: J4.5 (3.1), J4.6 (3.2); also elsewhere on the board
/Sorties/Relais1_NO: J4.7 (4.1), J4.8 (4.2); also elsewhere on the board
/Sorties/Relais2_COM: J4.1 (1.1), J4.2 (1.2); also elsewhere on the board
/Sorties/Relais2_NO: J4.3 (2.1), J4.4 (2.2); also elsewhere on the board
GND1: C4.2, C13.1, J3.03, J3.04, U1.3 (-VOUT); also elsewhere on the board
GND2: C1.2, C2.2, C13.2, D2.2 (A), J5.2, J5.4, J6.2, U1.1 (-VIN); also elsewhere on the board
unnamed: D1.2 (A), J6.1
unnamed: D1.1 (K), F1.1
unnamed: C2.1, L1.2, U1.2 (+VIN)

Notes on the sheet:
Borniers
Output 5&6 can also be used as UART or I2C UART1 master TX : 5 UART1 master RX : 6 I2C0 master sda : 5 I2C0 master sck : 6
Isolation galvanique
Alimentation isolée 24Vdc - 5Vdc

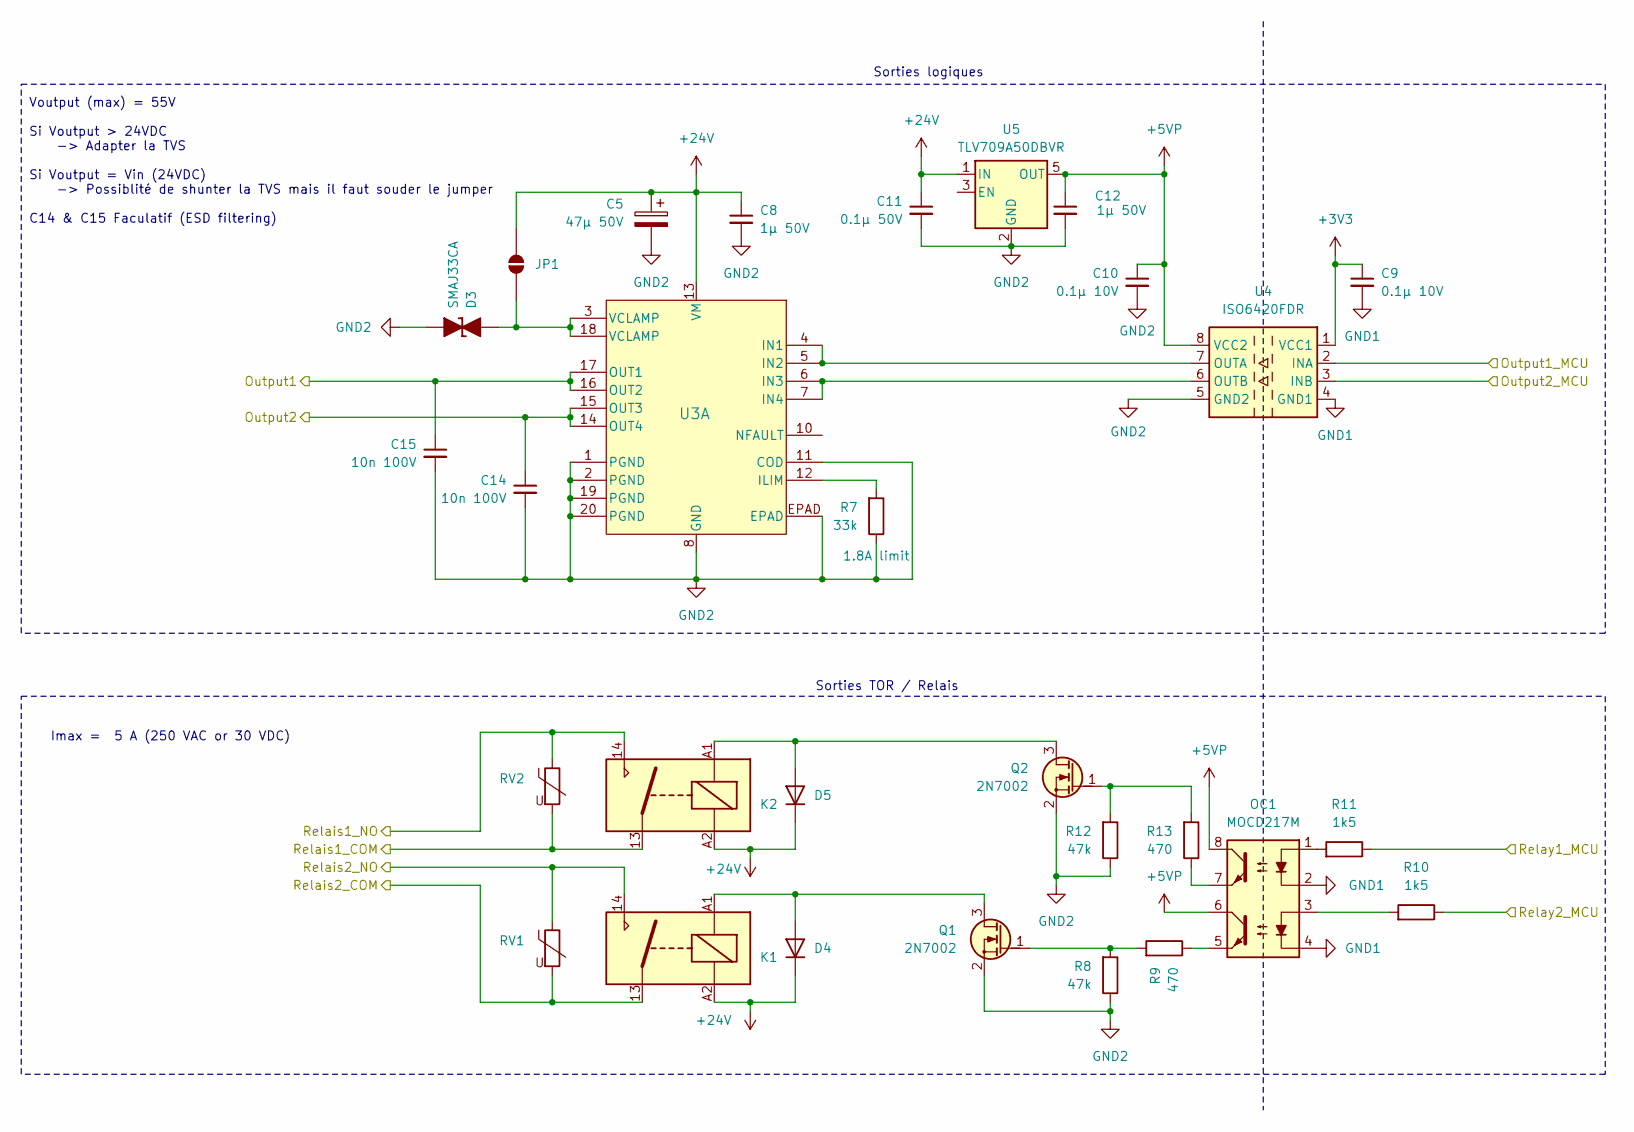
[picture p39: schematic pSorties_sch.kicad_sch, Sorties PWM & Relais]

Parts:
C5: 47µ 50V; CP_Elec_6.3x7.7; MPN 865080645012; LCSC Part # C72523
C8, C12: 1µ 50V; C_0805_2012Metric_Pad1.18x1.45mm_HandSolder; MPN GRM219R61H105MA73D; LCSC Part # C28323
C9, C10: 0.1µ 10V; C_0603_1608Metric_Pad1.08x0.95mm_HandSolder; MPN 885012206020; LCSC Part # C14663
C11: 0.1µ 50V; C_0603_1608Metric_Pad1.08x0.95mm_HandSolder; MPN GCM188L81H104MA57D; LCSC Part # C14663
C14, C15: 10n 100V; C_0603_1608Metric_Pad1.08x0.95mm_HandSolder; MPN GRM188R72A103MA01J; LCSC Part # C57112
D3: SMAJ33CA; D_SMA_TVS; MPN 824501331
D4, D5: FR1G; D_SMA; MPN FR1G; LCSC Part # C412437
JP1: SolderJumper_2_Open; SolderJumper-2_P1.3mm_Open_RoundedPad1.0x1.5mm
K1, K2: G6DN-1A-L DC24; G6DN; MPN G6DN-1A-L DC24
OC1: MOCD217M; SO-8_3.9x6.2mm_P1.27mm; MPN MOCD217M; LCSC Part # C258262
Q1, Q2: 2N7002; SOT-23; MPN T2N7002BK,LM; LCSC Part # C8545
R7: 33k; R_0603_1608Metric_Pad0.98x0.95mm_HandSolder; MPN ERJ-3GEYJ333V; LCSC Part # C4216
R8, R12: 47k; R_0603_1608Metric_Pad0.98x0.95mm_HandSolder; MPN ERJ-3GEYJ473V; LCSC Part # C25819
R9, R13: 470; R_0603_1608Metric_Pad0.98x0.95mm_HandSolder; MPN ERJ-3GEYJ470V; LCSC Part # C23179
R10, R11: 1k5; R_0603_1608Metric_Pad0.98x0.95mm_HandSolder; MPN ERJ-3GEYJ152V; LCSC Part # C22843
RV1, RV2: MOV-07D391KKTR; RV_Disc_D9mm_W3.9mm_P5mm; MPN MOV-07D391KKTR
U3: DRV81545PWPR; U_TSSOP_PWP0020AC_TEX; MPN DRV81545PWPR; LCSC Part # C53201928
U4: ISO6420FDR; SOIC-8_3.9x4.9mm_P1.27mm; MPN ISO6420FDR
U5: TLV709A50DBVR; SOT-23-5; MPN TLV709A50DBVR

Connections:
+3V3: C9.1, U4.1 (VCC1); also elsewhere on the board
+5VP: C10.1, C12.1, OC1.6, OC1.8, U4.8 (VCC2), U5.5 (OUT)
+24V: C5.1, C8.1, C11.1, D4.1 (K), D5.1 (K), JP1.2 (B), K1.A2, K2.A2, U3.13 (VM), U5.1 (IN); also elsewhere on the board
/Output_1: R11.1; also elsewhere on the board
/Output_2: R10.1; also elsewhere on the board
/Output_3: U4.2 (INA); also elsewhere on the board
/Output_4: U4.3 (INB); also elsewhere on the board
/Sorties/Output1: C15.1, U3.16 (OUT2), U3.17 (OUT1); also elsewhere on the board
/Sorties/Output2: C14.1, U3.14 (OUT4), U3.15 (OUT3); also elsewhere on the board
/Sorties/Relais1_COM: K2.13, RV2.2; also elsewhere on the board
/Sorties/Relais1_NO: K2.14, RV2.1; also elsewhere on the board
/Sorties/Relais2_COM: K1.13, RV1.2; also elsewhere on the board
/Sorties/Relais2_NO: K1.14, RV1.1; also elsewhere on the board
GND1: C9.2, OC1.2, OC1.4, U4.4 (GND1); also elsewhere on the board
GND2: C5.2, C8.2, C10.2, C11.2, C12.2, C14.2, C15.2, D3.2 (A), Q1.2 (S), Q2.2 (S), R7.1, R8.1, R12.1, U3.1 (PGND), U3.2 (PGND), U3.8 (GND), U3.11 (COD), U3.19 (PGND), U3.20 (PGND), U3.EPAD, U4.5 (GND2), U5.2 (GND); also elsewhere on the board
unnamed: D3.1 (K), JP1.1 (A), U3.3 (VCLAMP), U3.18 (VCLAMP)
unnamed: D4.2 (A), K1.A1, Q1.3 (D)
unnamed: D5.2 (A), K2.A1, Q2.3 (D)
unnamed: OC1.1, R11.2
unnamed: OC1.3, R10.2
unnamed: OC1.5, R9.1
unnamed: OC1.7, R13.1
unnamed: Q1.1 (G), R8.2, R9.2
unnamed: Q2.1 (G), R12.2, R13.2
unnamed: R7.2, U3.12 (ILIM)
unnamed: U3.4 (IN1), U3.5 (IN2), U4.7 (OUTA)
unnamed: U3.6 (IN3), U3.7 (IN4), U4.6 (OUTB)

Notes on the sheet:
Sorties TOR / Relais
Voutput (max) = 55V Si Voutput > 24VDC -> Adapter la TVS Si Voutput = Vin (24VDC) -> Possiblité de shunter la TVS mais il faut souder le jumper C14 & C15 Faculatif (ESD filtering)
Imax = 5 A (250 VAC or 30 VDC)
Sorties logiques

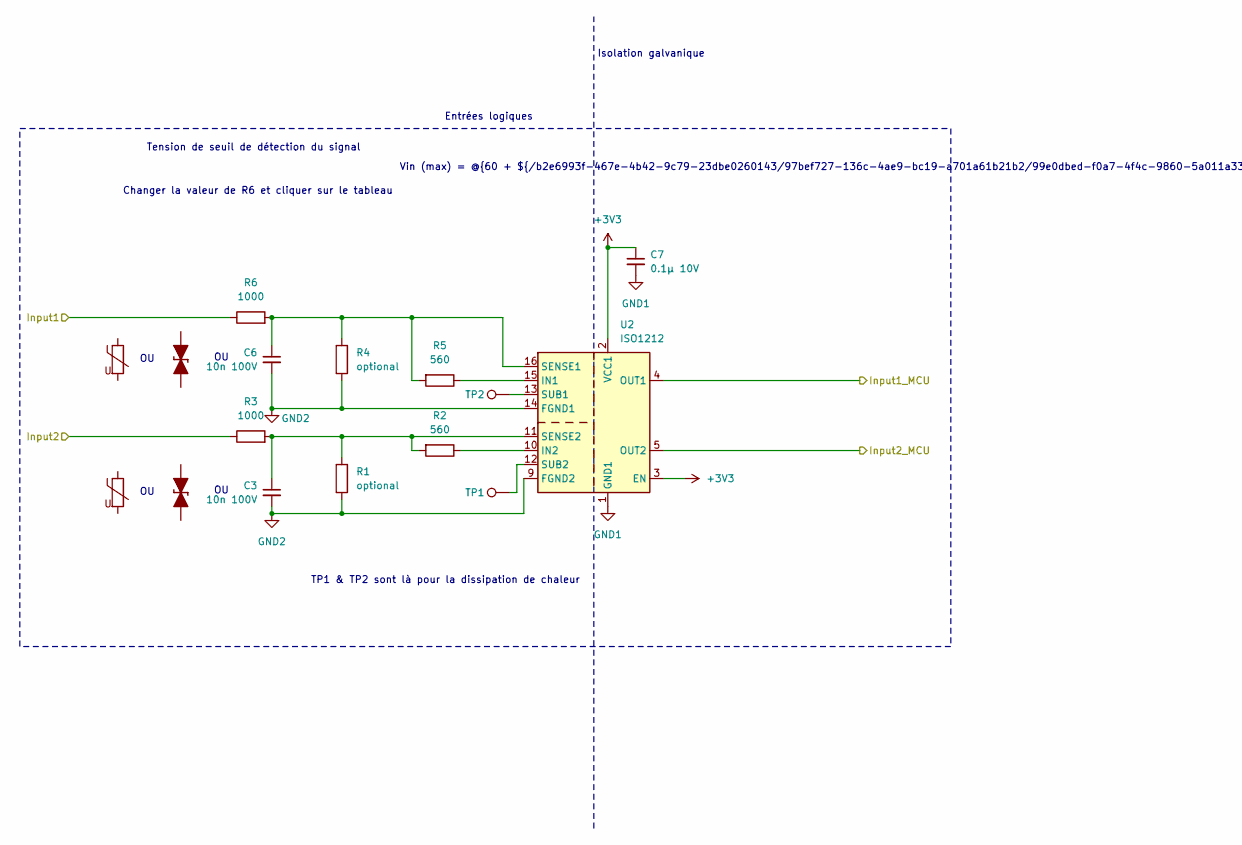
[picture p40: schematic pEntrees.kicad_sch, Entreés numériques, part in row 1, column 1]

Parts:
C3, C6: 10n 100V; C_0603_1608Metric; MPN GRM188R72A103MA01J; LCSC Part # C57112
C7: 0.1µ 10V; C_0603_1608Metric_Pad1.08x0.95mm_HandSolder; MPN 885012206020; LCSC Part # C14663
D10, D11: (no value)
R1, R4: optional; R_0805_2012Metric_Pad1.20x1.40mm_HandSolder
R2, R5: 560; R_0603_1608Metric; MPN ERJ-3GEYJ560V; LCSC Part # C23204
R3, R6: 1000; R_1206_3216Metric; MPN ERJ-6GEYJ242V; LCSC Part # C4410
RV10, RV11: Varistor
TP1, TP2: TestPoint; TestPoint_Pad_2.0x2.0mm
U2: ISO1212; SSOP-16_3.9x4.9mm_P0.635mm; MPN ISO1212DBQR

Connections:
+3V3: C7.1, U2.2 (VCC1), U2.3 (EN); also elsewhere on the board
/Entrée/Input1: R6.1; also elsewhere on the board
/Entrée/Input2: R3.1; also elsewhere on the board
/Output_5: U2.4 (OUT1); also elsewhere on the board
/Output_6: U2.5 (OUT2); also elsewhere on the board
GND1: C7.2, U2.1 (GND1), U2.8 (GND1); also elsewhere on the board
GND2: C3.2, C6.2, R1.1, R4.1, U2.9 (FGND2), U2.14 (FGND1); also elsewhere on the board
unnamed: R5.1, U2.15 (IN1)
unnamed: R2.1, U2.10 (IN2)
unnamed: C6.1, R4.2, R5.2, R6.2, U2.16 (SENSE1)
unnamed: C3.1, R1.2, R2.2, R3.2, U2.11 (SENSE2)
unnamed: TP2.1 (1_1), U2.13 (SUB1)
unnamed: TP1.1 (1_1), U2.12 (SUB2)

Notes on the sheet:
Vin (max) = @{60 + ${/b2e6993f-467e-4b42-9c79-23dbe0260143/97bef727-136c-4ae9-bc19-a701a61b21b2/99e0dbed-f0a7-4f4c-9860-5a011a33f80f:VALUE} * 0.0021 * 562 / ${/b2e6993f-467e-4b42-9c79-23dbe0260143/97bef727-136c-4ae9-bc19-a701a61b21b2/c8e65150-a29e-4934-ab6e-f5d5b94ba4d4:VALUE}}V
Tension de seuil de détection du signal
TP1 & TP2 sont là pour la dissipation de chaleur
Changer la valeur de R6 et cliquer sur le tableau
Isolation galvanique
Entrées logiques

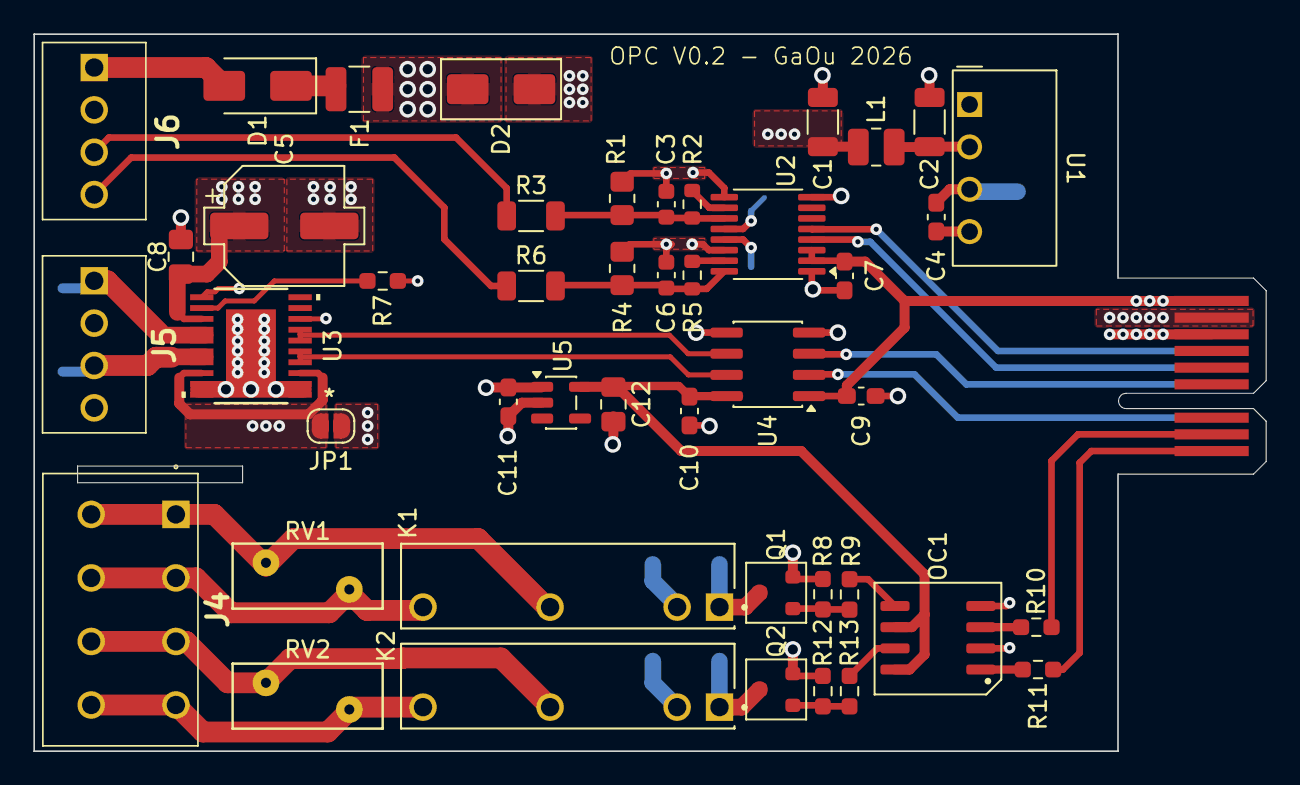
[picture p41: board puissance.kicad_pcb from above]

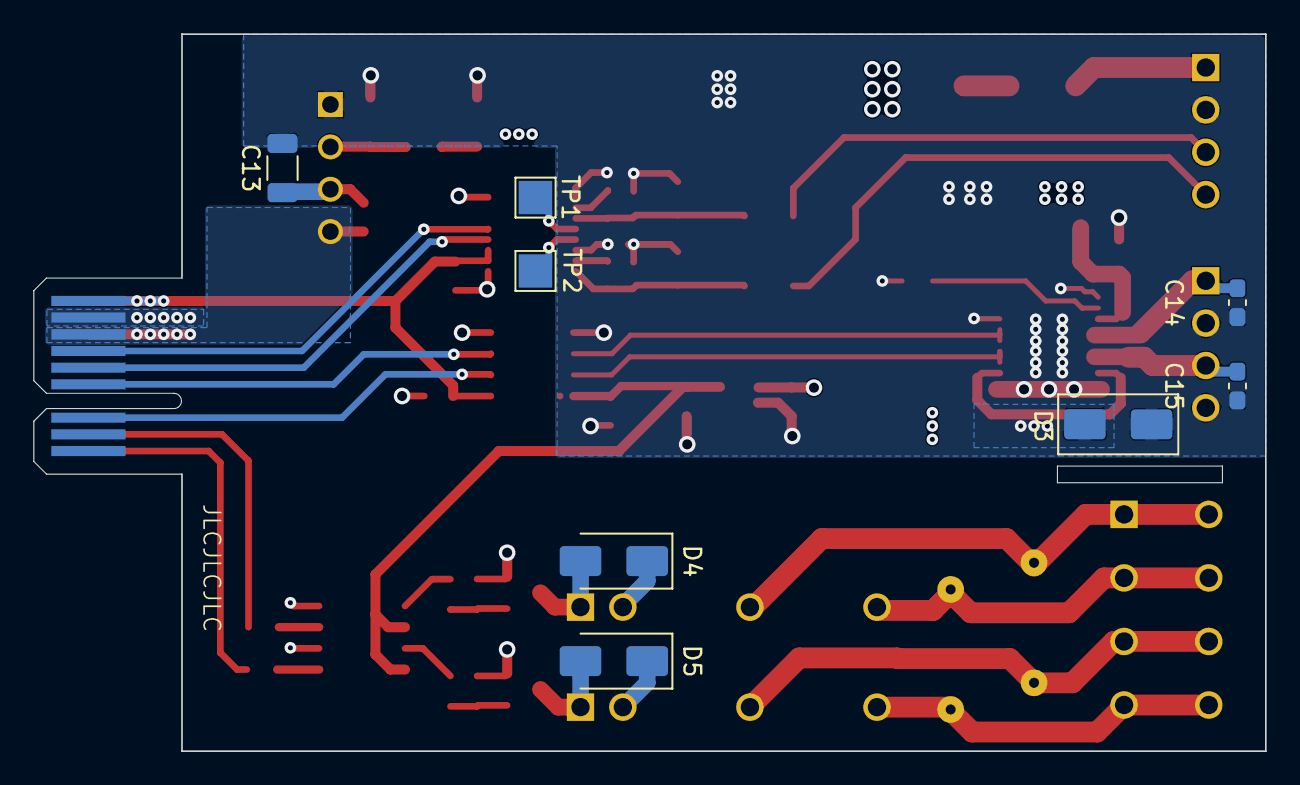
[picture p42: board puissance.kicad_pcb from below]

Board: 4 copper layers, 73.9 x 43.0 mm, 54 parts (9 on the bottom side), 41 nets.
