npfs666/OPC_PCB/(commit log)

2026-08-05 maj puissance
    [OPC V2.kicad_pcb, OPC V2.kicad_sch, adc.kicad_sch, ecran.kicad_pcb, ecran.kicad_sch, pico.kicad_sch]
2026-08-06 découpage et hierarchie
    [OPC V2.kicad_pcb, OPC V2.kicad_sch, adc.kicad_sch, connecteur.kicad_sch, ecran.kicad_pcb, entrees.kicad_sch, pico.kicad_sch, puissance.kicad_pcb]
2026-08-07 assemblage 3d
    [Boitier 3D-Arriere.stl, Boitier 3D-Facade.stl, Boitier 3D.FCStd, OPC V.FCStd, assembly.FCStd, ecran.FCStd, ecran.kicad_pcb, ecran.kicad_sch]
2026-08-11 suite et nouvel écran
    [Boite Mesure.FCStd, Boitier 3D.FCStd, OPC V2.kicad_pcb, OPC.FCStd, OPC_test.FCStd, adc.kicad_sch, assembly.FCStd, assembly_FFC.FCStd]
2026-08-15 avant prod
    [BOM + price.ods, OPC V2.kicad_pcb, adc.kicad_sch, ecran.kicad_pcb, ecran.kicad_sch, ecran_FPC.kicad_pcb, ecran_FPC.kicad_sch, entrees.kicad_sch]
2026-08-16 3d updates
    [OPC_test.FCStd, OPC_test_save.FCStd, assembly.FCStd, assembly_FFC.FCStd, ecran.FCStd, puissance.FCStd]
2026-08-16 pre prod
    [6mm knob.FCStd, Assemblage.FCStd, Barofnet-back.stl, Barofnet-front.stl, Boite Mesure-haut.stl, Boitier 3D-Arriere.stl, Boitier 3D-Facade.stl, Boitier_OPC-Facade45.step]
2026-10-04 MAJ post prod
    [6mm knob.FCStd, Assemblage.FCStd, Boite Mesure-Body.step, Boitier_OPC.FCStd, OPC V3.kicad_pcb, OPC V3.kicad_sch, adc.kicad_sch, connecteur.kicad_sch]
